currygood/MusicPlaySyncSpeakers/完整项目文档.md

说明：音频主节点具备完整功能；出于成本考虑，从节点使用现有的 ESP32-S3 开发板（如 ESP32-S3-N16R8），放弃“无主节点时切换为蓝牙模式、让手机连接播放音频”的功能，仅工作于同步模式：主节点启动并发送音频后，从节点接收并同步播放。语音唤醒与麦克风链路（esp-sr 唤醒词 + INMP441 采集 + HFP 上行）已整链路下线，主节点不再具备语音唤醒功能。

手机热点大概率不能当“路由器”做测试：音频虽是单播，但控制（5679）与灯控（8889）走组播，热点常把组播掐掉。

# ESP32 双设备无线音频同步系统 项目文档

> **项目定位**：基于 ESP32 的双设备无线音频同步系统，支持蓝牙音乐接收、本地 SD 卡解码播放，以及 **WiFi 单播音频同步分发**，实现两台音箱无感知同步播放，为低成本全屋智能音频系统提供可扩展的解决方案。

------

## 📖 项目概述

1. 本项目设计并实现了一套集**双设备无线音频同步**与**全屋智能家居联动**于一体的综合系统。系统包含三个核心节点：

   - **音频主节点（Master）**：ESP32-WROVER-E-N16R8，负责蓝牙 A2DP 音频接收、SD 卡本地解码、UDP 逐台单播分发，以及通过 UI 界面发起灯控指令。
   - **音频从节点（Slave）**：ESP32-WROVER-E-N16R8（与主节点同款，靠 NVS 角色配置区分；开发阶段先用现成的 ESP32-S3 开发板替代验证），接收主节点**单播**的 PCM 音频数据，按帧内基准播放时刻对齐出声，实现无感知同步播放。
   - **灯控节点（Light Controller）**：**ESP8266**，同时支持**局域网 UDP 组播接收**（来自音频主节点 UI 屏幕控制）和**巴法云 MQTT 接入**（来自米家 App / 小爱同学语音控制），通过**继电器**控制灯具开关（只有开 / 关，不调亮度）。

   ### 核心创新

   1. **高精度音频同步**：主节点给每一帧 PCM 打上统一的基准播放时刻 `t_play_us`，逐台单播到各从节点；从节点用「最小单程延迟」把主节点时间换算成本地时间，按同一时刻出声，全程不需要回包对时。主从残差只剩两端最小单程延迟之差（局域网 1~3ms），长期漂移用丢/插单个样点补偿。
   2. 双通道灯控闭环：
      - **本地 UI 控制链路**：ESP32 主节点 UI 界面 → UDP 组播（`239.0.0.2:8889`）→ ESP8266 灯控节点（局域网低延迟，不依赖公网）
      - **云端控制链路**：米家 App / 小爱同学 → 米家云 → 巴法云 MQTT → ESP8266 灯控节点（不经过 ESP32 主节点，接入米家生态）
   3. **WiFi 多路复用**：ESP32-WROVER-E-N16R8 的 WiFi 协议栈（lwIP）同时承载高实时性的 UDP 音频单播（逐台发往从节点 `:5680`）、UDP 控制组播（`239.0.0.1:5679`）与 UDP 灯控组播（`239.0.0.2:8889`）。

### 核心功能一览

| 功能模块 | 说明 |
| --- | --- |
| 蓝牙音频接收（A2DP Sink） | 主节点接收手机/平板蓝牙音频流 |
| 双设备音频同步（WiFi 单播） | 主节点把 PCM 逐台单播给各从节点，帧内带基准播放时刻，主从按同一时刻出声，回包为零 |
| **UI 屏幕灯控（UDP 组播）** | **主节点 UI 界面通过 UDP 组播控制 ESP8266 灯光，局域网低延迟** |
| **米家智能家居接入** | **ESP8266 通过巴法云 MQTT 接入米家生态，支持小爱同学语音控制** |
| 本地音乐播放（SD 卡） | 主节点播放 SD 卡 `/music` 下的 MP3（minimp3 解码，当前不支持 WAV），从节点无卡 |
| 播放控制（AVRCP） | 全局控制（播放/暂停/切歌/音量），同步至从节点 |
| LVGL 触摸屏界面 | 只有主音频节点配备 2.8 寸触摸屏，显示播放状态及**灯控入口**  |
| 双备份 OTA 升级 | 支持 WiFi 远程升级，具备失败自动回滚能力 |
| 节点角色配置 | 通过 NVS 存储角色标识，同一固件可配置为主节点或从节点 |

### 系统架构图

```reStructuredText
 ┌─────────────────────────────────────────────────────────────────┐
 │                         手机（音频源）                          │
 │                       (蓝牙 A2DP / AVRCP)                       │
 └──────────────────────────────┬──────────────────────────────────┘
                                │ 蓝牙音频流（SBC → PCM）
                                ▼
 ┌─────────────────────────────────────────────────────────────────┐
 │              主节点 (Master) - 房间 A                           │
 │  ┌───────────────────────────────────────────────────────────┐ │
 │  │           ESP32-WROVER-E-N16R8                             │ │
 │  │  • 蓝牙 A2DP 接收 / SD 卡解码 / I2S 功放本地播放          │ │
 │  │  • UDP 单播发送 (PCM + t_play_us) → 各从节点              │ │
 │  │  • 触摸屏 UI (LVGL)                                       │ │
 │  │  • 灯控入口（屏幕点一下开关灯）                           │ │
 │  └───────────────────────────────────────────────────────────┘ │
 └───────┬──────────────────────┬──────────────────────┬──────────┘
         │                      │                      │
         │ 链路①：音频同步     │ 链路②：UI 灯控      │ 链路③：云端灯控
         │ UDP 单播             │ UDP 组播             │ 米家 App / 小爱同学
         │ 各从机 :5680         │ 239.0.0.2:8889       │ → 米家云 → 巴法云 MQTT
         │ (PCM 音频数据)       │ (JSON 灯控指令)      │
         ▼                      ▼                      ▼
┌──────────────────┐   ┌──────────────────┐   ┌─────────────────┐
│  从节点 (Slave)  │   │                  │   │   米家云        │
│  - 房间 B        │   │                  │   │                 │
│                  │   │                  │   └────────┬────────┘
│ • UDP 单播接收   │   │                  │            │
│ • Jitter Buffer  │   │                  │            ▼
│ • 时间戳同步     │   │                  │   ┌─────────────────┐
│ • I2S 功放播放   │   │                  │   │  巴法云 MQTT    │
└──────────────────┘   │                  │   │  (bemfa.com)    │
                       │                  │   └────────┬────────┘
                       │                  │            │
                       │  链路② 直达      │  链路③ 直达│
                       │  (本地低延迟)    │  (云端控制)│
                       └────────┬─────────┴──────┬─────┘
                                │                │
                                ▼                ▼
                   ┌─────────────────────────────────────────────┐
                   │         ESP8266 智能灯控节点                │
                   │                                             │
                   │  ┌─────────────────────────────────────┐   │
                   │  │ 接收通道 1：UDP 组播 (239.0.0.2)    │   │
                   │  │ 来源：ESP32 主节点 UI 屏幕点击      │   │
                   │  │ 延迟：毫秒级（局域网直连）          │   │
                   │  └──────────────────┬──────────────────┘   │
                   │                     │                       │
                   │                     ▼                       │
                   │           ┌──────────────────┐              │
                   │           │ 指令融合处理     │              │
                   │           │ LED_Control_     │              │
                   │           │ Set_Light()      │              │
                   │           └────────┬─────────┘              │
                   │                     ▲                       │
                   │                     │                       │
                   │  ┌──────────────────┴──────────────────┐   │
                   │  │ 接收通道 2：巴法云 MQTT 订阅        │   │
                   │  │ 来源：米家 App / 小爱同学           │   │
                   │  │ 延迟：200~500ms（受公网影响）       │   │
                   │  └─────────────────────────────────────┘   │
                   │                                             │
                   │  输出：单路继电器（开 / 关）                │
                   └──────────────┬──────────────────────────────┘
                                 │
                                 ▼
                      ┌────────────────────┐
                      │  卧室灯（继电器）  │
                      │  开 / 关，不调光   │
                      └────────────────────┘
```

------

## 🧩 硬件要求

### 核心组件

| 组件 | 型号 | 说明 |
| :--- | :--- | :--- |
| **主控** | ESP32-WROVER-E-N16R8 | ESP32-D0WD 芯片，双核 240MHz，16MB Flash + 8MB PSRAM，支持蓝牙 v4.2 双模（BR/EDR + BLE），集成 802.11 b/g/n Wi-Fi |
| **显示屏** | 2.8 寸 IPS SPI 模块（ILI9341） | 320×240 分辨率，4 线 SPI，自带 Micro SD 卡槽 。只有音频主节点有 |
| **触摸屏** | 电容触摸（FT6336G） | I²C 接口 |
| **音频功放** | NS4168 | I2S 数字输入，单声道 D 类，2.5W 输出，内置 DAC |
| **存储卡** | Micro SD 卡（SPI 模式） | FAT32 格式，存放音频文件（/music）；UI 图片放 Flash storage 分区 |
| **扬声器** | 4Ω 3W 喇叭 | 单声道输出 |
| **电源** | 设计的板子有电源，用电池供电，可充电 | 为整板供电 |

> **⚠️ 重要提示**：
>
> - 通过 **NVS 配置区分角色**（主/从）。
> - 主从节点都不需要麦克风：语音唤醒链路已整链路下线。
> - UI 图片资源（3 张 PNG）随固件烧录进 Flash storage 分区，字体编译进固件；音乐文件从 SD 卡加载，Flash 双备份 OTA 不变。
> - 两个节点需连接**同一 WiFi 路由器**（同一局域网）：音频走单播，控制（5679）与灯控（8889）走组播。

### 显示屏模块详解（LCDWiki 2.8 寸 IPS SPI 模块）

该模块基于 **ILI9341V** 驱动芯片，采用 4 线制 SPI 串行总线，板载电平转换电路，兼容 5V 和 3.3V MCU。

**关键参数：**

| 参数 | 规格 |
| :--- | :--- |
| 屏幕尺寸 | 2.8 inch |
| 屏幕类型 | IPS（全视角） |
| 分辨率 | 240 × RGB × 320 (pixels) |
| 驱动 IC | ILI9341V |
| 显示接口 | 4-Line SPI |
| 最大颜色数  | 262K |
| 背光亮度 | 280 cd/m² |
| 触摸屏类型  | 电容触摸 |
| 触摸驱动 IC | FT6336G |
| 触摸接口 | I²C |
| **SD 卡槽** | 自带 Micro SD 卡槽，支持 SPI 模式 |

### 显示屏模块引脚定义

| 序号 | 引脚 | 功能说明 |
| :--- | :--- | :--- |
| 1 | VCC | 屏电源正（3.3V 或 5V） |
| 2 | GND | 屏电源地 |
| 3 | LCD_CS | 液晶屏片选控制信号，低电平有效 |
| 4 | LCD_RST | 液晶屏复位控制信号，低电平复位 |
| 5 | LCD_RS | 液晶屏命令/数据选择控制信号（DC） |
| 6 | SDI (MOSI) | SPI 数据输入 |
| 7 | SCK | SPI 时钟信号 |
| 8 | LED | 背光控制信号 |
| 9 | SDO (MISO) | SPI 数据输出 |
| 10 | T_IRQ | 触摸屏中断信号 |
| 11 | T_DO | 触摸屏 I²C 数据（或 SPI MISO） |
| 12 | T_DIN | 触摸屏 I²C 数据（或 SPI MOSI） |
| 13 | T_CS | 触摸屏片选（I²C 模式可不接） |
| 14 | T_SCK | 触摸屏时钟（I²C 模式为 SCL） |

### NS4168 音频功放详解

NS4168 是一款支持 I2S 数字音频信号输入、输出具有防失真功能的单声道 D 类音频功率放大器。

**关键特性：**

- **内置 DAC**：可直接接收 ESP32 的 I2S 数字音频信号并进行放大，无需外接其他解码芯片
- **工作电压**：3.0V ~ 5.5V
- **输出功率**：最高 2.5W（VDD=5V, RL=4Ω）
- **信噪比**：85dB
- **总谐波失真+噪声**：0.2%
- **采样率支持**：8kHz ~ 96kHz
- **功放类型**：D 类，无滤波器架构

**引脚定义：**

| 引脚  | 名称  | 功能 |
| :---- | :---- | :--- |
| Pin 1 | CTRL  | 控制/静音引脚（高电平使能，拉低静音） |
| Pin 2 | LRCLK | I2S 帧时钟（左右声道时钟） |
| Pin 3 | BCLK  | I2S 位时钟 |
| Pin 4 | SDATA | I2S 串行音频数据输入 |
| Pin 5 | VON | BTL 输出负端 |
| Pin 6 | VDD | 主供电引脚 |
| Pin 7 | GND | 信号地 |
| Pin 8 | VOP | BTL 输出正端 |
| Pin 9 | EP | 底部散热焊盘，连接大面积地平面 |

## 🔌 完整引脚接线表(完全针对项目，不需要使用完全上面提到的引脚)

> **⚠️ 重要说明**：ESP32-WROVER-IB 内部 SPI Flash 占用 **GPIO6~11**，这些引脚**不可用于外部电路**。以下分配已避开所有受限引脚。

### 推荐引脚分配（主节点 & 从节点通用，从节点省略触摸屏、SD卡）

| 模块 | 信号 | GPIO | 备注 |
| :--- | :--- | :--- | :--- |
| **LCD (SPI)** | LCD_CS | 4 | 片选 |
| | LCD_RST | 25 | 复位，不能少 |
| | LCD_RS (DC) | 22 | 命令/数据选择 |
| | MOSI | 18 | SPI 数据输入（与 SD 卡共用总线） |
| | SCK | 19 | SPI 时钟（与 SD 卡共用总线） |
| | MISO | 21 | SPI 数据输出（与 SD 卡共用总线） |
| | LED | 23 | 背光开关（只做开/关，不做 PWM 调光；Strapping 脚需谨慎） |
| **SD 卡 (SPI)** | SD_CS | 15 | 片选（与 LCD 分时复用 SPI 总线） |
| **触摸屏 (I²C)** | CTP_SDA | 32 | I²C 数据 |
| | CTP_SCL | 33 | I²C 时钟 |
| | CTP_INT | 轮询 | 触摸中断（可选）  用轮询 |
| | CTP_RST | 25 | 电容触摸屏复位控制信号，低电平复位 。不能少！！！，必须要软件复位，它不会自动复位 |
| **功放 (I2S)** | BCLK | 26 | I2S 位时钟 |
| | LRCLK | 27 | I2S 左右声道时钟 |
| | SDIN | 13 | I2S 数据输入 |
| | MCLK | 悬空 | 主时钟（NS4168 内部可倍频，无需外接） |
| 按键1 | 一端 | 36 | 另一端是GND，低电平有效，pcb设计要有上拉电阻，因为这个gpio口只有输入功能，里面没有内部上拉/下拉 |
| **电源** | VCC | - | 3.3V / 5V（按模块要求） |
| | GND | - | 公共地 |

1. **共用复位（GPIO 25）的时序兼容**： LCD 和触摸屏共用 GPIO 25 复位时，需确保两者的复位逻辑一致（均为低电平复位）。软件拉低 GPIO 25 后，**必须保持足够的低电平时间（建议 >20ms）**，以同时满足 LCD 和触摸屏的复位脉冲宽度要求，然后再拉高。   **直接一起在LCD屏复位的时候复位即可，后面初始化触摸屏就不需要复位了。**

2. Strapping 引脚的外部电路禁忌

   ： 对于使用的 Strapping 引脚（GPIO 15, 2, 5），外部电路绝对不能添加与之冲突的上下拉电阻。

   - **GPIO 15 (SD_CS)**：外部**严禁**接地或接下拉电阻，必须依靠内部上拉或外部上拉保持高电平。
   - **GPIO 2 (MIC_CLK)**：外部**严禁**接上拉电阻，必须依靠内部下拉或外部下拉保持低电平。
   - **GPIO 5 (MIC_WS)**：外部**严禁**接地或接下拉电阻。

3. **再次警告 GPIO 12**： 无论引脚多么紧张，**绝对不要**将任何外设分配到 GPIO 12。上电时若被拉高，会将模组内部 Flash/PSRAM 的供电电压强制切换为 1.8V，导致模组直接“变砖”且无法恢复。

### 灯控节点（ESP8266）

| 组件 | 型号 | 说明 |
| --- | --- | --- |
| 主控 | ESP8266 (NodeMCU / Wemos D1 Mini) | 单核 Tensilica L106 80/160MHz，4MB Flash，内置 WiFi 802.11 b/g/n |
| 继电器（卧室灯） | **单路 5V 继电器模块** | 干接点通断控制，**只有开 / 关，不调光**；`livingroom` 为预留，未接灯 |

###  ESP8266 灯控节点引脚接线表

⚠️ **重要说明**：灯控节点当前只驱动**一路继电器**（卧室灯），GPIO 输出高低电平控制通断；GPIO6~11 被内部 Flash 占用，不要使用。

| 模块 | 信号 | GPIO  | 备注 |
| --- | ---- | ----- | --- |
| 卧室灯 | IN | GPIO5 | 继电器控制脚（高电平吸合） |
| 电源 | VCC  | 3.3V  | |
| | GND  | GND | 公共地 |

## 🏗️ 软件架构

### 音频节点（从节点没有触摸屏、sd卡）

```reStructuredText
project/
├── main/                          # 主程序入口
│   ├── app_main.c
│   ├── idf_component.yml          # 外部组件依赖
│   └── CMakeLists.txt
├── components/
│   ├── bsp/                       # 板级支持包
│   │   ├── i2c_driver/            # I²C 驱动（触摸屏）
│   │   ├── i2s_driver/            # I²S 驱动（功放）
│   │   └── spi_driver/            # SPI 驱动（LCD + SD 卡）
│   ├── middlewares/               # 中间件
│   │   ├── LCD_Touch/             # ILI9341 + FT6336G 驱动
│   │   ├── amplifier/             # NS4168 驱动
│   │   ├── sd_card/               # SD 卡 SPI 驱动 + FATFS 挂载
│   │   ├── audio_decoder/         # MP3 解码（minimp3，只认 .mp3）
│   │   └── sync_protocol/         # 同步协议（逐台单播 + t_play_us）
│   ├── App/                       # 应用层
│   │   ├── MusicPlay/             # 音频播放引擎 + 播放源选择（蓝牙/本地）
│   │   ├── UI/                    # LVGL 界面（图片在 Flash storage 分区，字体编译进固件）
│   │   └── LightControl/          # 联动灯控节点模块
│   └── system/                    # 系统服务
│       ├── ota_manager/           # OTA 升级核心逻辑
│       ├── wifi_manager/          # WiFi 配网与连接管理
│       └── node_role/             # 节点角色管理（Master/Slave NVS 配置）
└── datasheet/                     # 参考资料
```

### 音频节点-外部组件依赖（idf_component.yml）

```yaml
dependencies:
  lvgl/lvgl: "^9"
  espressif/esp_lvgl_port: "^2"
  espressif/esp_bt_audio: "^1"
  espressif/esp-fatfs: "^1"
  # MP3 解码走 minimp3（工程内源码，不引外部解码器）；当前只支持 .mp3
```

### 灯控节点（ESP8266）

```reStructuredText
esp8266_light_controller/
 ├── main/
 │   ├── app_main.c                 # 主程序入口
 │   └── CMakeLists.txt
 ├── components/
 │   ├── bsp/
 │   │   ├── pwm_driver/            # 软件 PWM 封装
 │   │   └── wifi_manager/          # WiFi 连接/重连管理
 │   ├── middlewares/
 │   │   ├── LED_Control/           # 继电器输出（1 路，开/关）
 │   │   └── mqtt_client/           # 巴法云 MQTT 客户端
 │   └── App/
 │       ├── UDP_Multicast_Receiver/ # 【新增】UDP 组播接收（来自 ESP32 UI）
 │       └── BemFa_MQTT/            # 巴法云 MQTT（米家 App / 小爱接入）
```

### 

------

## 💾 音频主节点-分区表（双备份 OTA，16MB Flash）

> **注**：分区表按主节点实际 `partitions.csv` 列出（ESP32-WROVER-E-N16R8，16MB Flash）。从节点开发阶段为 ESP32-S3-N16R8（同为 16MB Flash），分区表也有 ota_0/ota_1 槽位，但 `ota_manager` 目前是空壳，OTA 尚未接线。

UI 图片资源（3 张 PNG）存放在 SPIFFS `storage` 分区（随固件烧录，见 `storage/ui_img/`）；`model` 为后续模型资源预留。

```csv
# Name,      Type, SubType,   Offset,    Size,      Flags
nvs,         data, nvs,       0x9000,    24K,
phy_init,    data, phy,       0xf000,    4K,
otadata,     data, ota,       0x10000,   8K,
ota_0,       app,  ota_0,     0x20000,   0x400000,  # 4MB
ota_1,       app,  ota_1,     0x420000,  0x400000,  # 4MB
model,       data, spiffs,    0x820000,  0x80000,   # 512KB
storage,     data, spiffs,    0x8A0000,  0x740000,  # 7.25MB（UI 图片，随固件烧录）
coredump,    data, coredump,  0xFE0000,  0x20000,   # 128KB
```

### 空间占用分析

| 分区 | 起始地址 | 结束地址 | 大小 | 说明 |
| :--- | :--- | :--- | :--- | :--- |
| Bootloader + 表头 | 0x0000 | 0x9000 | 36KB | 系统保留 |
| NVS | 0x9000 | 0xF000 | 24KB | 存储蓝牙配对信息、WiFi 凭据、节点角色等 |
| PHY Init | 0xF000 | 0x10000 | 4KB | 射频校准数据 |
| **otadata** | **0x10000**  | **0x12000**  | **8KB** | **OTA 启动选择标志** |
| *(空余)* | 0x12000 | 0x20000 | 56KB | 未分配 |
| **ota_0（固件区 A）** | **0x20000**  | **0x420000** | **4MB** | 当前运行固件 / 升级目标区 1 |
| **ota_1（固件区 B）** | **0x420000** | **0x820000** | **4MB** | 当前运行固件 / 升级目标区 2 |
| **model** | **0x820000** | **0x8A0000** | **512KB**  | SPIFFS；模型资源预留 |
| **storage（UI 图片）** | **0x8A0000** | **0xFE0000** | **7.25MB** | SPIFFS；存放 UI 图片（ui_img/ 3 张 PNG），随固件烧录 |
| **coredump** | **0xFE0000** | **0x1000000** | **128KB** | 崩溃现场转储 |

### 📊 空间使用总览

```reStructuredText
16MB Flash 布局 (0x000000 - 0x1000000)
├── 0x000000 - 0x009000  : Bootloader + 分区表 (36KB)
├── 0x009000 - 0x00F000  : NVS (24KB)
├── 0x00F000 - 0x010000  : PHY Init (4KB)
├── 0x010000 - 0x012000  : otadata (8KB)
├── 0x020000 - 0x420000  : ota_0 (4MB) ← 当前运行/升级目标
├── 0x420000 - 0x820000  : ota_1 (4MB) ← 当前运行/升级目标
├── 0x820000 - 0x8A0000  : model (512KB) ← 模型资源预留
├── 0x8A0000 - 0xFE0000  : storage (7.25MB) ← UI 图片（SPIFFS，随固件烧录）
└── 0xFE0000 - 0x1000000 : coredump (128KB)
```

------

## 🔁 FreeRTOS 任务设计-开发过程可能会更改（栈大小最可能更改）

### 音频-主节点任务

| 任务名 | 优先级 | 栈大小  | 核 | 功能 |
| :--- | :----- | :--- | :----- | :--- |
| **SyncLocalPlay_Task** | 12 | 4096 | Core 1 | 本地延迟队列取 PCM，按 `t_play_us + 60ms` 写 I2S |
| **SyncTx_Task** | 11 | 4096 | Core 0 | 打时间戳、UDP 逐台单播发送 |
| **bt_audio_task** | 11 | 4096 | Core 1 | 蓝牙事件 FIFO 出队，触发 `on_event`/`on_pcm` |
| **UI_Task** | 10 | 32768 | Core 0 | LVGL 界面交互与显示；图片从 Flash `/storage` 按需加载 |
| **audio_decoder 解码任务** | 10 | 4096 | Core 1 | SD 卡 MP3 流式解码 → `on_pcm` → `push_pcm` |
| **MusicPlay_Task** | 9 | 4096 | Core 1 | SD 选曲/播放控制/状态机 + 自动源选择（原 PlayMode，轮询 A2DP） |
| **wifi_mcast_rx** | 6 | 6144 | Core 0 | 组播收包 → FIFO（rx 启用的通道，如灯控通道 ack/status） |
| **SmartHome_Task** | 5 | 4096 | Core 0 | 处理 UI 灯控指令 UDP 组播发送；解析 ack / 30s status 上报并触发事件回调 |
| **ota_update / ota_sync**  | 5 | 12288 | Core 0 | 动态创建，执行固件下载与升级（完成后自销毁） |
| **Touch_Task** | 3 | 2048 | Core 0 | 触摸 IC（FT6336G）扫描，由模块内部创建 |
| **app_hb** | 2 | 3072 | Core 0 | 卡死定位心跳，不参与启动时序 |

### 音频-从节点任务

| 任务名 | 优先级 | 栈大小 | 功能 |
| :--- | :----- | :----- | :--- |
| **udp_audio_rx** | 11 | 4096 | UDP 单播收包 → 解析 20 字节包头 → 按 seq 写入 Jitter Buffer |
| **udp_audio_play** | 10 | 5120 | 从 Jitter Buffer 取 PCM，按 `t_play_us + offset + 60ms` 出声，丢/插单样点补偿漂移 |
| **ctl_rx** | 5 | 3072 | 控制通道收包（当前只处理 VOLUME），并每 3s 组播 ANNOUNCE |
| **wifi_mcast_rx** | 6 | 4096 | 组播收包写入通道 FIFO（`rx_enable` 的通道各创建） |

> **说明**：从节点跑「单播接收 → 抖动缓冲 → 按 `t_play_us + offset` 出声」一条链路，外加控制通道；WiFi 连接由 `wifi_manager` 走 esp_event 默认事件循环，不单独建任务。从节点 OTA 尚未接线（`ota_manager` 为空壳）。

> **任务间通信**：事件组（Event Group）用于状态切换通知，消息队列（Queue）传输 PCM 数据块。

### 灯控节点任务（ESP8266）

| 任务名 | 优先级 | 栈大小 | 功能 |
| --- | --- | --- | --- |
| **UDP_Multicast_Rx_Task** | **10** | **4096** | UDP 组播接收，监听 239.0.0.2:8889，处理来自 ESP32 UI 的灯控指令 |
| BemFa_MQTT_Task | 8 | 8192 | 连接巴法云 MQTT，订阅灯控主题，定时上报状态 |
| LED_Control_Task | 6 | 4096 | 解析指令，驱动继电器通断（开 / 关） |
| WiFi_Manager_Task | 4 | 4096 | WiFi 连接与断线重连 |

------

## 🌐 双设备同步协议设计

### 音频数据包格式（自定义轻量级 RTP）

主节点把同一份 PCM **逐台单播**到各从节点的 UDP `5680`（音频不走组播：Wi-Fi 组播无 ACK、无重传、被强制在基本速率，还会被 AP 按 DTIM 缓存，主从出声时刻会被拖出随机差），每个音频包携带约 **15ms** 的 PCM 数据，包头固定 **20 字节**：

```reStructuredText
┌───────┬─────────┬───────┬───────────┬─────┬───────────┬─────────────┬─────────┐
│ magic │ version │ flags │ stream_id │ seq │ t_play_us │ payload_len │ lead_ms │
│  2B   │   1B    │  1B   │    2B     │ 2B  │    8B     │     2B      │   2B    │
├───────┴─────────┴───────┴───────────┴─────┴───────────┴─────────────┴─────────┤
│      PCM payload（16bit / 44.1kHz / 单声道，默认 661 样点 = 1322 字节）       │
└───────────────────────────────────────────────────────────────────────────────┘
```

| 字段 | 大小 | 说明 |
| :--- | :----- | :--- |
| Magic | 2 字节 | 包起始标志 `0xAA55`，用于同步和过滤干扰 |
| Version | 1 字节 | 协议版本，当前 `2`；版本不符的包直接丢弃 |
| Flags | 1 字节 | `bit0 = 1` 表示本次流的首帧 |
| Stream ID | 2 字节 | 一次音频流的唯一标识（开始播放 / 切歌 / 重连时变化） |
| Seq | 2 字节 | 序列号，递增（0~65535 循环），从节点据此排序和检测丢包 |
| t_play_us | 8 字节 | 该帧的基准播放时刻（`esp_timer` 微秒），**不是发送时刻** |
| Payload Len | 2 字节 | 实际 PCM 数据长度（字节），不含包头 |
| Lead ms | 2 字节 | 提前量 D（毫秒），默认 200，从节点换算时刻偏移要用 |
| Audio Data  | 变长 | PCM 数据（16bit / 44.1kHz / 单声道），约 15ms 时长 |

> **包大小**：15ms × 44.1kHz × 2 字节 ≈ 1323 字节（661/662 样点交替取整），加 20 字节包头约 1343 字节，远小于 MTU 1500，不会 IP 分片。
>
> **时刻定义**：`t_play_us = 发送时刻 + D`，D 默认 200ms，存在 NVS 里可调。

### 控制命令包（端口 5679）

控制帧走组播 `239.0.0.1:5679`——一帧就能通知全部从节点，主节点不用维护 N 条连接。基础帧固定 4 字节：

```reStructuredText
+----------------+----------------+----------------+
|  Magic (0xAA55) |  Cmd (8bit)    |  Param (8bit) |
+----------------+----------------+----------------+
```

| 命令码 | 含义 | Param |
| :----- | :--- | :--- |
| 0x01 | PLAY | 0 |
| 0x02 | PAUSE | 0 |
| 0x03 | NEXT | 0 |
| 0x04 | PREV | 0 |
| 0x05 | VOLUME | 0~100 |
| 0x06 | RESET | 0（复位） |

扩展帧走同一通道，格式 `magic + type + len + data`，靠 type 区分：

| type | 含义 | 方向 |
| :--- | :--- | :--- |
| 0x12 | SYNC_START | 主节点 → 从节点（携带 stream_id / t0 / D） |
| 0x13 | SYNC_HEARTBEAT | 主节点 → 从节点（每秒一次） |
| 0x20 | PING | 帧格式保留，已不参与音频同步 |
| 0x21 | PONG | 帧格式保留，已不参与音频同步 |
| 0x30 | ANNOUNCE | 从节点 → 主节点（每 3s，用于发现和在线检测） |

> 音频同步靠音频包里的 `t_play_us` 完成，控制帧不参与对时。
> 从节点当前只处理 VOLUME（音量跟随主节点），其余命令与扩展帧忽略。

### 从节点公告帧（ANNOUNCE，0x30）

从节点每 3 秒在控制通道组播一帧公告，主节点据此维护「已连接从机」表：

| 字段 | 大小 | 说明 |
| :--- | :----- | :--- |
| ver | 1 字节 | 公告版本，当前 `1` |
| mac | 6 字节 | STA MAC，设备唯一身份 |
| ip | 4 字节 | 当前 IPv4 地址（网络字节序） |
| audio_port | 2 字节 | 音频接收端口（当前 5680） |
| volume | 1 字节 | 当前音量 0~100 |
| rssi | 1 字节 | 从节点侧 WiFi 信号强度（主节点无法单边测量） |
| flags | 1 字节 | 保留，当前 0 |
| token | 4 字节 | 固定 `0x53594E43`（"SYNC"），用于识别本协议 |
| name | 16 字节| UTF-8 设备名，默认「从机-XXXX」（MAC 末两字节）  |

- 主节点按 **MAC** 做 upsert（IP 由 DHCP 分配，可能变）；**10 秒**收不到公告判离线；上限 **8 台**；
- 收到第一份合法公告后，运行时从机表成为唯一权威；此前用编译期静态 IP 表兜底（兼容旧固件或从机没上电）。

------

## 🕒 同步机制详解（核心算法）

> 一句话：**发送端只负责把「这一帧该在什么时候响」写进包里，接收端只负责按这个时刻出声。** 两端不问对方时间，也不互相测延迟。

### 主节点：给每帧打上播放时刻

1. 音源 PCM（蓝牙 A2DP 或 SD 解码）统一进 `sync_protocol` 的入口环形缓冲（64KB，约 741ms）；
2. `SyncTx_Task` 按 **15ms** 切帧，帧内样点数在 661/662 之间交替，保证平均 44.1kHz；
3. 每帧盖一个 `t_play_us = 发送时刻 + D`（D 默认 200ms，NVS 可调）；
4. 同一帧做两件事：逐台**单播**给在线从节点；放进**本地延迟队列**（24 包）；
5. `SyncLocalPlay_Task` 在 `t_play_us + 60ms`（`SYNC_RX_MARGIN_US`）出队，单声道补成左右声道相同，经 `Amplifier_Play_Buffer()` 写 I2S。

主节点自己也等这 60ms，和从节点用的是同一个公式，所以主从同拍。

### 从节点：用最小单程延迟换算本地时刻

从节点不测 RTT、不发探测包，只按下面这套换算走：

```reStructuredText
d(i)   = 本地收到第 i 帧的时刻 − 该帧的 t_play_us
d_min  = 最近 64 帧里最小的 d(i)
offset = d_min + lead_ms × 1000 + 60ms
出声时刻 = t_play_us + offset
```

理由：`d(i)` 里的固定部分就是 `(从机时钟 − 主机时钟) − D`。取窗口最小值，等于取「主机时钟 + 最小单程延迟 L_min」——网络抖动和排队只会让 `d(i)` 变大，不会变小。把 D 和 60ms 余量加回去，两端就落在同一时间轴。

```c
/* 偏移冻结在开播那一刻，之后不再重算（重算会让时间轴跳一下） */
offset_us = s_d_min + (int64_t)s_lead_ms * 1000 + UDIO_MARGIN_US;  /* 60ms */
start_at  = (int64_t)t_play_us + offset_us;
```

**开播条件（preroll）**：至少 8 帧有效、偏移窗口满 10 个样本、缓冲深度达到提前量的 3/4（200ms × 3/4 = 150ms）。发送端短暂停手但缓冲里有货时（100ms 没有新包）也允许起播。

收包侧还有一层保护：64 个环形槽位（约 132KB PSRAM）按 `seq % 64` 定位，乱序先落槽，播放任务按 seq 顺序取。

### 为什么不需要 PING/PONG

- 音频同步靠包内 `t_play_us` + 「最小单程延迟」吸收抖动，**从节点一个回包都不用发**，主节点也不必有对时逻辑；
- `PING(0x20)` / `PONG(0x21)` 的帧格式还留在协议里（主节点收到 PING 仍回 PONG），但当前链路不依赖它；
- 残差就是两端最小单程延迟的差（局域网通常 1~3ms），远小于 200ms 提前量，听不出来。

> 早期方案（v1）是「PING/PONG 测 RTT 估 `clock_offset`」，需要往返、受排队延迟影响、还得靠心跳纠偏。v2 改成「发送端直接给播放时刻」，整条回包链路省掉了。

### 长期漂移：丢 / 插单个样点，不改采样率

两块板子的晶振差几十 ppm，放久了必然错开。

- **观测量**：抖动缓冲的「跑道」= 最近收到的 `t_play` − 正在播放帧的 `t_play`。只有它同时跨越主从两个晶振，能看见漂移；跑道变长说明从机慢，变短说明从机快。
- 开播 200 帧后（DMA 瞬态过去）把当前跑道均值定为基准；之后用 1/32 的滑动平均跟着走。
- 偏差超过 **4ms** 死区、且距上次调整 ≥ **20ms** 才动手：**丢一个样点**（时间轴加快一个样本）或**插一个样点**（放慢），拼接处用前一个输出样本做 8 点线性过渡，把台阶摊成约 0.2ms 的缓变，避免「咔哒」声。
- **不调 `i2s_set_clk()`** —— 那要 disable → reconfig → enable，会把 DMA 里还没播的音频整块丢掉。

### 异常处理

| 场景 | 处理 |
| :--- | :--- |
| 丢包（seq 不连续） | 用上一帧做 PLC 补一帧，不让 I2S 欠载出爆音 |
| 迟到帧（时刻已过） | 直接丢弃并计数，绝不让播放时间轴倒退 |
| 重复帧 | 丢弃 |
| 断流 > 500ms | 清空缓冲区重新 preroll，等下一段数据 |
| 缓冲过深 > 450ms | 跳到较新的位置、保留约 150ms，防止延迟越积越多 |
| 主节点重启 / 切歌 | `stream_id` 变化 → 重新收包、重算 `offset` |
| 开播瞬间 | 首帧 128 点淡入（≈2.9ms），避免 DMA 从静音切到音频时的「啪」 |

### 同步精度

主从残差 = 两端最小单程延迟之差（局域网 1~3ms）。短时抖动由 200ms 提前量 + 60ms 接收余量 + 64 槽抖动缓冲吸收；长期漂移由 sample slip 拉回，稳态偏差控制在 4ms 死区以内。

------

## 📡 WiFi 网络与跨设备联动配置

| 项目 | 配置 |
| --- | --- |
| WiFi 模式 | 所有节点（音频主/从、ESP8266）均连接 **同一路由器**（Station 模式） |
| **音频单播** | **UDP 各从机 :5680**，20 字节头 + PCM，逐台发送，不走组播 |
| **控制组播** | **UDP 239.0.0.1:5679**，命令 / 音量 / 从节点公告（ANNOUNCE） |
| **灯控组播（UI 控制）** | **UDP 239.0.0.2:8889**，JSON 格式灯控指令，来自 ESP32 UI 屏幕 |
| **MQTT 通信（米家 / 小爱）** | **巴法云 MQTT (bemfa.com:9501)**，ESP8266 订阅灯控主题 |
| **路由器要求** | 建议开启 IGMP Snooping（组播侦听）：音频走单播不受影响，控制组播与灯控组播不开泛洪更干净。 |

> **备选方案（无路由器）**：可使用 **ESP-NOW** 或 **WiFi P2P（SoftAP + Station）** 直连，但推荐路由器方案，调试最简单，且可扩展至更多设备。

### ESP32 与 ESP8266 通信协议（UDP 组播）

**下发指令（JSON，主节点 → `239.0.0.2:8889`）**：

```json
{
  "cmd": "on",
  "light": "bedroom",
  "version": 1
}
```

| 字段 | 说明 |
| --- | --- |
| cmd | 指令：`on` / `off`（继电器只有开 / 关，没有亮度） |
| light | 目标灯：`bedroom`（当前唯一一盏继电器灯；`livingroom` 为预留） |
| version | 协议版本，当前 `1`；版本高于本端支持时灯控节点回 `verr` |

**上行回执与状态（灯控节点 → 主节点）**：

```json
{"cmd": "ack", "light": "bedroom", "ok": true, "version": 1}
```

- 每执行一条指令回一次 `ack`，主节点据此确认指令落地；
- 之后每 **30 秒**主动上报一次状态，格式相同、`cmd` 为 `status`，主节点据此刷新开关状态；
- 断网期间灯控节点仍靠本地状态工作，恢复后自动重连 MQTT 并继续上报。

**ESP32 端代码示意（UI 点击灯控按钮）**：

```c
// ESP32 主节点：UI 上点一下灯泡卡片，经灯控通道组播下发（cJSON 组包）
void ui_bedroom_light_on_click(void) {
    cJSON *root = cJSON_CreateObject();
    cJSON_AddStringToObject(root, "cmd", "on");
    cJSON_AddStringToObject(root, "light", "bedroom");
    cJSON_AddNumberToObject(root, "version", 1);

    char *payload = cJSON_PrintUnformatted(root);
    /* 通道由 app_main 经 wifi_manager_mcast_open() 创建：239.0.0.2:8889，rx 开启 */
    wifi_manager_mcast_send(s_light_chan, payload, strlen(payload), 0);

    free(payload);
    cJSON_Delete(root);
}
```

**ESP8266 端代码示意（UDP 组播接收）**：

```c
// ESP8266 灯控节点：加入灯控组播组并接收指令
void udp_multicast_receiver_task(void *pvParameters) {
    int sock = socket(AF_INET, SOCK_DGRAM, 0);
    struct sockaddr_in server_addr = {
        .sin_family = AF_INET,
        .sin_port = htons(8889),
        .sin_addr.s_addr = INADDR_ANY
    };
    bind(sock, (struct sockaddr*)&server_addr, sizeof(server_addr));
    
    // 加入灯控组播组（触发 IGMP Join）
    struct ip_mreq imreq;
    imreq.imr_multiaddr.s_addr = inet_addr("239.0.0.2");
    imreq.imr_interface.s_addr = IPADDR_ANY;
    setsockopt(sock, IPPROTO_IP, IP_ADD_MEMBERSHIP, &imreq, sizeof(struct ip_mreq));
    
    char buf[256];
    while(1) {
        int len = recv(sock, buf, sizeof(buf), 0);
        if (len > 0) {
            buf[len] = '\0';
            // 解析 JSON 并控制 LED
            parse_and_control_led(buf);
        }
    }
}
```

## 🔄 OTA 升级流程

### 音频节点（ESP32）

采用双备份 OTA 分区（ota_0 / ota_1），支持远程升级与异常回滚。

### 灯控节点（ESP8266）

ESP8266 采用单分区 OTA（4MB Flash），通过 HTTP 下载新固件并写入备用区域，重启后自动切换。

## 🧪 验证测试方案

| 测试场景 | 预期结果 |
| --- | --- |
| 启动同步测试 | 主节点开始播放后，从节点约 200ms 后同步出声，无明显时间差 |
| **从机发现测试** | **从节点上电后 3s 内出现在主节点设置页「已连接 N/M」列表，名称/IP/RSSI 正确；断电 10s 后判定离线，列表变灰。** |
| **UI 灯控联动测试**  | **ESP32 UI 界面点一下开关后，ESP8266 继电器动作、灯卡片状态同步刷新（局域网直连的毫秒级），同期音频单播不卡顿、不失步。** |
| **云端灯控测试** | **米家 App 点开关（或小爱同学说"打开卧室灯"），ESP8266 响应延迟 < 500ms（受公网影响），灯光状态同步正常。** |
| **双通道并发测试** | **同时通过 UI 屏幕和米家 App 控制灯光，ESP8266 能正确处理两种指令，无冲突、无死锁。** |
| 网络干扰测试 | 手机下载大文件占用 WiFi 带宽，从节点偶有丢包但不崩溃，声音短暂静音后恢复 |
| 长时间播放测试 | 两设备声音不出现"重影"或"回声"（时钟漂移校正有效） |

------

## ✨ 功能详细说明

### 1. 蓝牙音频接收

- 主节点作为 A2DP Sink 连接手机，接收 SBC 音频流。
- 解码出的 PCM 同时进本地延迟队列（本机出声）和发送队列（逐台单播给从节点）。

### 2. 双设备同步播放（核心创新）

- **单播分发**：主节点把同一份 PCM 逐台单播到从节点 `:5680`，帧内 20 字节头带 `t_play_us`（= 发送时刻 + 200ms 提前量）。
- **从节点接收**：按 `seq` 落进 64 槽抖动缓冲，用「最小单程延迟」换算出本地出声时刻，到点才写 I2S。
- **同步残差**：两端最小单程延迟之差（局域网 1~3ms），听不出先后。
- **容错处理**：断流超过 500ms 清空缓冲重新等数据；迟到帧直接丢，不让时间轴倒退；漂移用丢/插单个样点拉回。

### 3. 本地音乐播放（SD 卡）

- 只有主节点有 SD 卡，播放 `/music` 下的 MP3（minimp3 流式解码，当前不支持 WAV）。
- 从节点没有卡、也不解码，只负责接收 PCM 并按时刻出声。

### 4. LVGL 图形界面（图片在 Flash storage 分区，字体编译进固件）

- 显示当前播放源（蓝牙/本地）、歌曲信息、进度条、控制按钮。
- 从节点没有屏，它的在线状态由主节点设置页的「已连接 N/M」列表反映（绿点在线 / 灰点失联）。
- 支持切换主/从模式（需重启生效）。

### 5. AVRCP 控制（双向同步）

- 手机端控制（播放/暂停/切歌）通过 AVRCP 同步至主节点，主节点再通过控制组播下发；从节点当前只响应 VOLUME 帧（音量跟随），播控命令暂未响应。

### 6. UI 屏幕灯控（UDP 组播，本地低延迟）

音频主节点通过 LVGL UI 界面提供灯光控制入口，与 ESP8266 智能灯控节点深度联动：

- **通信机制**：`SmartHome_Task` 在局域网内通过 **UDP 组播（239.0.0.2:8889）** 向 ESP8266 发送 JSON 格式的控制指令。
- **执行端**：ESP8266 的 `UDP_Multicast_Rx_Task` 加入灯控组播组，收到指令后驱动继电器通断，并回 `ack`；此后每 30s 主动上报一次 `status`。只有一盏继电器灯（`bedroom`），没有调光能力。
- 优势：
  - **局域网低延迟**：UI 点击直接发局域网组播，不经过云端
  - **不依赖公网**：即使家里断网，UI 仍可控制灯光
  - **多节点扩展**：未来增加 ESP8266 灯控节点，只需加入同一组播组即可
- **并发保障**：灯控组播（`239.0.0.2:8889`）、控制组播（`239.0.0.1:5679`）与音频单播（各从机 `:5680`）各自独立 socket，lwIP 里互不阻塞。

### 7. 云端灯控（米家 App / 小爱同学，走巴法云 MQTT）

这条链路不经过 ESP32 主节点，是灯控节点自己的第二条入口：

- 控制链路：
  1. 在米家 App 里点开关，或对小爱同学说"打开卧室灯"
  2. 指令经米家云 → 巴法云 MQTT → ESP8266 灯控节点
  3. ESP8266 执行后回 `ack`，并每 30s 上报一次状态
- **执行端**：ESP8266 的 `BemFa_MQTT_Task` 订阅巴法云主题（`bedroom002` / `livingroom002`），接收米家下发的灯控指令并执行。
- 优势：
  - **接入米家生态**：支持米家 App 和小爱同学语音控制
  - **云端远程控制**：即使不在家，也可通过手机 App 控制灯光
  - **状态同步**：ESP8266 每 30 秒向巴法云上报当前灯光状态，米家 App 显示与实际一致

### 8. 双通道灯控的统一执行

ESP8266 灯控节点同时处理来自两个通道的指令：

| 控制来源 | 通信方式 | 延迟 | 适用场景 |
| --- | --- | --- | --- |
| **ESP32 UI 屏幕** | UDP 组播（`239.0.0.2:8889`） | 毫秒级 | 本地快速控制，不依赖公网 |
| **米家 App / 小爱** | 巴法云 MQTT | 200~500ms | 语音控制、远程控制、米家联动 |

**指令融合**：两个通道的指令最终都调用同一个 `LED_Control_Set_Light()` 函数，状态天然一致，互不冲突。无论通过哪种方式控制，灯光状态都会同步更新，并通过巴法云上报至米家 App。

------

## 🛠️ ESP-IDF 关键配置（menuconfig）

```bash
# WiFi 与组播
CONFIG_LWIP_IPV4=y
CONFIG_LWIP_MULTICAST=y
CONFIG_LWIP_IGMP=y

# OTA
CONFIG_ESP_OTA=y
CONFIG_BOOTLOADER_APP_ROLLBACK_ENABLE=y

# FATFS 长文件名
CONFIG_FATFS_LONG_FILENAMES=y

# 蓝牙
CONFIG_BT_ENABLED=y
CONFIG_BT_BLUEDROID_ENABLED=y
CONFIG_BT_CLASSIC_ENABLED=y
```

------

## 📊 性能指标

| 指标 | 数值 |
| :--- | :--- |
| 音频同步残差 | 两端最小单程延迟之差（局域网 1~3ms）  |
| 音频单播带宽 | ~0.7 Mbps / 台（PCM 44.1kHz/16bit 单声道） |
| 启动同步时间 | < 2s |
| WiFi 覆盖范围  | 标准家庭环境（2.4GHz） |
| 最大支持节点数 | 理论可达 8~16 个（受限于 WiFi 带宽）  |

------

## 🧪 验证测试方案

| 测试场景 | 预期结果 |
| :--- | :--- |
| **启动同步测试** | 主节点开始播放后，从节点约 200ms 后同步出声，无明显时间差 |
| **长时间播放测试（30 分钟）** | 两设备声音不出现“重影”或“回声” |
| **网络干扰测试** | 手机下载大文件占用 WiFi 带宽，从节点偶有丢包但不崩溃，声音短暂静音后恢复 |
| **音量跟随测试** | 主节点调音量后，从节点在下一个 VOLUME 帧到达时同步调整（从节点当前只处理 VOLUME） |
| **主节点切歌** | 切歌后 stream_id 变化，从节点清盘重新 preroll，不残留上一首的音频 |
| **角色切换测试** | 通过 NVS 修改角色配置，重启后主/从角色正确切换 |

------

## 📖 参考资料

- [ESP-IDF 编程指南](https://docs.espressif.com/projects/esp-idf/zh_CN/latest/)
- [ESP32-WROVER-B & WROVER-IB 技术规格书](https://www.espressif.com/sites/default/files/documentation/esp32-wrover-b_esp32-wrover-ib_datasheet_cn.pdf)
- [LVGL 官方文档](https://docs.lvgl.io/)
- [ESP-ADF 音频应用开发框架](https://docs.espressif.com/projects/esp-adf/zh_CN/latest/)
- [RFC 3550 RTP 协议（用于时间戳参考）](https://tools.ietf.org/html/rfc3550)
- [LCDWiki 2.8 寸 IPS SPI 模块](http://www.lcdwiki.com/zh/2.8inch_IPS_SPI_Module_ILI9341)
- [NS4168 数据手册](https://./datasheet/NS4168.pdf)

------

## ✍️ 项目经历（简历描述）

**项目名称**：基于 ESP32 的双设备无线音频同步与智能家居联动系统

**项目描述**：设计并实现了一套集双音箱音频同步与全屋灯光联动于一体的智能系统。通过蓝牙 A2DP 接收音频，给每帧 PCM 打上统一播放时刻后逐台单播到各从音箱；**同时复用 ESP32 自身 WiFi，通过 UDP 组播与 ESP8266 灯控节点通信，实现 UI 屏幕低延迟本地控制。** 从音箱按帧内 `t_play_us` 对齐出声，残差只剩两端最小单程延迟之差。ESP8266 灯控节点同时接入巴法云 MQTT，**支持米家 App 与小爱同学直接控制灯光**，实现本地 UI 与云端语音的双重控制闭环。

**核心贡献**：

1. 设计轻量级同步协议与 Jitter Buffer，结合动态采样率微调算法，有效补偿晶振漂移与网络抖动。
2. **音频数据面用 UDP 单播逐台推送（带逐客户端 ACK 与自适应速率），控制与灯控用组播一跳通知全部节点，避开组播在 Wi-Fi 上无 ACK、被强制基本速率、按 DTIM 缓存的问题。**
3. **设计并实现与局域网内 ESP8266 智能家居节点的 UDP 组播联动机制，实现 UI 屏幕本地灯控（局域网直连，不依赖公网）。**
4. **ESP8266 灯控节点通过巴法云 MQTT 接入米家生态，支持米家 App 与小爱同学直接控制灯光，实现本地 UI 与云端语音的双重控制闭环。**
5. 基于 LVGL 开发双设备状态监控与灯控交互界面，采用 16MB Flash 双备份 OTA 分区支持远程升级与异常回滚。

**涉及技术**：ESP-IDF、ESP8266 RTOS SDK、FreeRTOS、UDP 单播 / 组播、TCP/MQTT 并发通信、巴法云 MQTT、I2S 音频驱动、LVGL、OTA、蓝牙 A2DP/AVRCP。
