currygood/MusicPlaySyncSpeakers/note/I2S问题排查和I2S使用教程.md

## 一、I2S 协议基础与 ESP32 资源

I2S 是数字音频接口，主要信号线包括：

- **BCLK**：位时钟，决定每一位数据的传输节奏。
- **WS / LRCLK**：声道选择时钟，区分左右声道。
- **SD**：串行数据线，音频数据从这里进出。
- **MCLK**：主时钟，很多 codec、功放需要，ESP32 可以输出。

主从模式上，ESP32 通常作为 **主机 Master**，产生 BCLK、WS、MCLK；外设作为从机，按 ESP32 的时钟收发数据。

常见数据格式有标准 I2S、左对齐、右对齐、TDM、PDM。格式不匹配，是后面很多“没声音、噪声、左右反”的根源。

关键公式：

**BCLK = 采样率 × 声道数 × 位深**

例如 44.1kHz、立体声、16bit：BCLK ≈ 44100 × 2 × 16 = 1.4112MHz。MCLK 常见为 256×fs 或 384×fs。

ESP32 一般有 **I2S0、I2S1** 两个控制器，支持主机/从机、发送 TX / 接收 RX、全双工 / 半双工、DMA 搬运、APLL 时钟、标准 I2S 和 PDM 等格式。

------

## 二、I2S 配置与读写流程

ESP-IDF 下使用 I2S，核心流程是：**选择模式 → 填写配置 → 安装驱动 → 设置引脚 → 设置时钟 → 读写数据**。

### 1. 选择模式

- 播放：`I2S_MODE_MASTER | I2S_MODE_TX`
- 录音：`I2S_MODE_MASTER | I2S_MODE_RX`
- PDM 麦克风：再加 `I2S_MODE_PDM`

### 2. 填写 `i2s_config_t`

关键字段包括：

- `sample_rate`：采样率，如 44100、16000。
- `bits_per_sample`：位深，如 16bit、24bit、32bit。
- `channel_format`：左右声道格式。
- `communication_format`：标准 I2S / 左对齐 / 右对齐 / PDM。
- `dma_buf_count`、`dma_buf_len`：DMA 缓冲区数量和长度。
- `use_apll`：是否使用 APLL 提高时钟精度。
- `tx_desc_auto_clear`：发送描述符自动清零，减少爆音。
- `intr_alloc_flags`：中断分配标志。

### 3. 安装驱动与设置引脚

- `i2s_driver_install(port, &config, 0, NULL)`
- `i2s_set_pin(port, &pin_config)` 或使用默认引脚 `i2s_set_pin(port, NULL)`
- 需要核对 BCK、WS、SD、MCLK 是否接对。

### 4. 设置时钟

- `i2s_set_clk`
- `i2s_set_sample_rates`

### 5. 播放与录音

- 播放：循环调用 `i2s_write` 写 PCM 数据。
- 录音：循环调用 `i2s_read` 读 PCM/PDM 数据。
- 注意返回值、实际写入/读取长度、超时处理。

------

## 三、实战与工程优化

实战部分主要有两个方向：

- **主机模式音频播放**：生成正弦波 PCM 数据，配置 I2S 为 TX 主机，通过 DMA 循环写入，用示波器或喇叭验证波形和声音。这是排查“没声音”的基础手段：先播放已知信号，再查外设。
- **PDM 数字麦克风采集**：配置 `I2S_MODE_PDM`，设置 PDM 过采样率和时钟，用 `i2s_read` 读取数据，注意 PDM 数据可能落在左/右声道，需要转换或滤波。

工程优化方面，文章强调：

- **APLL**：提高采样率精度，减少音调偏差。
- **DMA 双缓冲/多缓冲**：防止断音、卡顿。
- **DMA 专用内存**：用 `heap_caps_malloc(..., MALLOC_CAP_DMA)` 分配。
- **任务优先级**：音频任务不能太低，否则被 WiFi、蓝牙、日志抢占。
- **缓冲区大小**：太小会断流，太大会延迟。
- **抗干扰**：电源、地线、时钟线、屏蔽、功放使能脚都要注意。
- **最佳实践**：先通时钟，再通数据；先正弦波，再真实音频；先小缓冲，再逐步调大。

------

## 四、高频踩坑排查（重点）

排查部分按现象分类，基本逻辑是：**先看时钟，再看格式，再看 DMA/任务，最后查硬件和电源。**

### 1. 完全没声音、输出异常

**现象**：程序能跑，`i2s_write` 也返回了，但喇叭没声，或者只有噪声。

**常见原因**：

- I2S 格式不匹配：标准 I2S、左对齐、右对齐搞混。
- 位深、声道格式配置错误。
- 引脚接错：BCK、WS、SD、MCLK 接错，或者输入输出接反。
- 主从模式搞反：ESP32 设成从机，外设也设成从机。
- 未开 APLL，采样率偏差太大。
- 功放/codec 的使能脚、静音脚没拉对。
- MCLK 没接，但外设又必须依赖 MCLK。

**排查思路**：

- 先播放已知正弦波，不要一上来就播复杂音频。
- 用示波器/逻辑分析仪测 BCLK、WS、SD 有没有波形。
- 核对引脚定义和外设手册。
- 降低采样率、位深、声道数做最小系统测试。
- 检查功放是否使能、是否静音。

### 2. 声音卡顿、断音、爆音

**现象**：声音一顿一顿，或者有噼啪声、爆音。

**常见原因**：

- DMA 缓冲区数量太少，或单缓冲区太小。
- 音频任务优先级太低，被其他任务抢占。
- 缓冲区没分配在 DMA 可访问内存。
- `i2s_write` 写入不完整或超时。
- 音频源读取太慢，供不上数据。
- WiFi/蓝牙中断、日志输出影响实时性。
- 电源跌落，功放瞬时电流不够。

**解决方向**：

- 增加 `dma_buf_count` 和 `dma_buf_len`。
- 提高音频任务优先级。
- 用 `heap_caps_malloc` + `MALLOC_CAP_DMA` 分配 DMA 内存。
- 使用双缓冲/环形缓冲。
- 检查 `i2s_write` 返回值，处理超时和短写。
- 必要时关日志、提高 CPU 频率、优化电源。

### 3. 音调不对、快放或慢放

**现象**：声音变尖、变沉，或者播放速度明显不对。

**常见原因**：

- 采样率配置与实际音频源不一致。
- 未使用 APLL，APB 时钟精度不够。
- 位深配置错误，如 16bit 当成 8bit。
- BCLK 分频计算错误。
- 音频数据本身采样率与配置不符。

**解决方向**：

- 开启 `use_apll`。
- 核对 `sample_rate`、`bits_per_sample`、`channel_format`。
- 用示波器测 BCLK 实际频率，反推采样率。
- 对音频源做重采样，保证数据与配置一致。

### 4. 声道错位、左右反了

**现象**：左右声道颠倒，或者人声跑到一边。

**常见原因**：

- `channel_format` 配错，如 `RIGHT_LEFT` / `LEFT_RIGHT` 搞反。
- 标准 I2S 与左对齐/右对齐格式差异。
- PDM 麦克风数据实际落在另一个声道。
- 硬件左右声道接反。

**解决方向**：

- 切换声道格式测试。
- 软件交换左右声道数据。
- 检查 codec 寄存器配置。
- PDM 模式下确认声道映射。

### 5. PDM 麦克风没声音

**现象**：普通 I2S 播放正常，但 PDM 麦克风读不到数据。

**常见原因**：

- 没开 `I2S_MODE_PDM`，还按普通 I2S 配。
- PDM 过采样率、时钟频率不匹配。
- 麦克风时钟/数据脚接错。
- 声道映射错误，数据在右声道却只读左声道。
- 麦克风供电、使能脚没处理好。

**解决方向**：

- 确认 `mode` 包含 `I2S_MODE_PDM`。
- 核对 PDM 时钟频率，如 1.024MHz、2.048MHz 等。
- 读原始数据，看是否有变化。
- 切换左右声道测试。
- 参考官方 PDM 示例，先跑通再改。

### 6. 录音噪声大、数据错乱

**现象**：能录到声音，但底噪大、数据错位、破音。

**常见原因**：

- 电源噪声、地线处理不好。
- 时钟线太长、没有屏蔽。
- DMA 内存冲突或读取不及时溢出。
- 格式转换错误。
- `i2s_read` 返回长度没处理。

**解决方向**：

- 加滤波、缩短走线、屏蔽时钟线。
- 独立电源、加去耦电容。
- 提高音频任务优先级，及时读取。
- 检查 `i2s_read` 返回长度和格式转换。
- 用逻辑分析仪看 WS、BCLK、SD 时序。

------

## 五、总结

I2S 使用核心是：**时钟 + 格式 + DMA + 任务**。

配置时，先确认主从、采样率、位深、声道格式，再安装驱动、设置引脚、开启 APLL、配置 DMA 缓冲，最后通过 `i2s_write` / `i2s_read` 读写数据。

排查时，也按这个顺序反查：

- 没声音：先查时钟和格式，再查引脚、使能、主从。
- 卡顿爆音：查 DMA 缓冲、任务优先级、内存类型、电源。
- 音调不对：查采样率、位深、APLL、BCLK 实际频率。
- 左右反：查声道格式、codec 配置、PDM 声道映射。
- PDM 没声：查 PDM 模式、时钟频率、声道映射、供电。
- 噪声大：查电源、地线、屏蔽、读取时序和格式转换。

一句话：**I2S 用不好，先看时钟，再看格式，再看 DMA 和任务，最后查硬件和电源。**
