currygood/MusicPlaySyncSpeakers/docs/02-设计/MQTT接入规范.md

# MQTT 接入规范

> 整理《项目文档.md》中巴法云 MQTT 相关分散说明，形成接入规范草稿；未定义项标注待补充。

| 项目 | 内容 |
| :--- | :--- |
| 文档名称 | MQTT 接入规范 |
| 文档版本 | v0.1（草稿） |
| 编制日期 | 2026-09-15 |

------

## 1 接入链路

> 这条链路**不经过 ESP32 主节点**：
>
> 1. 在米家 App 里点开关，或对小爱同学说"打开卧室灯"
> 2. 米家云 → 巴法云 MQTT → ESP8266 灯控节点
> 3. ESP8266 执行后回 `ack`，并每 30 秒上报一次状态
>
> 主节点侧的 HFP 语音唤醒（长按按键 + INMP441 采集）已整链路下线，不再参与灯控。

## 2 连接参数

> | **MQTT 通信（米家 / 小爱）** | **巴法云 MQTT (bemfa.com:9501)**，ESP8266 订阅灯控主题     |

## 3 主题与状态上报

- 订阅主题：`bedroom002`（卧室灯，当前唯一一盏继电器灯）；`livingroom002` 为预留，未接实际灯。
- 上报周期：每 30 秒上报一次当前灯光状态。

> 摘录：  - **状态同步**：ESP8266 每 30 秒向巴法云上报当前灯光状态，米家 App 显示与实际一致

## 4 接收端实现（ESP8266）

> 任务：| BemFa_MQTT_Task           | 8      | 8192     | 连接巴法云 MQTT，订阅灯控主题，定时上报状态                  |

> 软件结构：

```reStructuredText
esp8266_light_controller/
 ├── main/
 │   ├── app_main.c                 # 主程序入口
 │   └── CMakeLists.txt
 ├── components/
 │   ├── bsp/
 │   │   ├── gpio_driver/           # esp-idf的gpio封装
 │   │   └── wifi_manager/          # WiFi 连接/重连管理
 │   ├── middlewares/
 │   │   ├── LED_Control/           # 灯的控制
 │   │   └── mqtt_client/           # 巴法云 MQTT 客户端
 │   └── App/
 │       ├── UDP_Multicast_Receiver/ # UDP 组播接收（来自 ESP32 UI）
 │       └── BemFa_MQTT/            # 巴法云 MQTT（米家 App / 小爱接入）
```

## 5 双通道灯控；统一执行

| 控制来源 | 通信方式 | 延迟 | 适用场景 |
| --- | --- | --- | --- |
| **ESP32 UI 屏幕** | UDP 组播（`239.0.0.2:8889`） | < 50ms | 本地快速控制，不依赖公网 |
| **米家 App / 小爱** | 巴法云 MQTT | 200~500ms | 语音控制、远程控制、米家联动 |

**指令融合**：两个通道的指令最终都调用同一个 `LED_Control_Set_Light()` 函数，状态天然一致，互不冲突。无论通过哪种方式控制，灯光状态都会同步更新，并通过巴法云上报至米家 App。

## 6 待补充项

- 报文 payload 格式、鉴权（token/密钥）、QoS、遗嘱/保留策略：开发期补充（参考巴法云平台文档）。
