currygood/MusicPlaySyncSpeakers/docs/02-设计/系统设计说明书.md

> 说明：音频主节点具备完整功能；从节点目标硬件与主节点同为 ESP32-WROVER-E-N16R8，开发阶段暂用现有的 ESP32-S3 开发板（如 ESP32-S3-N16R8）替代验证（Play_Slave 工程 sdkconfig 当前为 esp32s3），放弃“无主节点时切换为蓝牙模式、让手机连接播放音频”的功能。从节点不需要 ASR 语音唤醒与 5 分钟超时切换逻辑，仅工作于同步模式：主节点启动并单播音频后，从节点直接接收并同步播放。
>
> 手机热点大概率不能作为“路由器”来进行测试UDP组播
>

# ESP32 双设备无线音频同步与智能家居联动系统 系统设计说明书

> 本文档整理自《项目文档.md》，仅保留与**系统设计**直接相关的内容（系统概述与架构、硬件平台、软件架构、分区与OTA、任务设计、同步协议、同步算法、网络联动、功能设计、关键配置、性能指标）。测试方案、硬件模块详解与引脚接线表、简历描述等不属于系统设计范畴的内容已移除，相关专题由对应文档（测试计划、硬件设计说明、引脚分配表等）承接。

> **项目定位**：基于 ESP32 的双设备无线音频同步系统，支持蓝牙音乐接收、本地 SD 卡解码播放，以及 **WiFi 单播音频同步分发**，实现两台音箱无感知同步播放，为低成本全屋智能音频系统提供可扩展的解决方案。

------

## 📖 项目概述

1. 本项目设计并实现了一套集**双设备无线音频同步**与**全屋智能家居联动**于一体的综合系统。系统包含三个核心节点：

   - **音频主节点（Master）**：ESP32-WROVER-E-N16R8，负责蓝牙 A2DP 音频接收、SD 卡本地解码、UDP 单播分发，以及通过 UI 界面发起灯控指令。
   - **音频从节点（Slave）**：目标硬件同为 ESP32-WROVER-E-N16R8（开发阶段用 ESP32-S3 开发板，如 ESP32-S3-N16R8），接收 UDP 单播音频数据，按包头 `t_play_us` 对齐出声时刻、用丢/插单个样点补偿长期漂移，实现无感知同步播放（纯同步收听，不参与蓝牙播放）。
   - **灯控节点（Light Controller）**：**ESP8266**，同时支持**局域网 UDP 组播接收**（来自音频主节点 UI 屏幕控制）和**巴法云 MQTT 接入**（来自米家 App / 小爱同学语音控制），驱动**单路继电器灯**（只有开/关，不支持调光），并**每 30s 向主节点组播回传一次开关状态**。

   ### 核心创新

   1. **高精度音频同步**：主节点把同一份 PCM 数据通过 UDP **逐台单播**发到从节点（每帧带 `t_play_us` 基准播放时刻），从节点按该时刻对齐出声，长期漂移用丢/插单个样点补偿；主从残差只剩两端最小单程延迟之差（局域网 1~3ms）。
   2. 双通道灯控闭环：
      - **本地 UI 控制链路**：ESP32 主节点 UI 界面 → UDP 组播（`239.0.0.2:8889`）→ ESP8266 灯控节点（局域网低延迟，不依赖公网）；ESP8266 每 30s 经该组播通道回传一次开关状态，主节点侧解析后刷新灯控图标
      - **云端语音控制链路（已下线）**：原设计为 ESP32 主节点通过 HFP 唤醒手机语音助手 → 米家云 → 巴法云 MQTT → ESP8266 灯控节点；HFP 语音链路已整链路移除（`CallPhone` 与 `microphone` 在 `Play_Master/legacy_disabled`），主节点不再建立通话连接，现仅剩 ESP8266 侧的巴法云 MQTT 接入
   3. **WiFi 多路复用**：ESP32-WROVER-E-N16R8 的 WiFi 协议栈（lwIP）同时承载高实时性的 UDP 音频单播（发往各从节点 `:5680`）、UDP 控制组播（`239.0.0.1:5679`）、UDP 灯控组播（`239.0.0.2:8889`），与 ESP8266 灯控节点深度联动。

### 核心功能一览

| 功能模块 | 说明 |
| --- | --- |
| 蓝牙音频接收（A2DP Sink） | 主节点接收手机/平板蓝牙音频流 |
| 双设备音频同步（WiFi 单播） | 主节点通过 UDP 逐台单播分发 PCM 数据（每包带 `t_play_us`），主从残差 1~3ms |
| **UI 屏幕灯控（UDP 组播）** | **主节点 UI 界面通过 UDP 组播控制 ESP8266 灯光，局域网低延迟；ESP8266 每 30s 回传一次开关状态** |
| **米家智能家居接入** | **ESP8266 通过巴法云 MQTT 接入米家生态，支持小爱同学语音控制** |
| 本地音乐播放（SD 卡） | 仅主节点可独立播放 SD 卡 `/sdcard/music` 下的 MP3 文件（不支持 WAV；从节点无 SD 卡）|
| 播放控制（AVRCP） | 全局控制（播放/暂停/切歌/音量），同步至从节点 |
| LVGL 触摸屏界面 | 只有主音频节点配备 2.8 寸触摸屏，显示播放状态及**灯控入口**  |
| 双备份 OTA 升级 | 主节点支持 WiFi 远程升级，具备失败自动回滚能力（从节点 OTA 未接线）|
| 节点角色配置 | 主/从节点目标硬件同为 ESP32-WROVER-E-N16R8（开发阶段从节点用 ESP32-S3），固件分开编译，NVS 存储各自参数|

### 系统架构图

```reStructuredText
┌───────────────────────────────────────────────────────────────┐
│                        手机（音频源）                         │
│                   (蓝牙 A2DP Sink / AVRCP)                    │
└───────────────────────────────┬───────────────────────────────┘
                                │
                                │ 蓝牙音频流
                                ▼
┌───────────────────────────────┬───────────────────────────────┐
│                   主节点 (Master) - 房间 A                    │
│ ┌───────────────────────────────────────────────────────────┐ │
│ │                    ESP32-WROVER-E-N16R8                    │ │
│ │ • 蓝牙 A2DP 接收 / SD 卡 MP3 解码 / I2S 功放本地播放      │ │
│ │ • UDP 逐台单播 (PCM + t_play_us)                          │ │
│ │ • 控制组播 239.0.0.1:5679（控制命令 / 从机发现）          │ │
│ │ • 本机出声 = t_play_us + 60ms（与从节点同一公式）         │ │
│ │ • 触摸屏 UI (LVGL)：播放 / 灯控 / 设置                    │ │
│ │                                                           │ │
│ └───────────────────────────────────────────────────────────┘ │
└─────────────┬──────────────────────────────────┬──────────────┘
       链路①：音频同步                    链路②：UI 灯控
          UDP 单播                           UDP 组播
       从节点 IP:5680                     239.0.0.2:8889
              ▼                                  ▼
┌────────────────────────────┐     ┌────────────────────────────┐
│  从节点 1~N（上限 8 台）   │     │      ESP8266 灯控节点      │
│ • 单播接收 :5680           │     │ • 组播 239.0.0.2:8889      │
│ • Jitter Buffer 抗乱序     │     │ • on / off → 单路继电器    │
│ • 按 t_play_us 对齐出声    │     │ • 回 ack，每 30s status    │
│ • 丢/插单样点补偿漂移      │     │                            │
│ • I2S 功放播放             │     │                            │
└────────────────────────────┘     └─────────────┬──────────────┘
                                                 │
                                                 ▼
                                     ┌───────────────────────┐
                                     │  卧室灯（只开 / 关）  │
                                     └───────────────────────┘
```

------

## 🧩 硬件要求

### 核心组件

| 组件 | 型号 | 说明 |
| :--- | :--- | :--- |
| **主控（主节点）** | ESP32-WROVER-E-N16R8 | ESP32-D0WD 芯片，双核 240MHz，16MB Flash + 8MB PSRAM，支持蓝牙 v4.2 双模（BR/EDR + BLE），集成 802.11 b/g/n Wi-Fi |
| **主控（从节点）** | ESP32-WROVER-E-N16R8（开发阶段暂用 ESP32-S3 开发板，如 ESP32-S3-N16R8） | 目标方案与主节点同款；开发验证用的 ESP32-S3 为双核 240MHz、16MB Flash + 8MB PSRAM，支持 BLE 与 Wi-Fi，**无经典蓝牙（BR/EDR），不支持 A2DP 蓝牙音乐接收** |
| **显示屏** | 2.8 寸 IPS SPI 模块（ILI9341） | 320×240 分辨率，4 线 SPI，自带 Micro SD 卡槽 。只有音频主节点有 |
| **触摸屏** | 电容触摸（FT6336G） | I²C 接口 |
| **音频功放** | NS4168 | I2S 数字输入，单声道 D 类，2.5W 输出，内置 DAC |
| **麦克风** | INMP441（已下线） | 语音唤醒整链路（esp-sr / CallPhone / microphone）已移入 `Play_Master/legacy_disabled`，不再参与构建 |
| **存储卡** | Micro SD 卡（SPI 模式） | FAT32 格式，存放音频文件（/music）；UI 图片放 Flash storage 分区随固件烧录 |
| **扬声器** | 4Ω 3W 喇叭 | 单声道输出 |
| **电源** | 设计的板子有电源，用电池供电，可充电 | 为整板供电 |

> **⚠️ 重要提示**：
>
> - 目标硬件主/从同为 ESP32-WROVER-E-N16R8（开发阶段从节点用 ESP32-S3 开发板验证），固件分开编译，通过 NVS 保存各节点运行参数。
> - 从节点**无需焊接麦克风**，仅使用 ESP32-S3 开发板 + I2S 功放（无触摸屏 / SD 卡 / 经典蓝牙），进一步降低 BOM 成本。
> - 从节点**不实现“无主节点时切换蓝牙模式”**：ESP32-S3 仅支持 BLE（无经典蓝牙 A2DP），无法作为蓝牙音源接收端。
> - UI 图片资源（3 张 PNG）随固件烧录进 Flash `storage` 分区，字体/图标编译进固件；音乐文件从 SD 卡加载，Flash 双备份 OTA 布局不变。
> - 两个节点需连接**同一 WiFi 路由器**（同一局域网），以支持 UDP 单播 / 组播通信。

## 🏗️ 软件架构

### 音频节点（从节点目标同为 ESP32-WROVER-E-N16R8，开发阶段用 ESP32-S3 开发板 + I2S 功放，无触摸屏 / SD 卡 / 麦克风 / 经典蓝牙）

```reStructuredText
project/
├── main/                          # 主程序入口
│   ├── app_main.c
│   ├── idf_component.yml          # 外部组件依赖
│   └── CMakeLists.txt
├── components/
│   ├── bsp/                       # 板级支持包
│   │   ├── i2c_driver/            # I²C 驱动（触摸屏）
│   │   ├── i2s_driver/            # I²S 物理总线（句柄化 TX/RX，参数化引脚）
│   │   └── spi_driver/            # SPI 驱动（LCD + SD 卡）
│   ├── middlewares/               # 中间件
│   │   ├── LCD_Touch/             # ILI9341 + FT6336G 驱动
│   │   ├── microphone/            # INMP441 驱动（已移入 legacy_disabled）
│   │   ├── amplifier/             # NS4168 驱动（I2S TX 直驱 + 内部写锁）
│   │   ├── sd_card/               # SD 卡 SPI + FATFS 挂载（句柄式文件 API）
│   │   ├── audio_decoder/         # MP3 解码（minimp3，不支持 WAV）
│   │   └── sync_protocol/         # 同步协议（单播发送 t_play + 控制组播）
│   ├── App/                       # 应用层
│   │   ├── MusicPlay/             # 音频播放引擎 + 播放源选择（主节点：蓝牙/本地；从节点：仅单播）
│   │   ├── CallPhone/             # HFP 通话（已移入 legacy_disabled，无调用者）
│   │   ├── UI/                    # LVGL 界面（图片在 Flash storage 分区，字体编译进固件）
│   │   └── LightControl/          # 联动灯控节点模块
│   └── mysystem/                    # 系统服务
│       ├── ota_manager/           # OTA 升级核心逻辑
│       ├── wifi_manager/          # WiFi 配网与连接管理
│       └── node_role/             # 节点角色管理（Master/Slave NVS 配置）
└── datasheet/                     # 参考资料
```

### 音频输出/输入职责说明

系统物理上只有一个功放（麦克风与语音唤醒已下线），多路音源（蓝牙 A2DP、
本地 SD 播放、单播同步播放等）共用它。串行化与缓冲直接
落在外设模块内部，不再有独立的 `audio_bus` 仲裁层：

| 方向 | 模块 | 行为 | 说明 |
| --- | --- | --- | --- |
| TX（功放） | `amplifier` | 内部写锁 + 按块原子写 | 同一时刻只允许一路音源写入 I2S，多任务串行化 |
| RX（麦克风） | `microphone`  | 已下线  | 模块已移入 `legacy_disabled`，不参与构建 |

- `amplifier` 直接持有 `i2s_driver` TX 句柄，`Amplifier_Play_Buffer()` 为原子写；
- 主节点同时启用 TX + 从节点仅有 TX（功放）。

### 音频节点-外部组件依赖（idf_component.yml）

```yaml
dependencies:
  lvgl/lvgl: "^9"                   # LVGL 9 图形库
  espressif/cjson: "^1.7.19"        # 灯控 JSON 解析
  espressif/freetype: "^2.14.3"     # FreeType：LVGL 运行时 TTF 渲染后端（需同时开 CONFIG_LV_USE_FREETYPE）
  # espressif/esp-sr: "^2.0.0"      # 已移除（2026-10-25）：语音唤醒链路下线
  # 蓝牙 A2DP、SD/FATFS、MP3 解码均走 ESP-IDF 内置组件，不在本文件声明
```

### 灯控节点（ESP8266）

```reStructuredText
esp8266_light_controller/
 ├── main/
 │   ├── app_main.c                 # 主程序入口
 │   └── CMakeLists.txt
 ├── components/
 │   ├── bsp/
 │   │   ├── gpio_driver/           # esp-idf的gpio封装
 │   │   └── wifi_manager/          # WiFi 连接/重连管理
 │   ├── middlewares/
 │   │   ├── LED_Control/           # 灯的控制
 │   │   └── mqtt_client/           # 巴法云 MQTT 客户端
 │   └── App/
 │       ├── UDP_Multicast_Receiver/ # UDP 组播接收（来自 ESP32 UI）
 │       └── BemFa_MQTT/            # 巴法云 MQTT（米家 App / 小爱接入）
```

------

## 💾 音频主节点-分区表（双备份 OTA，16MB Flash）

> **注**：分区表按主节点实际 `partitions.csv` 列出；从节点目标同为 ESP32-WROVER-E-N16R8（开发阶段为 ESP32-S3-N16R8，16MB Flash），其分区表也有 ota_0/ota_1 槽位，但 `ota_manager` 目前是空壳，OTA 尚未接线。

UI 图片资源（3 张 PNG）存放在 SPIFFS `storage` 分区（随固件烧录，见 `storage/ui_img/`），字体编译进固件；Flash 其余空间用于双备份 OTA。

```csv
# Name,      Type, SubType,   Offset,    Size,      Flags
nvs,         data, nvs,       0x9000,    24K,
phy_init,    data, phy,       0xf000,    4K,
otadata,     data, ota,       0x10000,   8K,
ota_0,       app,  ota_0,     0x20000,   0x400000,  # 4MB
ota_1,       app,  ota_1,     0x420000,  0x400000,  # 4MB
model,       data, spiffs,    0x820000,  0x80000,   # 512KB
storage,     data, spiffs,    0x8A0000,  0x740000,  # 7.25MB（UI 图片，随固件烧录）
coredump,    data, coredump,  0xFE0000,  0x20000,   # 128KB
```

### 空间占用分析

| 分区 | 起始地址 | 结束地址 | 大小 | 说明 |
| :--- | :--- | :--- | :--- | :--- |
| Bootloader + 表头 | 0x0000 | 0x9000 | 36KB | 系统保留 |
| NVS | 0x9000 | 0xF000 | 24KB | 存储蓝牙配对信息、WiFi 凭据、节点角色等 |
| PHY Init | 0xF000 | 0x10000 | 4KB | 射频校准数据 |
| **otadata** | **0x10000**  | **0x12000**  | **8KB** | **OTA 启动选择标志** |
| **ota_0（固件区 A）** | **0x20000**  | **0x420000** | **4MB** | 当前运行固件 / 升级目标区 1 |
| **ota_1（固件区 B）** | **0x420000** | **0x820000** | **4MB** | 当前运行固件 / 升级目标区 2 |
| **model** | **0x820000** | **0x8A0000** | **512KB**  | SPIFFS；模型资源预留 |
| **storage（UI 图片）** | **0x8A0000** | **0xFE0000** | **7.25MB** | SPIFFS；存放 UI 图片（ui_img/ 3 张 PNG），随固件烧录 |
| **coredump** | **0xFE0000** | **0x1000000** | **128KB** | 崩溃现场转储 |

### 📊 空间使用总览

```reStructuredText
Flash 分区布局 (0x000000 - 0x1000000)
├── 0x000000 - 0x009000  : Bootloader + 分区表 (36KB)
├── 0x009000 - 0x00F000  : NVS (24KB)
├── 0x00F000 - 0x010000  : PHY Init (4KB)
├── 0x010000 - 0x012000  : otadata (8KB)
├── 0x020000 - 0x420000  : ota_0 (4MB) ← 当前运行/升级目标
├── 0x420000 - 0x820000  : ota_1 (4MB) ← 当前运行/升级目标
├── 0x820000 - 0x8A0000  : model (512KB) ← 模型资源预留
├── 0x8A0000 - 0xFE0000  : storage (7.25MB) ← UI 图片（SPIFFS，随固件烧录）
└── 0xFE0000 - 0x1000000 : coredump (128KB)
```

------

## 🔁 FreeRTOS 任务设计-开发过程可能会更改（栈大小最可能更改）

### 音频-主节点任务

| 任务名 | 优先级 | 栈大小  | 核 | 功能 |
| :--- | :----- | :--- | :----- | :--- |
| **UI_Task** | 10 | 32768 | Core 0 | LVGL 渲染与触摸/页面交互；图片从 Flash `/storage` 按需加载 |
| **SyncLocalPlay_Task** | 12 | 4096 | Core 1 | 本地延迟队列取 PCM，按 `t_play_us + 60ms` 写 I2S（喂 I2S 的消费端，优先级最高） |
| **SyncTx_Task** | 11 | 4096 | Core 0 | 打 `t_play_us`、逐台单播发送 |
| **bt_audio_task** | 11 | 4096 | Core 1 | 蓝牙事件 FIFO 出队，触发 `on_event`/`on_pcm` |
| **audio_decoder 解码任务** | 10 | 4096 | Core 1 | SD 卡 MP3 流式解码（minimp3）→ `on_pcm` → `push_pcm` |
| **MusicPlay_Task** | 9 | 4096 | Core 1 | SD 选曲/播放控制/状态机 + 自动源选择（原 PlayMode，轮询 A2DP） |
| **wifi_mcast_rx** | 6 | 6144 | Core 0 | 组播收包 → 通道 FIFO（rx 启用的通道，如灯控通道 ack/status） |
| **SmartHome_Task** | 5 | 4096 | Core 0 | 处理 UI 灯控指令 UDP 组播发送；解析 ack / 30s status 上报并触发事件  |
| **ota_update / ota_sync**  | 5 | 12288 | Core 0 | 动态创建，执行固件下载与升级，完成后自销毁 |
| **Touch_Task** | 3 | 2048 | Core 0 | 触摸 IC（FT6336G）扫描，由模块内部创建 |
| **app_hb** | 2 | 3072 | Core 0 | 卡死定位心跳，不参与启动时序 |

### 音频-从节点任务

| 任务名 | 优先级 | 栈大小 | 功能 |
| :--- | :----- | :----- | :--- |
| **udp_audio_rx** | 11 | 4096 | UDP 单播收包 → 解析 20 字节包头 → 按 seq 写入 Jitter Buffer |
| **udp_audio_play** | 10 | 5120 | 从 Jitter Buffer 取 PCM，按 `t_play_us + offset + 60ms` 出声，丢/插单样点补偿漂移 |
| **ctl_rx** | 5 | 3072 | 控制通道收包（当前只处理 VOLUME），并每 3s 组播 ANNOUNCE |
| **wifi_mcast_rx** | 6 | 4096 | 组播收包写入通道 FIFO（`rx_enable` 的通道各创建） |

> **说明**：从节点已移除 `AudioSource_Task`、`SyncSender_Task`、`CallUp_Task` 等主节点专属任务，当前只跑「单播接收 → 抖动缓冲 → 按 `t_play_us` 出声」这一条链路，外加控制通道与 WiFi 管理；从节点 OTA 尚未接线（`ota_manager` 为空壳）。
> **任务间通信**：事件组（Event Group）用于状态切换通知，消息队列（Queue）传输 PCM 数据块。

### 灯控节点任务（ESP8266）

| 任务名 | 优先级 | 栈大小 | 功能 |
| --- | --- | --- | --- |
| **UDP_Multicast_Rx_Task** | **10** | **4096** | UDP 组播接收，监听 239.0.0.2:8889，处理来自 ESP32 UI 的灯控指令，并每 30s 组播回传开关状态 |
| BemFa_MQTT_Task | 8 | 8192 | 连接巴法云 MQTT，订阅灯控主题，定时上报状态 |
| LED_Control_Task | 6 | 4096 | 解析指令，驱动**单路继电器**（只有开 / 关，无调光） |
| WiFi_Manager_Task | 4 | 4096 | WiFi 连接与断线重连 |

------

## 🌐 双设备同步协议设计

### 音频数据包格式（自定义轻量级 RTP）

主节点把同一份 PCM **逐台单播**到各从节点的 UDP `5680`（不组播），每个音频包携带约 **15ms** 的 PCM 数据（661 个样点），包头 20 字节：

```reStructuredText
┌───────┬─────────┬───────┬───────────┬─────┬───────────┬─────────────┬─────────┐
│ magic │ version │ flags │ stream_id │ seq │ t_play_us │ payload_len │ lead_ms │
│  2B   │   1B    │  1B   │    2B     │ 2B  │    8B     │     2B      │   2B    │
├───────┼─────────┼───────┼───────────┼─────┼───────────┼─────────────┼─────────┤
│      PCM payload（16bit / 44.1kHz / 单声道，默认 661 样点 = 1322 字节）       │
└───────────────────────────────────────────────────────────────────────────────┘
```

| 字段 | 大小 | 说明 |
| :--- | :----- | :--- |
| Magic | 2 字节 | 包起始标志 `0xAA55`，用于同步和过滤干扰 |
| Version | 1 字节 | 协议版本，当前 `2`；接收端丢弃版本不符的包 |
| Flags | 1 字节 | `bit0 = 1` 表示本次流的首帧 |
| Stream ID  | 2 字节 | 一次音频流的唯一标识（主节点重启 / 切歌时变化） |
| Seq | 2 字节 | 序列号，递增（0~65535 循环），从节点用于检测丢包 |
| t_play_us  | 8 字节 | 该帧的基准播放时刻（主节点 `esp_timer` 微秒），不是发送时刻 |
| Payload Len| 2 字节 | 实际 PCM 数据长度（字节） |
| Lead ms | 2 字节 | 提前量 D（ms），默认 200，从节点换算时钟偏移要用 |
| Audio Data | 变长 | PCM 数据（16bit, 44.1kHz, 单声道），约 15ms 时长 |

> **包大小计算**：15ms × 44.1kHz × 2 字节 ≈ 1323 字节（默认 661 样点取整），加上 20 字节头部，共约 1343 字节，UDP 包远小于 MTU 1500 字节，避免 IP 分片。
>
> **时刻定义**：`t_play_us = 发送时刻 + D`；主节点本地出声时刻 = `t_play_us + 60ms`（`SYNC_RX_MARGIN_US`），与从节点用同一公式，故主从同拍。

### 控制命令包（端口 5679）

控制命令使用独立端口（5679），同样通过组播发送，格式如下：

```reStructuredText
+----------------+----------------+----------------+
|  Magic (0xAA55) |  Cmd (8bit)    |  Param (8bit)  |
+----------------+----------------+----------------+
```

| 命令码 | 含义 | Param |
| :----- | :--- | :--- |
| 0x01 | PLAY | 0 |
| 0x02 | PAUSE | 0 |
| 0x03 | NEXT | 0 |
| 0x04 | PREV | 0 |
| 0x05 | VOLUME | 0~100 |
| 0x06 | RESET | 0（复位） |

> **扩展帧**（同一控制通道 `239.0.0.1:5679`，靠 type 与 cmd 区分）：`magic + type + len + data`，type 取值 `0x12` SYNC_START、`0x13` SYNC_HEARTBEAT、`0x20` PING、`0x21` PONG、`0x30` ANNOUNCE。PING/PONG 帧格式仍保留，但已不参与音频同步。
>
> **从节点当前只处理 VOLUME 帧**（音量跟随主节点），其余命令与扩展帧一律忽略。从节点每 3s 组播一帧 ANNOUNCE（ver、mac、ip、audio_port、volume、rssi、flags、token、name），主节点按 MAC upsert 维护从机表，10s 收不到判离线，上限 8 台（`SYNC_MAX_SLAVES`）；收到第一份合法公告后，发现表成为单播目标的唯一权威，此前沿用静态 IP 表。

------

## 🕒 同步机制详解（核心算法）

### 第一阶段：启动同步（初始对齐）

从节点**不立即出声**，而是先收一段数据单向估计时钟偏移（全程不需要回包）：

1. 从节点在 `5680` 上接收单播音频，按 `seq` 存入抖动缓冲区（Jitter Buffer）。
2. 每收到一帧记 `d(i) = 本地收到该帧的时刻 − 该帧的 t_play_us`。
3. 取统计窗口内 `d(i)` 的最小值 `d_min`（最小单程延迟最有代表性）。
4. 换算时钟偏移：`offset = d_min + lead_ms × 1000 + 60ms`。
5. 之后**出声时刻 = t_play_us + offset**；主节点本地按 `t_play_us + 60ms` 出声，与从节点同一常数，因此主从同拍。

**关键代码示意**：

```c
// 从节点：最小单程延迟 → 时钟偏移 → 本地出声时刻
int64_t d = (int64_t)t_recv_us - (int64_t)pkt->t_play_us;
if (d < s_d_min) {
    s_d_min = d;                                  // 统计窗口内取最小
}

int64_t offset        = s_d_min + (int64_t)pkt->lead_ms * 1000 + UDIO_MARGIN_US;
int64_t t_play_local  = (int64_t)pkt->t_play_us + offset;
```

### 第二阶段：持续同步校正（防时钟漂移）

两个设备使用不同晶振，长期播放会产生时钟漂移（如 50ppm 误差，1 分钟漂移 3ms，10 分钟漂移 30ms）。

偏移量在开播时冻结，让误差自然累积，再用 **sample slip** 拉回：落后就丢一个样点、领先就插一个样点，**不改 I2S 采样率**。

**校正策略**：

1. 播放任务按 `t_play_us + offset` 对齐每一帧的出声时刻。
2. 实际出声时刻与目标偏差超出死区时，丢/插**单个样点**（拼接处做几个样点的平滑），把时间轴拉回一格。
3. 单次只补一个样点（≈22.7µs），避免产生可听噪声。

```c
// 从节点：丢/插一个样点，I2S 采样率保持不变
size_t n_out = ua_write_frame(pcm, n, slip, dst);   // slip > 0 丢一个、< 0 插一个、0 原样
Amplifier_Play_Buffer((const uint8_t *)dst, n_out * sizeof(int16_t), NULL, amp_timeout);
```

### 第三阶段：异常处理

| 异常场景 | 处理策略 |
| :--- | :--- |
| **丢包**（Seq 不连续） | 静音填充（写入 0 值），避免 I2S 欠载产生爆音 |
| **网络中断 > 500ms** | 自动进入静音模式，UI 显示“同步断开”，随 WiFi 重连重建单播接收 |
| **主节点重启/切换** | 检测到 `stream_id` 变化，重新估计 `d_min` 与 offset |

## 📡 WiFi 网络与跨设备联动配置

| 项目 | 配置 |
| --- | --- |
| WiFi 模式 | 所有节点（音频主/从、ESP8266）均连接 **同一路由器**（Station 模式） |
| **音频单播** | **UDP 从节点 :5680**，PCM 数据 + `t_play_us`，主节点逐台单播（不走组播） |
| **控制组播** | **UDP 239.0.0.1:5679**，控制命令 / SYNC_START / HEARTBEAT / ANNOUNCE，依赖 `CONFIG_LWIP_IGMP` |
| **灯控组播（UI 控制）** | **UDP 239.0.0.2:8889**，JSON 格式灯控指令，来自 ESP32 UI 屏幕 |
| **MQTT 通信（语音控制）** | **巴法云 MQTT (bemfa.com:9501)**，ESP8266 订阅灯控主题 |
| **路由器要求** | **建议开启 IGMP Snooping（组播侦听）**，保证控制组播与灯控组播的精准投递，防止泛洪干扰手机/电脑等其他设备；音频走单播，不依赖该功能。 |

> **备选方案（无路由器）**：可使用 **ESP-NOW** 或 **WiFi P2P（SoftAP + Station）** 直连，但推荐路由器方案，调试最简单，且可扩展至更多设备。

### ESP32 与 ESP8266 通信协议（UDP 组播）

**数据格式（JSON）**：

```json
{
  "cmd": "on",
  "light": "bedroom",
  "version": 1
}
```

| 字段  | 说明 |
| ----- | --- |
| cmd | 指令：`on` / `off` |
| light | 目标灯：当前只有 `bedroom`（一盏灯） |
| version | 协议版本，当前 `1`；对端高于本端版本时回 `verr` |

**ESP32 端代码示意（UI 点击灯控按钮）**：

```c
// ESP32 主节点：UI 界面点击开灯按钮后，通过 UDP 组播发送指令
void ui_bedroom_light_on_click(void) {
    const char* cmd_json = "{\"cmd\":\"on\",\"light\":\"bedroom\",\"version\":1}";
    
    int sock = socket(AF_INET, SOCK_DGRAM, 0);
    struct sockaddr_in multicast_addr = {
        .sin_family = AF_INET,
        .sin_port = htons(8889),
        .sin_addr.s_addr = inet_addr("239.0.0.2")  // 灯控组播地址
    };
    
    sendto(sock, cmd_json, strlen(cmd_json), 0, 
           (struct sockaddr*)&multicast_addr, sizeof(multicast_addr));
    close(sock);
}
```

**ESP8266 端代码示意（UDP 组播接收）**：

```c
// ESP8266 灯控节点：加入灯控组播组并接收指令
void udp_multicast_receiver_task(void *pvParameters) {
    int sock = socket(AF_INET, SOCK_DGRAM, 0);
    struct sockaddr_in server_addr = {
        .sin_family = AF_INET,
        .sin_port = htons(8889),
        .sin_addr.s_addr = INADDR_ANY
    };
    bind(sock, (struct sockaddr*)&server_addr, sizeof(server_addr));
    
    // 加入灯控组播组（触发 IGMP Join）
    struct ip_mreq imreq;
    imreq.imr_multiaddr.s_addr = inet_addr("239.0.0.2");
    imreq.imr_interface.s_addr = IPADDR_ANY;
    setsockopt(sock, IPPROTO_IP, IP_ADD_MEMBERSHIP, &imreq, sizeof(struct ip_mreq));
    
    char buf[256];
    while(1) {
        int len = recv(sock, buf, sizeof(buf), 0);
        if (len > 0) {
            buf[len] = '\0';
            // 解析 JSON 并控制 LED
            parse_and_control_led(buf);
        }
    }
}
```

## 🔄 OTA 升级流程

### 音频节点（ESP32）

主节点采用双备份 OTA 分区（ota_0 / ota_1 各 4MB），支持远程升级、UI 触发与失败自动回滚。从节点分区表虽有 ota 槽位，但 `ota_manager` 目前是空壳，OTA 尚未接线。

### 灯控节点（ESP8266）

ESP8266 采用单分区 OTA（4MB Flash），通过 HTTP 下载新固件并写入备用区域，重启后自动切换。

## ✨ 功能详细说明

### 1. 蓝牙音频接收（仅主节点）

- 主节点作为 A2DP Sink 连接手机，接收 SBC 音频流。
- 将 PCM 数据同时送入本机播放队列和单播发送队列。

### 2. 双设备同步播放（核心创新）

- **单播分发**：主节点把同一份 PCM 逐台单播到从节点（UDP `:5680`），每帧带 `t_play_us`。
- **从节点接收**：从节点按 `t_play_us + offset` 对齐出声，offset 由最小单程延迟单向估计。
- **同步残差**：两端最小单程延迟之差（局域网 1~3ms），人耳听不出先后。
- **容错处理**：从节点若超过 500ms 未收到音频包，自动静音并随 WiFi 重连恢复接收。

### 3. 本地音乐播放（SD 卡）

- 仅主节点可播放 SD 卡 `/sdcard/music` 目录下的 MP3 文件（minimp3 解码，不支持 WAV；从节点无 SD 卡）。
- 从节点仅作为同步播放终端，不提供独立的本地 / 蓝牙播放源。

### 4. LVGL 图形界面（图片在 Flash storage 分区，字体编译进固件）

- 主节点 UI 显示当前播放源（蓝牙/本地）、歌曲信息、进度条、控制按钮。
- 从节点无触摸屏 / UI；主节点的设置页第 2 页显示「已连接 N/M」从机列表（绿/灰状态点、IP、RSSI、失联秒数）。
- 目标硬件主/从同款，开发阶段从节点用 ESP32-S3，固件分开编译，角色由刷写固件决定。

### 5. AVRCP 控制（双向同步）

- 手机端控制（播放/暂停/切歌）通过 AVRCP 同步至主节点，主节点通过组播控制命令同步至从节点。

### 6. UI 屏幕灯控（UDP 组播，本地低延迟）

音频主节点通过 LVGL UI 界面提供灯光控制入口，与 ESP8266 智能灯控节点深度联动：

- **通信机制**：`SmartHome_Task` 在局域网内通过 **UDP 组播（239.0.0.2:8889）** 向 ESP8266 发送 JSON 格式的控制指令（`cmd` 只有 `on` / `off`，`light` 当前只有 `bedroom`，另带 `version`）。
- **执行端**：ESP8266 的 `UDP_Multicast_Rx_Task` 加入灯控组播组，接收指令后调用 `LED_Control_Set_Light()` 驱动**单路继电器**——只有开 / 关，不能调亮度；收到后回 ack，并每 30s 主动上报一次 status。
- 优势：
  - **局域网低延迟**：UI 点击到灯光响应 < 50ms
  - **不依赖公网**：即使家里断网，UI 仍可控制灯光
  - **多节点扩展**：未来增加 ESP8266 灯控节点，只需加入同一组播组即可
- **并发保障**：灯控组播（`239.0.0.2:8889`）与音频单播（从节点 `:5680`）、控制组播（`239.0.0.1:5679`）分别使用不同的地址 / 端口，在 lwIP 协议栈中通过不同的 Socket 独立运行，互不阻塞。

### 7. 云端灯控（巴法云 MQTT，当前不经主节点触发）

原设计由音频主节点通过 HFP 协议唤醒手机语音助手来触发云端灯控；HFP 语音链路（esp-sr 唤醒词、INMP441 麦克风、CallPhone）已整链路下线，主节点不再建立通话连接。现在这条链路只剩 ESP8266 侧的巴法云 MQTT 接入：

- 控制链路：米家 App / 小爱同学 → 米家云 → 巴法云 MQTT → ESP8266 控制灯光
- **执行端**：ESP8266 的 `BemFa_MQTT_Task` 订阅巴法云主题，接收米家下发的灯控指令并执行。
- 优势：
  - **接入米家生态**：支持米家 App 和小爱同学语音控制
  - **云端远程控制**：即使不在家，也可通过手机 App 控制灯光
  - **状态同步**：ESP8266 每 30 秒向巴法云上报当前灯光状态，米家 App 显示与实际一致

### 8. 双通道灯控的统一执行

ESP8266 灯控节点同时处理来自两个通道的指令：

| 控制来源 | 通信方式 | 延迟 | 适用场景 |
| --- | --- | --- | --- |
| **ESP32 UI 屏幕** | UDP 组播（`239.0.0.2:8889`） | < 50ms | 本地快速控制，不依赖公网 |
| **手机语音助手**  | 巴法云 MQTT | 200~500ms | 语音控制、远程控制、米家联动 |

**指令融合**：两个通道的指令最终都调用同一个 `LED_Control_Set_Light()` 函数，状态天然一致，互不冲突。无论通过哪种方式控制，灯光状态都会同步更新，并通过巴法云上报至米家 App。

------

## 🛠️ ESP-IDF 关键配置（menuconfig）

```bash
# WiFi 与组播
CONFIG_LWIP_IPV4=y
CONFIG_LWIP_MULTICAST=y
CONFIG_LWIP_IGMP=y

# OTA
CONFIG_ESP_OTA=y
CONFIG_BOOTLOADER_APP_ROLLBACK_ENABLE=y

# FATFS 长文件名（仅主节点，从节点无 SD 卡）
CONFIG_FATFS_LONG_FILENAMES=y

# 蓝牙（仅主节点固件需要；从节点 ESP32-S3 无经典蓝牙，不启用以下配置）
CONFIG_BT_ENABLED=y
CONFIG_BT_BLUEDROID_ENABLED=y
CONFIG_BT_CLASSIC_ENABLED=y
```

------

## 📊 性能指标

| 指标 | 数值 |
| :--- | :--- |
| 音频同步残差 | 两端最小单程延迟之差（局域网 1~3ms）  |
| 单播网络带宽 | ~0.7 Mbps / 台（PCM 44.1kHz/16bit 单声道），8 台约 5.6 Mbps |
| 启动同步时间 | < 2s |
| WiFi 覆盖范围  | 标准家庭环境（2.4GHz） |
| 最大支持节点数 | 8 台（`SYNC_MAX_SLAVES`） |

------

## 📖 参考资料

- [ESP-IDF 编程指南](https://docs.espressif.com/projects/esp-idf/zh_CN/latest/)
- [ESP32-WROVER-B & WROVER-IB 技术规格书](https://www.espressif.com/sites/default/files/documentation/esp32-wrover-b_esp32-wrover-ib_datasheet_cn.pdf)
- [ESP32-S3 技术规格书](https://www.espressif.com/sites/default/files/documentation/esp32-s3_datasheet_cn.pdf)
- [LVGL 官方文档](https://docs.lvgl.io/)
- [ESP-ADF 音频应用开发框架](https://docs.espressif.com/projects/esp-adf/zh_CN/latest/)
- [RFC 3550 RTP 协议（用于时间戳参考）](https://tools.ietf.org/html/rfc3550)
- [LCDWiki 2.8 寸 IPS SPI 模块](http://www.lcdwiki.com/zh/2.8inch_IPS_SPI_Module_ILI9341)
- [NS4168 数据手册](https://./datasheet/NS4168.pdf)

------
