currygood/MusicPlaySyncSpeakers/.workbuddy/memory/2026-10-29.md

# 2026-10-29

## 崩溃：Core0 Interrupt WDT timeout，PC 在 i2c_master_isr_handler_default

运行 8453s（≈2.35h）后崩，coredump 已写入 0xFE0000。
- `CONFIG_ESP_INT_WDT_TIMEOUT_MS=3000`（已比默认 300ms 放宽 10 倍）仍触发。
- PC = `i2c_master.c:805`，那行是 `portBASE_TYPE HPTaskAwoken = pdFALSE;`（函数序言），
  说明是**反复重入**（中断风暴），不是卡在循环里。`_xt_lowint1 → shared_intr_isr
  → i2c_master_isr_handler_default`。Core0 同时在 ISR 里打过 UART 日志。
- 两个核都停在 IDLE；崩溃前 15 分钟没有 `[REFR]`，`blk/s 0` / `a2dp_cb=0`
  → **与 UI/字体、音频都无关**，是触摸 I2C 的独立故障。

为什么软件救不回来：level-1 ISR 占用 CPU 时任何任务都跑不了；
`LCD_Touch.c` 的退避策略、以及 IDF 里的 `LOCAL PATCH 2026-10-27`
（`esp_intr_disable/enable` 只护住 `s_i2c_hw_fsm_reset` 那个窗口）都碰不到这条路径。
只剩 INT_WDT abort → 重启。

最可能根因：I2C 电气质量。证据：
- `i2c f=3128 ok=33402` → 累计 **8.5% 读失败**，`last=ESP_ERR_INVALID_RESPONSE`
- `bsp/i2c_driver.c` 只开了 `enable_internal_pullup = true`，**没有外部上拉**；
  ESP32 内部上拉约 45kΩ，100kHz 下上升沿远超 1µs 规范 → NACK/总线拉死
- `I2C_FREQ 100000`、`I2C_TRANS_TIMEOUT_MS 150`、`I2C_DRIVER_SILENCE_BUS_ERRORS=1`
  （后者把 `i2c.master` 日志全关了，所以串口上看不到驱动层细节）

候选处置（未实施，待用户决定，属字体任务范围外）：
A 硬件：SDA/SCL 各加 4.7kΩ 上拉（首选，8.5% 失败率对板级 I2C 不正常）
B 软件：`I2C_FREQ` 100k → 50k，一行回退，用来验证"是否电气问题"最便宜
C 软件：触摸改寄存器级单次传输或 bit-bang，绕开 IDF i2c_master 的 ISR 路径（最彻底）

顺带确认：本次 `up=8453s` 期间无栈溢出、无 `spi_master` 报错 → 前两轮修复站住了。

## 选定方案 C：触摸 I2C 改 GPIO 模拟（bit-bang），彻底删掉 i2c_master（2026-10-29 10:30）

改动文件：
- `components/middlewares/LCD_Touch/LCD_Touch.c`
  - 新增「软件 I2C」一节：`ft_i2c_bus_init / ft_i2c_bus_recover / ft_i2c_start /
    ft_i2c_stop / ft_i2c_write_byte / ft_i2c_read_byte / ft_i2c_read_reg / ft_i2c_write_reg`
  - 引脚沿用 `I2C_SDA_GPIO=32 / I2C_SCL_GPIO=33`（宏在 bsp/i2c_driver.h，避免两处漂移）
  - `GPIO_MODE_INPUT_OUTPUT_OD` + `GPIO_PULLUP_ENABLE`，半周期 10µs ≈ **50kHz**
    （原来 100kHz + 仅内部 45k 上拉，上升沿不合规，这是 8.5% NACK 的根源）
  - 总线恢复（9 个 SCL + STOP）现在安全了，**连续失败每 20 次**执行一次
  - 删除 `Ft6336I2cHandle`，改用 `s_ftI2cReady`
  - `LCD_TOUCH_FT6336G_Init(void)` / `LCD_TOUCH_Init(void)`（签名去掉了总线句柄）
- `components/middlewares/LCD_Touch/LCD_Touch.h`：`LCD_TOUCH_Init(void)`
- `components/App/UI/ui_disp.c`：删掉 `I2c_Init_Bus(...)` 与 `s_i2cBus`，
  `LCD_TOUCH_Init()` 直接调用；文件头注释同步更新

结果：全工程**没有任何 `I2c_Init_Bus` / `I2c_Add_Device` 调用**，
i2c_master 的中断永远不会被注册 → 那条会自锁的中断路径彻底不存在。
`bsp/i2c_driver` 保留（以后别的 I2C 设备还能用），IDF 里那个
`[LOCAL PATCH 2026-10-27]`（给 s_i2c_hw_fsm_reset 套 esp_intr_disable）也随之失效，
但可以留着不碍事。

代价（已核算）：一次 6 字节读 ≈ 9 字节 × 9 bit × 20µs ≈ **1.6ms 忙等**；
`Touch_Task` prio=3 / core0 / 栈 2048，随时可被抢占；40ms 轮询下约 3% CPU。

文档：新增 `docs/03-开发/触摸I2C改为GPIO模拟.md`（崩溃解读、为什么软件救不回、
方案对比、时序实现、代价表、验证判据、回退方法）。

验证判据：心跳里 `i2c f=` 的增速应显著低于改造前（2.35h 累计 3128 次失败）；
连续跑 >3 小时不再出现 `Interrupt wdt timeout on CPU0`。

## 方案 C 上板验证通过；开机 task_wdt 判定为噪声（2026-10-29 11:00）

实测：
```
UIFONT: preload 2122276 B in 3674 ms (578 KB/s)      ← 之前 5625ms/377KB/s
UIFONT: 12px line_height=14  16px=19  20px=24        ← 与 hhea 推导逐像素一致
UIFONT: init ok in 6636 ms | internal free=43511 largest=23552 | psram free=1602908
[heap] after ui_init: int free=26111 largest=23552   ← 32KB 栈的代价（原 54607）
E task_wdt: IDLE0 ... CPU 0: wifi  (ppTask, ieee80211_output_process)
```
用户反馈：**触摸正常、比之前更流畅** → 软件 I2C（50kHz，半周期 10µs）时序可用。

task_wdt 定性（重要，别再当故障查）：
- `CONFIG_ESP_TASK_WDT_PANIC` **未开** → 只打印回溯，**不重启、不丢功能**。
- 触发瞬间 CPU0 跑的是 `wifi/ppTask`（prio 23），回溯全是 `ieee80211_output_process`
  → 不是 UI_Task 在跑，是**关联期 WiFi TX burst 把 IDLE0 排到队尾**，
  叠加本任务开机 9s 的工作量（字体 6.6s + 建页 2.5s）。
- `CONFIG_FREERTOS_HZ=1000` → vTaskDelay(1) 只有 1ms，WiFi burst 常未结束，
  IDLE0 仍轮不到，所以旧的 1ms 让出等于没让。

本轮微调（只为压这条告警，不改任何逻辑）：
- `ui_font.c`：FONT_PRELOAD_YIELD_MS=2（原 1），预载 +65ms；
  `ui_font_init` 在 validate 之后（meta 读实测 ~1.1s）插一次 2ms 让出。
- `ui.c ui_pages_create`：四页之间各 vTaskDelay(2)，共 +8ms。
代价合计约 +75ms 开机；若告警仍在，属 WiFi 侧，处理选项只有
①接受（本来就不 panic）②`CONFIG_ESP_TASK_WDT_TIMEOUT_S` 5→15。

SPIFFS 提速已到顶：`SPIFFS_PAGE_SIZE` Kconfig range 是 **256..1024**，当前已是 1024，
没有 4096 这一档，578KB/s 就是这个设计的上限（瓶颈是每 1KB 一次
`esp_partition_read` 的 cache 关/开）。

## Phase 6 收尾 + 任务完成（2026-10-29 11:10）

最终实测（2.12MB Noto、16 行窗口、-Os）：
```
[REFR] page 0 total 363672 us | flush 101009 us / 15 win | draw 252307 us / 14 win (avg 18021, max 41965)
```
对比 8 行 + -Og 的 599710 us（flush 135071/30, draw 464639）→ **599→364ms，降 39%**。
线性模型（两组数据解出）：`draw ≈ 14.7ms × 窗口数 + 0.41µs × 像素数`，
即 252ms 里约 220ms 是**每窗口固定开销**，纯像素只占 31ms。
再降到 10 段（24 行）预计 ~280ms，但要 15KB 内部 RAM（现余 26KB，临界）→ 暂不做。

音频隔离测试：不碰屏播放 3 分钟 **无滋滋/啵啵** → 之前的杂音确认由切页 500ms 阻塞引起。
`i2c f=0 ok=0`：i2c_driver 计数器不再被触碰（触摸已完全脱离 i2c_master）。

确认 -Os 真生效：lvgl `lv_obj_style.c` 编译命令 `-Og ... -Os`（后者覆盖），
freetype 50 个文件同样 `-Os`。app bin **2,588,192 B = 61.7% of 4MB 槽**。

收尾改动：
1. 根 `CMakeLists.txt`：诊断开关 `UI_STACK_USAGE`(默认 ON) → **`UI_DIAG_STACK_USAGE`(默认 OFF)**。
   换名是因为旧键已被 CMakeCache 缓存成 ON，改默认值不生效（这个坑已经踩过两次）。
   代价：下次构建因编译命令变化会**全量重编**一次。
2. `main/app_main.c` 心跳加 `int=空闲/最大连续块`（内部 DRAM）。用户看到
   `heap=1529708` 以为内存很宽裕，其实那是 `esp_get_free_heap_size()`，
   在 `SPIRAM_USE_MALLOC + ALWAYSINTERNAL=0` 下把 PSRAM 算进去了；内部其实只有 26~43KB。
3. 新增 `docs/03-开发/FreeType字体接入-行高适配与内存实测报告.md`（8 节：结论表、
   加载链路、行高口径纠正、实测数据、10 条坑、遗留项、验收清单、相关文档）。

字体任务到此完成。开机那条 `task_wdt: IDLE0` 仍可能出现（不 panic、不影响功能），
原因是 WiFi 关联期 ppTask(prio23) 的 TX burst 把 IDLE0 排在队尾，叠加开机 9s 负载。

## 文档整理：改写 I2C 崩溃笔记 + 新增 FreeType 实现笔记（2026-10-29 11:15）

用户要求把"CPU halt"那条笔记改写、并把 FreeType 整条实现链路（含 Python 处理）记成 note。

1. **改写** `note/触摸I2C间歇NACK-InterruptWDT自锁-软件侧降暴露.md`（原文 7 节、两处结论已被
   后续崩溃推翻）。新结构：状态置顶（已解决）→ 7 次崩溃时间线表（含第 7 次 8453s、
   PC 停在 ISR 函数序言=反复重入）→ 为什么 i2c_master 走不通（两条自锁路径 + 五条补救的边界）
   → 电气侧判断 → 最终 GPIO 模拟 I2C 设计 → 实测对比 → 注意事项/回退 → 排查备忘。
   文件名保持不变（`docs/04-测试/主节点bug解决.md:772`、`note/ESP-IDF6.0.1本地补丁...` 都引用它）。
2. **新增** `note/FreeType运行时矢量字体-从TTF子集到UI渲染.md`（约 470 行）：
   九节 —— 为什么换烘焙字体 / 整体链路图 / **Python 端全流程**（选字体两轮试错、
   字符集按 GB2312 编码区间遍历、**可变字体默认轴 100 的坑**、subset 六个参数逐个解释、
   两份 cmap 对照区分"源字体缺失 vs 子集丢字"、meta 内容、一行命令复现）/
   固件端（依赖与 5 个关键 Kconfig、**为什么不能直读 SPIFFS**、PSRAM 预载 + 内存 VFS、
   创建时机、轻量校验、行高口径、运行期字体不能当 LV_FONT_DEFAULT）/
   三个血泪数字（栈 hwm 说谎、渲染窗口放大器、SPI_MAX_TRANSFER_SZ 不同步、-O2 ICE）/
   降级 / 11 条坑清单 / 实测汇总 / 操作手册。
3. `docs/03-开发/FreeType字体接入-行高适配与内存实测报告.md` §8 加上新笔记的指针。
4. `docs/04-测试/主节点bug解决.md` 末尾补"最终定案"一节：明确否定旧判据
   （"跑 1~2 天不崩即断根"），记录第 7 次崩溃证据与 GPIO 模拟的改动/结果/遗留。

## SD 卡音乐中文显示乱码：定位为 FATFS API 编码 + 修 UTF-8 截断（2026-10-29 11:40）

蓝牙正常、SD 卡全乱，根因不在字体库（字体只负责"码点→字形"），而在数据源编码：
- `Play_Master/sdkconfig` 原为 `CONFIG_FATFS_API_ENCODING_ANSI_OEM=y` + `CODEPAGE_936`
  → FF_LFN_UNICODE=0，`readdir()` 的 `d_name` 是 **GBK 字节**；
- `Music_Scan_Local_Msg` 把 `d_name` 原样 memcpy 进 `display_name`（无任何转换）；
- LVGL 侧 `CONFIG_LV_TXT_ENC_UTF8=y` + `lv_freetype_font_create`（纯动态字形），
  按 UTF-8 解析 GBK 字节 → 码点算错 → 乱码，字形再全也没用；
- 蓝牙源 `BT_AUDIO_EVT_TRACK_INFO` 的 title/artist 来自手机 AVRCP，本身就是 UTF-8，
  所以正常。两条路径唯一差别是源字符串编码，与字体无关。

采用方案 A + E：
1. **A**：sdkconfig 切 `CONFIG_FATFS_API_ENCODING_UTF_8=y`（CODEPAGE 保持 936，仍用于 8.3 SFN）。
   全仓路径常量都是 ASCII，切换无副作用；FAT 目录项本身是 UTF-16，**卡里的歌不用重拷**。
2. **E**：
   - `music_play.h`：`path[128]→[192]`、`display_name[64]→[96]`（UTF-8 3 字节/汉字，
     96≈31 汉字；512 首时 tracks 从 ~100KB 增到 ~148KB，走 PSRAM 无压力）；
   - `music_play.c` 新增 `Music_Utf8_Clip()`：从 max_bytes 回退跳过 10xxxxxx 续字节，
     不切断多字节字符；用于 scan 的 display_name、蓝牙 title/artist 拼接、artist-only 分支；
   - scan 拼 path 时**超长直接跳过 + LOGW**（原按字节截断会得到"看着正常却 f_open 失败"的路径）；
   - 顺手修两处越界：path 的 room 少扣 1 字节（会写到 display_name[0]）；
     蓝牙 `used < room` 时拼 " - " 三字节会越界 2 字节（改 `used + 3 <= room`）。

遗留/后续：ID3v2 标签解析（方案 C）未做；字体子集只覆盖 GB2312，
文件名含 emoji/假名仍会显示 □（不是乱码）。未编译、未烧录，由用户自行验证。

## 回退 IDF 本地补丁：恢复官方 v6.0.1（2026-10-29 11:30）

决定：**方案 A —— 回退**。理由（结论已写进文档，避免以后重复讨论）：
- 补丁是死代码：触摸改 GPIO 模拟后，全工程 `I2c_Init_Bus/I2c_Add_Device/I2c_Read_Bytes`
  零调用，`s_i2c_hw_fsm_reset()` 走不到；
- 它没兑现承诺：只把崩溃从 103min 推迟到 2.35h，第 7 次换了入口（PC 在 ISR 函数序言）；
- 隐性副作用：`esp_intr_disable(intr_handle)` 关的是**整条总线**中断，
  将来同总线挂第二个设备时会挡别人的 ISR；
- 工具链与官方不一致且无任何构建期提示 = 最难查的一类债。
- 知识不依赖改动存在：patch 文件（标准 git diff）+ 两份 note 已完整记录。

执行：
```
git -C F:/esp_idf_6.0.1/esp_tool/v6.0.1/esp-idf checkout -- components/esp_driver_i2c/i2c_master.c
```
校验：`git status --porcelain` 输出为空，`git diff --quiet` 通过，补丁标记 0 处。
IDF 目录是 git 仓库，HEAD = `8c19b1560 change(version): Update version to 6.0.1`。
**这是 IDF 唯一的本地改动**（`git status` 只有那一个 M），回退后整个工具链干净。

文档同步（4 处，避免以后去 IDF 里找不存在的补丁）：
1. `note/ESP-IDF6.0.1本地补丁-i2c_fsm_reset关中断.md` 顶部加 ⛔ 横幅：已回退、当前状态、
   什么时候需要重打、重打前先读 2.3 节；
2. `note/触摸I2C间歇NACK-InterruptWDT自锁-软件侧降暴露.md` 2.3 表格那行 + 一段说明；
3. `docs/03-开发/触摸I2C改为GPIO模拟.md` 第 35 行（补一句已回退）；
4. `docs/04-测试/主节点bug解决.md`：第 6 次崩溃那节加 ⛔ 一行、遗留条目改为删除线 + 说明、
   "必须重打"改为"当时的要求"。

另确认：`Play_Master/.../minimp3/minimp3.h` 也有"本地补丁"字样，但它是**仓库内的 vendored
文件**（git 已跟踪），随工程走、可复现，不属于工具链魔改，不用处理。

待办：用户重建一次（IDF 源码变了，`esp_driver_i2c` 需重编，避免板上固件与源码不一致）。
