currygood/MusicPlaySyncSpeakers/note/开关机问题.md

在用LCD之后无法关机！！！

/* SD 卡测试与 LCD 测试各自为任务：同一条 SPI2 总线，SD 测完再通知 LCD */

    // xTaskCreatePinnedToCore(Sd_Card_Test_Task, "sd_test", 8192, NULL, 5, NULL, 0);

    // xTaskCreatePinnedToCore(Lcd_Touch_Test_Task, "lcd_test", 8192, NULL, 4, &s_lcdTestTask, 0);

具体就是用这两段任务就无法开关机

进一步确认，LCD的问题，只是用sd卡没问题的
