currygood/MusicPlaySyncSpeakers/note/板子自动断电问题.md

单独测试sd卡没问题，单独LCD屏幕没问题，LCD屏幕和sd卡测试一起也没问题。就是这个Audio_Decoder_Test测试就会自动断电
