currygood/MusicPlaySyncSpeakers/note/原理图AndPCB.md

串口的TX和RX要注意，每次都要检查，TX对RX，RX对TX，不要TX对TX了，这个很容易犯错，所以每次打板前要检查
