currygood/MusicPlaySyncSpeakers/note/焊接.md

SMD封装的esp32，焊接的时候给的锡膏太多了导致用焊台焊的时候，下面引脚通过焊桥连起来了，肉眼看外面看不出来是连起来了。所以板子焊接好一定要全部都测一遍！！！
