currygood/MusicPlaySyncSpeakers/Play_Master/项目后续修改.md

1. i2s_driver模块，在自己的板子测试没问题之后就修改成统一的TX和RX的，而不是专门针对这个INMP441和NS4168（注意先初始化麦克风，再初始化功放，也就是先初始化I2S的RX再初始化TX）--**已做**
