currygood/MusicPlaySyncSpeakers/Play_Slave/音频同步协议.md

# 音频同步协议

> 整理自《项目文档.md》双设备同步协议设计章节。

| 项目 | 内容 |
| :--- | :--- |
| 文档名称 | 音频同步协议 |
| 文档版本 | v0.1（草稿） |
| 编制日期 | 2026-09-15 |

------

## 🌐 双设备同步协议设计

### 音频数据包格式（自定义轻量级 RTP）

采用 UDP 组播（IP 组播地址 `239.0.0.1`，端口 `5678`），每个音频包携带约 **15ms** 的 PCM 数据：

```reStructuredText
+----------------+----------------+----------------+----------------+
|  Magic (0xAA55) |  Seq (16bit)   |  Timestamp (32bit) |  Data Len (16) |
+----------------+----------------+----------------+----------------+
|  Audio Data (PCM, 16bit, 44.1kHz, 单声道)  最大 1323 字节   |
+-----------------------------------------------------------------+
```

| 字段 | 大小 | 说明 |
| :--- | :----- | :--- |
| Magic | 2 字节 | 包起始标志 `0xAA55`，用于同步和过滤干扰 |
| Seq | 2 字节 | 序列号，递增（0~65535 循环），从节点用于检测丢包 |
| Timestamp  | 4 字节 | 主节点发送时的微秒级时间戳（`esp_timer_get_time()`） |
| Data Len | 2 字节 | 实际 PCM 数据长度（字节），最大 1323 字节 |
| Audio Data | 变长 | PCM 数据（16bit, 44.1kHz, 单声道），约 15ms 时长 |

> **包大小计算**：15ms × 44.1kHz × 2 字节 = 1323 字节，加上 10 字节头部，共约 1333 字节，UDP 包远小于 MTU 1500 字节，避免 IP 分片。

### 控制命令包（端口 5679）

控制命令使用独立端口（5679），同样通过组播发送，格式如下：

```reStructuredText
+----------------+----------------+----------------+
|  Magic (0xAA55) |  Cmd (8bit)    |  Param (8bit) |
+----------------+----------------+----------------+
```

| 命令码 | 含义 | Param |
| :----- | :--- | :--- |
| 0x01 | PLAY | 0 |
| 0x02 | PAUSE | 0 |
| 0x03 | NEXT | 0 |
| 0x04 | PREV | 0 |
| 0x05 | VOLUME | 0~100 |
| 0x06 | SYNC_RESET | 0（强制从节点重新同步） |

------

## 参考资料

- [RFC 3550 RTP 协议](https://tools.ietf.org/html/rfc3550)
