currygood/MusicPlaySyncSpeakers/docs/02-设计/主音频节点软件构架分层设计.md

# 主音频节点软件架构分层设计

> **节点型号**：ESP32-WROVER-E-N16R8
> **文档范围**：仅描述**音频主节点**的软件架构；从节点固件另行设计。
> **核心原则**：App 层不直接调用 ESP-IDF 蓝牙 API；所有音频源 PCM 统一进入 `sync_protocol` 调度；`audio_decoder` 仅用于 SD 卡 MP3 解码；主节点本地播放也延迟 `D`，与从节点同步。

------

## 1. 设计原则

**分层解耦**：BSP → 中间件 → 应用层，单向依赖。

------

## 2. 分层架构总览

```reStructuredText
┌─────────────────────────────────────────────────────────────┐
│                        应用层 (App)                         │
│     MusicPlay(含源选择)     │    UI    │    LightControl    │
└──────────────┬──────────────────────────────────────────────┘
               │ 调用中间件 API / 接收事件
┌──────────────▼──────────────────────────────────────────────┐
│                      中间件层 (middlewares)                  │
│  LCD_Touch  │  sd_card  │  audio_decoder  │  bt_audio       │
│             │ amplifier │                 │  sync_protocol  │
└──────────────┬──────────────────────────────────────────────┘
               │ 调用 BSP 驱动
┌──────────────▼──────────────────────────────────────────────┐
│                         BSP 层 (bsp)                        │
│   gpio_driver  │  i2c_driver  │  i2s_driver  │  spi_driver  │
└──────────────┬──────────────────────────────────────────────┘
               │
┌──────────────▼──────────────────────────────────────────────┐
│                     硬件 (ESP32-WROVER-E)                   │
│  GPIO / I2C / I2S / SPI / 蓝牙 / WiFi / SD / LCD / 触摸     │
└─────────────────────────────────────────────────────────────┘

横切服务：msystem（ota_manager / wifi_manager / node_role / StartAndStop）
```

------

## 3. 各层详细设计

> **接口依据**：本章接口取自 `Play_Master/components` 当前的公开头文件。已实现模块列出真实函数签名；未实现模块只保留架构位置，不虚构接口。

### 3.1 BSP 层（board support package）

#### 3.1.1 `gpio_driver`

- **实现状态**：已实现（`gpio_driver.h` / `gpio_driver.c`）。
- **职责**：封装 GPIO 模式配置、电平读写、翻转和中断处理。
- **对外接口**：

```c
esp_err_t Gpio_Init(gpio_num_t gpioNum, Gpio_Mode_t mode);
void Gpio_Set_Level(gpio_num_t gpioNum, uint8_t level);
uint8_t Gpio_Get_Level(gpio_num_t gpioNum);
void Gpio_Toggle(gpio_num_t gpioNum);
esp_err_t Gpio_Install_Isr_Service(int flags);
esp_err_t Gpio_Set_Intr_Type(gpio_num_t gpioNum, gpio_int_type_t intrType);
esp_err_t Gpio_Isr_Handler_Add(gpio_num_t gpioNum, gpio_isr_t isrHandler, void *args);
esp_err_t Gpio_Intr_Enable(gpio_num_t gpioNum);
```

#### 3.1.2 `i2c_driver`

- **实现状态**：已实现（`i2c_driver.h` / `i2c_driver.c`）。
- **职责**：初始化 I²C 主机总线、挂载设备、执行寄存器与多字节读写。
- **对外接口**：

```c
esp_err_t I2c_Init_Bus(i2c_port_t port, gpio_num_t sda_pin, gpio_num_t scl_pin,
                       uint32_t freq_hz, i2c_master_bus_handle_t *bus_handle);
esp_err_t I2c_Add_Device(i2c_master_bus_handle_t bus_handle, uint16_t dev_addr,
                         uint32_t freq_hz, i2c_master_dev_handle_t *dev_handle);
esp_err_t I2c_Write_Reg(i2c_master_dev_handle_t dev_handle, uint8_t reg, uint8_t data);
esp_err_t I2c_Read_Reg(i2c_master_dev_handle_t dev_handle, uint8_t reg, uint8_t *data);
esp_err_t I2c_Read_Bytes(i2c_master_dev_handle_t dev_handle, uint8_t reg,
                         uint8_t *buffer, size_t count);
esp_err_t I2c_Remove_Device(i2c_master_dev_handle_t dev_handle);
esp_err_t I2c_Delete_Bus(i2c_master_bus_handle_t bus_handle);
i2c_master_bus_handle_t I2c_Get_Global_Bus_Handle(void);
esp_err_t I2c_Write_Bytes(i2c_master_dev_handle_t dev_handle, uint8_t reg,
                          uint8_t *buffer, size_t count);
```

#### 3.1.3 `i2s_driver`

- **实现状态**：已实现（`i2s_driver.h` / `i2s_driver.c`）。
- **职责**：创建单向 I2S TX/RX 物理总线，参数化引脚、采样格式、DMA 深度和采样率。
- **对外接口**：

```c
esp_err_t i2s_bus_phy_create(i2s_port_t port, bool is_tx,
                             const i2s_pin_cfg_t *pin_cfg,
                             const i2s_bus_cfg_t *bus_cfg,
                             i2s_bus_handle_t *out_handle);
esp_err_t i2s_bus_phy_write(i2s_bus_handle_t bus, const uint8_t *buffer,
                            size_t size, size_t *bytes_written, uint32_t timeout);
esp_err_t i2s_bus_phy_read(i2s_bus_handle_t bus, uint8_t *buffer,
                           size_t size, size_t *bytes_read, uint32_t timeout);
esp_err_t i2s_bus_phy_flush(i2s_bus_handle_t bus);
esp_err_t i2s_bus_phy_set_sample_rate(i2s_bus_handle_t bus, uint32_t sample_rate);
void i2s_bus_phy_debug_dma(i2s_bus_handle_t bus);
esp_err_t i2s_bus_phy_destroy(i2s_bus_handle_t bus);
```

#### 3.1.4 `spi_driver`

- **实现状态**：已实现（`spi_driver.h` / `spi_driver.c`）。
- **职责**：管理 SPI2 主机总线和多 CS 从设备，支持时钟切换、手动 CS 会话和全双工收发。
- **对外接口**：

```c
esp_err_t Spi_Init(Spi_Config_t *config);
bool Spi_Is_Bus_Created(void);
esp_err_t Spi_Deinit(void);
Spi_Handle_t Spi_Register_Device(const Spi_DeviceConfig_t *config);
esp_err_t Spi_Device_Set_Clock(Spi_Handle_t handle, int clock_speed_hz);
esp_err_t Spi_Transmit(Spi_Handle_t handle, const uint8_t *data, size_t length);
esp_err_t Spi_Transmit_16Bit(Spi_Handle_t handle, uint16_t data);
esp_err_t Spi_Receive(Spi_Handle_t handle, uint8_t *buffer, size_t length);
esp_err_t Spi_Transmit_Receive(Spi_Handle_t handle,
                               const uint8_t *tx_buffer, uint8_t *rx_buffer,
                               size_t length);
esp_err_t Spi_Transmit_CS(int csPin, const uint8_t *data, size_t length);
esp_err_t Spi_Receive_CS(int csPin, uint8_t *buffer, size_t length);
esp_err_t Spi_Transmit_Receive_CS(int csPin,
                                  const uint8_t *tx_buffer, uint8_t *rx_buffer,
                                  size_t length);
esp_err_t Spi_Device_Acquire(Spi_Handle_t handle);
esp_err_t Spi_Device_Release(Spi_Handle_t handle);
esp_err_t Spi_Device_SetCS(Spi_Handle_t handle, bool level);
int  Spi_Get_Priority(Spi_Handle_t handle);

/* 会话仲裁（优先级准入 + 会话预算 + 防饿死） */
void *Spi_Device_Session_Start(Spi_Handle_t handle, const spi_session_cfg_t *cfg);
void  Spi_Device_Session_End(void *session);
bool  Spi_Device_Session_Yield_If_Needed(void *session);
esp_err_t Spi_Device_Session_Yield(void *session);

/* 仲裁观测 */
esp_err_t Spi_Get_Stats(Spi_Handle_t handle, spi_stats_t *out);
void      Spi_Dump_Stats(void);
```

> BSP 层只关心“如何操作硬件”，不包含音频业务、文件系统或应用策略。

**总线仲裁（优先级准入 + 会话预算）**：

- 设备在 `Spi_DeviceConfig_t` 声明优先级（`SPI_PRIO_LOW/NORMAL/HIGH`）：
  LCD 刷屏 = HIGH，SD 卡数据流 = NORMAL（格式化等后台操作可用 LOW）；
- 会话式设备（SD 卡）在长等待循环与多扇区读写边界调用
  `Spi_Device_Session_Yield_If_Needed()`：有更高优先级设备在等、或本段连续
  占用超过会话预算（默认 10ms）时主动让出，让 LCD 插入一笔事务后立即续回；
  让出期间 CS 保持低电平，SD 命令序列不中断；
- `Spi_Get_Stats()` / `Spi_Dump_Stats()` 输出每设备的持有/等待/让出统计，
  用于验证“UI 最长事务等待”与 SD 吞吐的平衡（板级调参依据）。

------

### 3.2 中间件层（middlewares）

#### 3.2.1 `LCD_Touch`

- **实现状态**：已实现（`LCD_Touch.h` / `LCD_Touch.c`）。
- **职责**：驱动 ILI9341 LCD 与 FT6336G 触摸控制器；LCD 走 SPI，触摸走 I²C。
- **依赖**：`spi_driver`、`i2c_driver`、GPIO。
- **对外接口**：

```c
void LCD_TOUCH_Init(i2c_master_bus_handle_t i2cBusHandle);
void LCD_Write_Cmd(uint8_t cmd);
void LCD_Write_Data(uint8_t data);
void LCD_Write_Data_16Bit(uint16_t data);
void LCD_Set_Window(uint16_t xStart, uint16_t yStart, uint16_t xEnd, uint16_t yEnd);
void LCD_Fill_Color(uint16_t color);
void LCD_Write_PixelData(const uint16_t *data, uint32_t pixelCount);
void LCD_Set_Backlight(bool state);
bool LCD_TOUCH_FT6336G_Get_Touch_Points(Touch_Point_t *touchPoint);
TaskHandle_t LCD_TOUCH_FT6336G_Get_Task_Handle(void);
```

- **备注**：LCD 复位与触摸复位共用 GPIO 25；触摸任务由模块内部创建。

#### 3.2.2 `sd_card`

- **实现状态**：已实现（`sd_card.h` / `sd_card.c`）。
- **职责**：自实现 SD SPI 协议，挂载 FATFS 到 `/sdcard`，提供句柄式文件读写。
- **依赖**：`spi_driver`、FATFS/VFS。
- **对外接口**：

```c
esp_err_t SD_Card_Init(void);
esp_err_t SD_Card_Deinit(void);
esp_err_t SD_Card_Diag(void);
void SD_Card_Diag_File(void);
esp_err_t SD_Card_Format(void);
void SD_Card_Set_Format_Once(bool enable);
bool SD_Card_Is_Mounted(void);
const char *SD_Card_Get_Mount_Point(void);
sd_card_file_handle_t SD_Card_Open(const char *path, const char *mode);
esp_err_t SD_Card_Read(sd_card_file_handle_t file, void *buffer, size_t size, size_t *bytes_read);
esp_err_t SD_Card_Write(sd_card_file_handle_t file, const void *buffer, size_t size, size_t *bytes_written);
esp_err_t SD_Card_Seek(sd_card_file_handle_t file, long offset, int whence);
esp_err_t SD_Card_Tell(sd_card_file_handle_t file, size_t *position);
esp_err_t SD_Card_Close(sd_card_file_handle_t file);
```

- **备注**：SD 卡与 LCD 共用 SPI2 总线；SD 模块使用独立 CS 和手动 CS 会话。SD 卡**仅存放音乐文件**（`/sdcard/music/`）；**UI 图片（3 张 PNG）存放在 Flash `storage` 分区**（`spiffs_create_partition_image` 随固件烧录，UI 挂载 `/storage` 后经 LVGL 盘符 `'F'` 读取），**中文字体/图标由 `lv_font_conv` 生成 C 数组编译进固件**，UI 不再依赖 SD 卡读取任何资源。

#### 3.2.3 `audio_decoder`

- **实现状态**：已实现（`components/middlewares/audio_decoder/audio_decoder.h` / `audio_decoder.c`）。
- **架构位置**：只负责解码 SD 卡 `/sdcard/music` 下 MP3 文件为 16-bit PCM，解码任务在模块内部创建，通过 `on_pcm` 回调把 PCM 交给 `MusicPlay`（仅注册回调）统一喂给 `sync_protocol`。
- **解码库方案**：MP3 使用离线单头文件库 `minimp3`（CC0-1.0），随模块一起维护在 `third_party/minimp3/`；当前仅支持 MP3，WAV 等其他格式暂不支持。
- **设计约束**：
  - 播放/暂停/上下曲归 `MusicPlay`，模块内部只提供解码与输出回调。
  - 当前不做 `seek()` 回拉；但保留 `get_position_ms()` 给 UI 显示进度。
  - 音量不做在本模块，由 `amplifier`/上层控制。
- **对外接口**：

```c
/* 句柄 */
typedef struct audio_decoder_s *audio_decoder_handle_t;

/* 音频格式 */
typedef enum {
    AUDIO_DECODER_FMT_MP3 = 0,
} audio_decoder_format_t;

/* 文件参数 */
typedef struct {
    audio_decoder_format_t format;
    uint32_t               sample_rate;
    uint8_t                channels;
    uint32_t               duration_ms;
    uint32_t               bitrate_bps;
} audio_decoder_info_t;

/* PCM 输出回调：解码任务上下文调用，直接进 sync_protocol */
typedef void (*audio_decoder_pcm_cb_t)(const int16_t *pcm,
                                       size_t samples,
                                       uint32_t sample_rate,
                                       uint8_t channels,
                                       void *user_ctx);

/* 播放/编解码事件回调 */
typedef enum {
    AUDIO_DECODER_EVT_READY,   /* 文件头解析完成，可读取参数 */
    AUDIO_DECODER_EVT_EOF,     /* 解码到文件尾，MusicPlay 切下一首 */
    AUDIO_DECODER_EVT_ERROR,   /* 文件损坏/解码失败 */
} audio_decoder_event_id_t;

typedef void (*audio_decoder_event_cb_t)(audio_decoder_event_id_t event,
                                         const audio_decoder_info_t *info,
                                         void *user_ctx);

/* 打开文件时的配置 */
typedef struct {
    audio_decoder_pcm_cb_t   on_pcm;
    void                   *pcm_ctx;
    audio_decoder_event_cb_t on_event;
    void                   *event_ctx;
} audio_decoder_cfg_t;

/* 生命周期 */
esp_err_t audio_decoder_init(void);
esp_err_t audio_decoder_deinit(void);

/* 打开并解码 SD 卡文件（如 "/sdcard/music/a.mp3"） */
audio_decoder_handle_t audio_decoder_open(const char *path,
                                          const audio_decoder_cfg_t *cfg);

esp_err_t audio_decoder_close(audio_decoder_handle_t dec);

/* 播放/暂停/停止（内部解码任务驱动 on_pcm 回调） */
esp_err_t audio_decoder_play(audio_decoder_handle_t dec);
esp_err_t audio_decoder_pause(audio_decoder_handle_t dec);
esp_err_t audio_decoder_stop(audio_decoder_handle_t dec);

/* 查询文件参数 / 当前进度（UI） */
esp_err_t audio_decoder_get_info(audio_decoder_handle_t dec,
                                 audio_decoder_info_t *info);
esp_err_t audio_decoder_get_position_ms(audio_decoder_handle_t dec,
                                        uint32_t *position_ms);
```

- **对外接口补充**：`audio_decoder_pcm_cb_t` 为对外同步回调的唯一出口，由 `MusicPlay` 注册并将回调指向 `sync_protocol_master_push_pcm()`；不提供 `seek()`。

#### 3.2.4 `bt_audio`

- **实现状态**：已实现（`components/middlewares/bt_audio/bt_audio.h` / `bt_audio.c`）。
- **架构位置**：封装经典蓝牙协议栈，提供 A2DP Sink 与 AVRCP 控制；HFP(HF) 代码保留但当前无调用者，不会建立连接。
- **设计约定**：
  - PCM 下行（A2DP 音乐；HFP 语音应答通道保留但无调用者）统一通过 `on_pcm` 回调交给 `sync_protocol`，不经过 App 层。
  - UI 控制统一走 `bt_audio_send_ctrl_cmd()`；手机 AVRCP 状态统一通过 `on_event` 回调交给 UI。
  - 蓝牙协议栈回调内不直接调用外部回调；`bt_audio` 内部先入 FIFO，再在自身任务上下文触发 `on_event` / `on_pcm`。
- **对外接口**：

```c
/* 句柄 */
typedef struct bt_audio_s *bt_audio_handle_t;

/* PCM 方向 */
typedef enum {
    BT_AUDIO_PCM_SOURCE_A2DP,         /* 手机音乐，16bit 双声道 */
    BT_AUDIO_PCM_SOURCE_HFP_DOWNLINK, /* 手机语音助手应答，16bit SCO PCM */
} bt_audio_pcm_source_t;

/* 控制命令（UI → 手机） */
typedef enum {
    BT_AUDIO_CMD_PLAY,
    BT_AUDIO_CMD_PAUSE,
    BT_AUDIO_CMD_TOGGLE_PLAY,
    BT_AUDIO_CMD_PREV,
    BT_AUDIO_CMD_NEXT,
    BT_AUDIO_CMD_VOLUME_UP,
    BT_AUDIO_CMD_VOLUME_DOWN,
} bt_audio_cmd_t;

/* 播放状态 / 歌曲信息 */
typedef enum {
    BT_AUDIO_PLAY_STATE_UNKNOWN = 0,
    BT_AUDIO_PLAY_STATE_PLAYING,
    BT_AUDIO_PLAY_STATE_PAUSED,
    BT_AUDIO_PLAY_STATE_STOPPED,
} bt_audio_play_state_t;

typedef struct {
    char     title[256];
    char     artist[128];
    char     album[128];
    uint32_t track_num;
    uint32_t total_tracks;
    uint32_t duration_ms;
} bt_audio_track_info_t;

/* A2DP 参数 */
typedef struct {
    bool     connected;
    uint32_t sample_rate;
    uint8_t  channels;
    uint8_t  bits_per_sample;
} bt_audio_a2dp_info_t;

/* 事件 */
typedef enum {
    BT_AUDIO_EVT_A2DP_CONNECTED,
    BT_AUDIO_EVT_A2DP_DISCONNECTED,
    BT_AUDIO_EVT_A2DP_STREAM_STARTED,
    BT_AUDIO_EVT_A2DP_STREAM_STOPPED,
    BT_AUDIO_EVT_A2DP_SAMPLE_RATE_CHANGED,
    BT_AUDIO_EVT_HFP_CONNECTED,
    BT_AUDIO_EVT_HFP_DISCONNECTED,
    BT_AUDIO_EVT_HFP_AUDIO_OPEN,
    BT_AUDIO_EVT_HFP_AUDIO_CLOSE,
    BT_AUDIO_EVT_PLAY_STATE_CHANGED,
    BT_AUDIO_EVT_TRACK_CHANGED,
    BT_AUDIO_EVT_TRACK_INFO,
    BT_AUDIO_EVT_VOLUME_CHANGED,
} bt_audio_event_id_t;

typedef struct {
    bt_audio_event_id_t id;
    uint8_t remote_addr[6];
    union {
        bt_audio_play_state_t play_state;
        bt_audio_track_info_t track_info;
        uint8_t               volume;
        uint32_t              sample_rate;
    } data;
} bt_audio_event_t;

/* 对外回调 */
typedef void (*bt_audio_pcm_cb_t)(bt_audio_pcm_source_t source,
                                  const int16_t *pcm, size_t samples,
                                  uint32_t sample_rate, void *user_ctx);
typedef void (*bt_audio_event_cb_t)(const bt_audio_event_t *evt, void *user_ctx);

/* 配置 */
typedef struct {
    const char *device_name;
    uint32_t    a2dp_fifo_bytes;
    uint32_t    hfp_fifo_bytes;
    bt_audio_pcm_cb_t on_pcm;
    void *pcm_ctx;
    bt_audio_event_cb_t on_event;
    void *event_ctx;
} bt_audio_cfg_t;

/* 生命周期与发现 */
bt_audio_handle_t bt_audio_create(const bt_audio_cfg_t *cfg);
esp_err_t         bt_audio_destroy(bt_audio_handle_t audio);
esp_err_t bt_audio_start(bt_audio_handle_t audio);
esp_err_t bt_audio_stop(bt_audio_handle_t audio);
esp_err_t bt_audio_set_device_name(bt_audio_handle_t audio, const char *name);
esp_err_t bt_audio_set_discoverable(bt_audio_handle_t audio, bool enable);

/* A2DP */
esp_err_t bt_audio_get_a2dp_info(bt_audio_handle_t audio, bt_audio_a2dp_info_t *info);

/* HFP 语音助手（麦克风上行） */
esp_err_t bt_audio_hfp_start_voice(bt_audio_handle_t audio);
esp_err_t bt_audio_hfp_stop_voice(bt_audio_handle_t audio);
esp_err_t bt_audio_hfp_send_pcm(bt_audio_handle_t audio,
                                const int16_t *pcm, size_t samples,
                                uint32_t timeout_ms);
esp_err_t bt_audio_hfp_wait_audio_open(bt_audio_handle_t audio,
                                       uint32_t timeout_ms); /* 阻塞等待 SCO 打开 */
bool      bt_audio_hfp_is_audio_open(bt_audio_handle_t audio); /* 查询 SCO 是否已打开 */

/* AVRCP：UI 控制 */
esp_err_t bt_audio_send_ctrl_cmd(bt_audio_handle_t audio, bt_audio_cmd_t cmd);
esp_err_t bt_audio_get_play_state(bt_audio_handle_t audio, bt_audio_play_state_t *state);
esp_err_t bt_audio_get_track_info(bt_audio_handle_t audio,
                                  const bt_audio_track_info_t **info);

/* 音量 */
esp_err_t bt_audio_set_volume(bt_audio_handle_t audio, uint8_t volume);
uint8_t   bt_audio_get_volume(bt_audio_handle_t audio);

/* 调试 */
uint32_t bt_audio_get_pcm_dropped(bt_audio_handle_t audio, bt_audio_pcm_source_t source);
```

- **边界**：App 层不得直接调用 ESP-IDF 蓝牙 API。
- **备注**：esp-idf内部解码器自动把手机通过蓝牙传的SBC解码成PCM

#### 3.2.5 `microphone`（已移出构建）

- **状态**：麦克风与语音唤醒整条链路已下线，模块（INMP441）已移入 `Play_Master/legacy_disabled/microphone`，不在构建内，当前无调用者。

#### 3.2.6 `amplifier`

- **实现状态**：已实现（`amplifier.h` / `amplifier.c`）。
- **职责**：- **职责**：封装 NS4168 功放输出链路，持有 I2S TX 与内部写锁，将 PCM 直接写入 I2S，并维护软件音量值。。
- **依赖**：`i2s_driver`、FreeRTOS。
- **对外接口**：

```c
esp_err_t Amplifier_Init(void);
esp_err_t Amplifier_Deinit(void);
esp_err_t Amplifier_Play_Buffer(const uint8_t *buffer, size_t size,
                                size_t *bytes_written, uint32_t timeout);
void Amplifier_Debug_DMA(void);
esp_err_t Amplifier_Set_Volume(uint8_t volume);
uint8_t Amplifier_Get_Volume(void);
```

- **备注**：当前音量只在软件层保存；NS4168 无软件音量控制接口。

#### 3.2.7 `audio_bus`（已删除）

- **状态**：已从代码中删除。多写者/多读者仲裁不再需要独立中间件：
  - TX 互斥收进 `amplifier`：模块内部写锁，`Amplifier_Play_Buffer()` 按块原子写 I2S；
  - RX 采集收进 `microphone`：内部读取任务 + 单一 FIFO，满时丢最旧；
- `microphone` 已随语音唤醒链路移出构建（`legacy_disabled/`），当前没有麦克风消费者。

#### 3.2.8 `sync_protocol`

- **实现状态**：已实现（`components/middlewares/sync_protocol/sync_protocol.h` / `sync_protocol.c`）。
- **架构位置**：汇聚 `bt_audio`（A2DP）与 `audio_decoder`（SD 卡）的 PCM，打时间戳后经 `wifi_manager` 音频通道逐台单播到从节点（UDP 5680）、并按 `t_play_us + 60ms` 经 `Amplifier_Play_Buffer()` 本地播放；本模块不持有 UDP socket，通道由 `wifi_manager` 统管。
- **源无关设计**：`sync_protocol` 不感知蓝牙/SD 等业务概念，只认 `stream_id + sample_rate + channels`。当前播放源由 App 层 `MusicPlay` 维护，换源时由 `MusicPlay` 重新调 `sync_protocol_master_start()` 并传入新 `stream_id`。
- **关键公式**：包头 `t_play_us = t_tx + D`（D 默认 200ms，NVS 可调）；主节点出声 `t_play_us + 60ms`（`SYNC_RX_MARGIN_US`）；从节点 `offset = d_min + lead_ms×1000 + 60ms`、出声 `t_play_us + offset`。
- **对外接口**：

```c
/* 状态枚举 */
typedef enum {
    SYNC_STATE_IDLE = 0,
    SYNC_STATE_PREPARING,   /* 已 start，等待灌入 D 缓冲 */
    SYNC_STATE_PLAYING,
    SYNC_STATE_PAUSED,
    SYNC_STATE_STOPPED,
    SYNC_STATE_ERROR,
} sync_protocol_state_t;

/* 控制命令（同步广播给从节点） */
typedef enum {
    SYNC_CMD_PLAY     = 0x01,
    SYNC_CMD_PAUSE    = 0x02,
    SYNC_CMD_NEXT     = 0x03,
    SYNC_CMD_PREV     = 0x04,
    SYNC_CMD_VOLUME   = 0x05,
    SYNC_CMD_RESET    = 0x06,
} sync_protocol_cmd_t;

/* 配置 */
typedef struct {
        /* sync_protocol 不注册 TX：经 Amplifier_Play_Buffer() 直接播放 */
    const char        *writer_name; /* 默认 "sync_protocol" */
    uint32_t  sync_delay_ms;        /* D，默认 200ms */
    uint32_t  frame_duration_ms;    /* 每包 PCM 时长，默认 15ms */
    uint32_t  delay_queue_pkts;     /* 本地延迟队列容量，不小于 D/帧时长 */
    uint32_t  ingress_bytes;        /* PCM 入环形缓冲，16~32KB 起步 */
    wifi_mcast_handle_t  audio_chan;    /* 音频通道（用于单播：绑定本机 5680、rx_enable=false；App 经 wifi_manager_mcast_open 创建，类型见 3.4.2） */
    wifi_mcast_handle_t  control_chan;  /* 控制命令组播通道 239.0.0.1:5679（rx_enable=true） */
} sync_protocol_master_cfg_t;

/* 状态快照 */
typedef struct {
    sync_protocol_state_t state;
    uint16_t         stream_id;
    uint32_t         sample_rate;
    uint8_t          channels;
    uint32_t         frame_seq;
    uint32_t         tx_pkts;
    uint32_t         dropped_pkts;
    uint32_t         ingress_used;
    uint32_t         delay_queue_used;
    int64_t          play_delta_us;
    bool             slave_online;
    int32_t          last_slave_offset_us;
} sync_protocol_master_status_t;

/* 事件回调 */
typedef enum {
    SYNC_EVT_STATE_CHANGED,
    SYNC_EVT_STREAM_CHANGED,   /* stream_id 变化/换源 */
    SYNC_EVT_SLAVE_SYNCED,
    SYNC_EVT_SLAVE_LOST,
    SYNC_EVT_ERROR,
} sync_protocol_event_id_t;

typedef struct {
    sync_protocol_event_id_t      id;
    sync_protocol_master_status_t status;   /* 事件附带当前状态快照 */
} sync_protocol_event_t;

typedef void (*sync_protocol_event_cb_t)(const sync_protocol_event_t *evt,
                                         void *user_ctx);

/* ===== 主节点 API ===== */
esp_err_t sync_protocol_master_init(const sync_protocol_master_cfg_t *cfg);
esp_err_t sync_protocol_master_deinit(void);

esp_err_t sync_protocol_master_register_event_cb(
        sync_protocol_event_cb_t cb, void *user_ctx);

/* 启动一路流；换源时传新 stream_id（0 则自动生成） */
esp_err_t sync_protocol_master_start(uint16_t stream_id,
                                     uint32_t sample_rate,
                                     uint8_t  channels);
esp_err_t sync_protocol_master_stop(void);

/* 所有音源 PCM 统一入口（线程安全、非阻塞） */
esp_err_t sync_protocol_master_push_pcm(const int16_t *pcm, size_t samples);

esp_err_t sync_protocol_master_pause(void);
esp_err_t sync_protocol_master_resume(void);

esp_err_t sync_protocol_master_set_delay_ms(uint32_t delay_ms);
esp_err_t sync_protocol_master_set_sample_rate(uint32_t sample_rate);
esp_err_t sync_protocol_master_set_channels(uint8_t channels);

esp_err_t sync_protocol_master_broadcast_cmd(sync_protocol_cmd_t cmd,
                                             uint8_t param);
esp_err_t sync_protocol_master_get_status(sync_protocol_master_status_t *status);
uint32_t sync_protocol_master_get_tx_pkts(void);
uint32_t sync_protocol_master_get_dropped_pkts(void);
```

- **PCM 汇聚方式**：蓝牙 A2DP 经 `bt_audio.on_pcm` 回调调用 `push_pcm()`；SD 卡由 `audio_decoder` 解码任务直接调用 `push_pcm()`；麦克风上行链路已下线（`microphone` / `CallPhone` 移入 `legacy_disabled`），不进 `sync_protocol`。

------

### 3.3 应用层（App）

| 模块 | 架构职责 | 当前实现状态 |
| :--- | :--- | :--- |
| `MusicPlay` | 播放状态唯一主人；源选择（自动/手动，原 PlayMode 已并入）+ 播放/暂停、上下曲、音量，接口见 3.3.1 | 已实现（`components/App/MusicPlay/`） |
| `UI` | LVGL 界面、播放状态、同步状态、灯控入口、UI 图片资源（Flash `storage` 分区）、编译进固件的字体/图标 | 已实现（`components/App/UI/`）；不再依赖 `sd_card` 提供 UI 资源 |
| `LightControl` | 灯开关（on/off + ack 回执 + 30s 周期状态上报），接口见 3.3.3 | 已实现（`components/App/LightControl/`） |

#### 3.3.1 `MusicPlay`

- **实现状态**：已实现（`components/App/MusicPlay/`）；原 `PlayMode`（3.3.4）已并入本模块。
- **职责**：
  - 播放源、播放状态、音量、播放模式的唯一状态主人；
  - 蓝牙源驱动 `bt_audio`，本地源驱动 `audio_decoder`，同步控制走 `sync_protocol_master_broadcast_cmd()`；
  - 自动源选择：蓝牙优先级最高——内部按 `source_poll_ms` 轮询 `bt_audio_get_a2dp_info()`，连接→`MUSIC_SOURCE_BT`，断开→`MUSIC_SOURCE_LOCAL`（SD 继续播放）；
  - UI 触摸、自动/手动源选择、手机 AVRCP、本地解码事件都进入同一个事件队列，由内部状态机串行处理；
  - 手机与 UI 同时按键时，UI 指令作为“期望”，蓝牙源的最终状态以 `bt_audio` 事件为准；本地源由自身状态机为准。
  - **开机自动起播受「UI 就绪」闸门约束**（`music_play_set_autoplay()`，默认关闭）：自动源选择切到本地源时**只切源、不起播**，App 在 UI 首帧刷完（`ui_set_ready_cb` 回调）后放行，保证「先出界面，再出声」，不再出现开机黑屏先响。UI 不可用时 App 直接放行兜底；手动 PLAY / 选曲 / 切源与蓝牙源推流不受闸门影响。
- **播放模式**（按音源分别保存：本地源用 `local_mode`、蓝牙源用 `bt_mode`，互不覆盖）：
  - `MUSIC_PLAY_MODE_SINGLE_LOOP`：单曲循环，当前曲播完自动重播；
  - `MUSIC_PLAY_MODE_SEQUENTIAL`：顺序播放，当前曲播完自动播放下一首；<u>列表末首播完后回到第一首重新开始</u>。
- **对外接口**：

```c
/* 源 / 状态 */
typedef enum {
    MUSIC_SOURCE_NONE = 0,
    MUSIC_SOURCE_BT,
    MUSIC_SOURCE_LOCAL,
} music_source_t;

typedef enum {
    MUSIC_STATE_IDLE = 0,
    MUSIC_STATE_PLAYING,
    MUSIC_STATE_PAUSED,
    MUSIC_STATE_STOPPED,
    MUSIC_STATE_ERROR,
} music_state_t;

/* 播放模式（只支持两种） */
typedef enum {
    MUSIC_PLAY_MODE_SEQUENTIAL = 0,  /* 顺序播放，播完列表末尾回第一首 */
    MUSIC_PLAY_MODE_SINGLE_LOOP,     /* 单曲循环 */
} music_play_mode_t;

/* 命令 */
typedef enum {
    MUSIC_CMD_PLAY,
    MUSIC_CMD_PAUSE,
    MUSIC_CMD_RESUME,
    MUSIC_CMD_TOGGLE,
    MUSIC_CMD_NEXT,
    MUSIC_CMD_PREV,
    MUSIC_CMD_VOLUME_UP,
    MUSIC_CMD_VOLUME_DOWN,
} music_cmd_t;

/* 曲目 */
typedef enum {
    MUSIC_TRACK_FMT_MP3 = 0,
    MUSIC_TRACK_FMT_WAV,
} music_track_format_t;

typedef struct {
    music_track_format_t format;
    char path[128];
    char display_name[64];
    uint32_t duration_ms;
} music_track_t;

/* UI 可读状态快照 */
typedef struct {
    music_source_t     source;
    music_state_t      state;
    music_play_mode_t  mode;
    uint8_t            volume;
    uint16_t           track_index;
    uint16_t           track_count;
    const music_track_t *track;
    bool               pending_cmd;
} music_play_view_t;

/* 事件 */
typedef enum {
    MUSIC_EVT_SOURCE_CHANGED,
    MUSIC_EVT_PLAY_STATE_CHANGED,
    MUSIC_EVT_TRACK_CHANGED,
    MUSIC_EVT_TRACK_INFO,
    MUSIC_EVT_PLAYLIST_CHANGED,
    MUSIC_EVT_PLAY_MODE_CHANGED,
    MUSIC_EVT_VOLUME_CHANGED,
    MUSIC_EVT_EOF,
    MUSIC_EVT_ERROR,
} music_event_id_t;

typedef struct {
    music_event_id_t  id;
    music_play_view_t view;   /* 事件携带整体状态快照 */
} music_event_t;

typedef void (*music_event_cb_t)(const music_event_t *evt, void *user_ctx);

typedef struct {
    bt_audio_handle_t     bt_audio;      /* 蓝牙源句柄（App 创建传入） */
    wifi_mcast_handle_t   audio_chan;    /* 音频通道 239.0.0.1:5680（单播发送、rx 关闭；App 打开传入） */
    wifi_mcast_handle_t   control_chan;  /* 控制组播通道 239.0.0.1:5679（App 打开传入） */
    uint32_t              sync_delay_ms; /* 同步延迟 D（ms），0=从 node_role 读取 */
    uint32_t              source_poll_ms;/* 自动源选择轮询间隔（ms），0=默认 1000（原 PlayMode 的轮询间隔） */
    music_event_cb_t      on_event;
    void                 *event_ctx;
} music_play_cfg_t;

typedef struct music_play_s *music_play_handle_t;

/* 初始化 */
music_play_handle_t music_play_create(const music_play_cfg_t *cfg);
esp_err_t           music_play_destroy(music_play_handle_t player);

/* 控制 */
/* 手动源选择（UI 调用）：蓝牙优先自动规则仍在，连接期间切本地会被下一次轮询拉回 */
esp_err_t music_play_set_source(music_play_handle_t player, music_source_t source);
esp_err_t music_play_command(music_play_handle_t player, music_cmd_t cmd);

/* 查询当前播放源（UI 初始化/切页用） */
music_source_t music_play_get_source(music_play_handle_t player);

/* 本地列表 */
esp_err_t music_play_scan_local(music_play_handle_t player);
esp_err_t music_play_select_track(music_play_handle_t player, uint16_t index);
uint16_t  music_play_get_track_count(music_play_handle_t player);
const music_track_t *music_play_get_track(music_play_handle_t player, uint16_t index);

/* 播放模式 / 音量 */
esp_err_t music_play_set_mode(music_play_handle_t player, music_play_mode_t mode);
esp_err_t music_play_set_volume(music_play_handle_t player, uint8_t volume);
uint8_t   music_play_get_volume(music_play_handle_t player);

/* 状态查询 */
const music_play_view_t *music_play_get_view(music_play_handle_t player);

/* 播放进度（ms）：本地源取 audio_decoder，蓝牙源取 bt_audio（手机 PLAY_POS_CHANGED），
 * 未知时位置置 0（UI 据此隐藏进度条） */
esp_err_t music_play_get_position_ms(music_play_handle_t player, uint32_t *position_ms);

/* 内部事件入口（由 bt_audio / audio_decoder 调用，App 其余模块不直接使用） */
void music_play_on_bt_event(music_play_handle_t player, const bt_audio_event_t *evt);
void music_play_on_decoder_event(music_play_handle_t player,
                                 audio_decoder_event_id_t evt,
                                 const audio_decoder_info_t *info);
```

> App 层依赖中间件完成硬件操作；蓝牙控制最终只能经过 `bt_audio`。

------

#### 3.3.2 `CallPhone`（已移出构建）

- **状态**：唤醒词检测（`esp-sr`）与 HFP 语音上行桥接已整体下线，模块已移入 `Play_Master/legacy_disabled/CallPhone`，不在构建内；`bt_audio` 的 HFP 代码保留但无调用者，不会建立连接。

------

#### 3.3.3 `LightControl`

- **实现状态**：已实现（`components/App/LightControl/light_control.h` / `light_control.c`）。
- **职责**：
  - 封装灯控 JSON 协议，提供 on/off 开关**单个区域灯**的 App 接口（不支持全屋广播）；灯控节点是 ESP8266 独立工程，硬件为继电器，只能开/关、不能调亮度，当前只有一盏灯（`bedroom`）；
  - 数据包经 `wifi_manager` 灯控组播通道发送（默认 239.0.0.2:8889），不自行持有 socket；报文统一带 `version` 字段（当前 1）；
  - 解析灯控上行三类消息：即时回执 `{"cmd":"ack","light":"<name>","ok":<bool>,"version":1}`、周期状态上报 `{"cmd":"status","light":"<name>","ok":<bool>,"version":1}`（灯控每 30s 发送一次）、版本不兼容回告 `verr`，统一通过 `on_event` 回调通知 UI 刷新灯状态图标；
  - 灯状态以 `ack`/`status` 的 `ok` 字段为准（true=开、false=关），不再靠下发命令推断；未收到任何上行前为 `UNKNOWN`；
  - 周期上报的周期（30s）由灯控端约定，本模块只负责解析与超时判定：超过 `state_timeout_ms` 未收到该灯上行，发 `LIGHT_EVT_ERROR` 并把该灯状态回落 `UNKNOWN`。
- **对外接口**：

```c
/* 句柄 */
typedef struct light_control_s *light_control_handle_t;

/* 指令（对应 JSON 的 "cmd" 字段） */
typedef enum {
    LIGHT_CMD_ON = 0,   /* {"cmd":"on","light":"<name>"} */
    LIGHT_CMD_OFF,      /* {"cmd":"off","light":"<name>"} */
} light_cmd_t;

/* 灯状态（UI 图标用） */
typedef enum {
    LIGHT_STATE_UNKNOWN = 0,
    LIGHT_STATE_ON,
    LIGHT_STATE_OFF,
} light_state_t;

/* 灯控事件 */
typedef enum {
    LIGHT_EVT_ACK,     /* 收到即时回执 {"cmd":"ack",...} */
    LIGHT_EVT_STATUS,  /* 收到周期状态上报 {"cmd":"status",...}（每 30s） */
    LIGHT_EVT_ERROR,   /* 回执异常 / 状态上报超时 */
    LIGHT_EVT_INCOMPATIBLE, /* 对端协议 version 不兼容（高于本端支持） */
} light_event_id_t;

typedef struct {
    char          light[16];  /* 区域灯名，如 "bedroom" */
    bool          ok;         /* ack/status 上报：true=开，false=关 */
    light_state_t state;      /* 本次上报对应的实际开关状态（由 ok 归一化，超时时为 UNKNOWN） */
} light_event_data_t;

typedef struct {
    light_event_id_t    id;
    light_event_data_t  data;
} light_event_t;

typedef void (*light_control_event_cb_t)(const light_event_t *evt,
                                         void *user_ctx);

/* 配置 */
typedef struct {
    wifi_mcast_handle_t      chan;          /* 灯控组播通道（App 经 wifi_manager 创建传入，rx 需开启） */
    uint32_t                 tx_timeout_ms; /* 发送超时，默认 100 */
    uint32_t                 state_timeout_ms; /* 状态上报超时判定，默认 90000（3 x 30s 周期） */
    light_control_event_cb_t on_event;      /* 灯状态事件回调（ack / 30s status / 超时）：UI 刷新灯状态图标 */
    void                     *event_ctx;
} light_control_cfg_t;

/* 生命周期 */
light_control_handle_t light_control_create(const light_control_cfg_t *cfg);
void                   light_control_destroy(light_control_handle_t h);

/* UI 调用：开关某个灯 */
esp_err_t light_control_send(light_control_handle_t h,
                             light_cmd_t cmd, const char *light);

/* 查询某灯当前状态（UI 初始化 / 图标恢复；缓存最近一次 ack/status） */
esp_err_t light_control_get_state(light_control_handle_t h,
                                  const char *light,
                                  light_state_t *out);
```

------

#### 3.3.4 `PlayMode`（已并入 `MusicPlay`）

- **实现状态**：**已并入 `MusicPlay`（App 层）**，不再单独存在；原规划的 `components/App/PlayMode/` 取消。
- **并入原因**：源选择的唯一状态主人本就是 `MusicPlay`（3.3.1），独立 `PlayMode` 还需另存一份 source 与 `MusicPlay` 做数据流转；且 `MusicPlay` 的 `MUSIC_MSG_SELECT_TRACK` 在非本地源时会自行切到本地源，独立模块下会出现两份 source 不一致（UI 显示与实际播放不符）。
- **并入后的行为**（接口统一为 `music_play_` 前缀，见 3.3.1）：
  - 自动源选择：`MusicPlay_Task` 内按 `music_play_cfg_t.source_poll_ms`（默认 1000ms）轮询 `bt_audio_get_a2dp_info()`；A2DP 连接→`MUSIC_SOURCE_BT`，断开→`MUSIC_SOURCE_LOCAL`（SD 卡继续播放）；仅在源变化时切换。create 后首次轮询即判定，故开机未连蓝牙会自动落到本地源；
  - 手动切换：UI 调 `music_play_set_source(source)`；蓝牙优先自动规则仍在——连接期间切本地会被下一次轮询拉回蓝牙；
  - 通知 UI：源变化经 `music_event_cb_t` 的 `MUSIC_EVT_SOURCE_CHANGED` 上报；轮询 `bt_audio_get_a2dp_info()` 失败或源参数非法发 `MUSIC_EVT_ERROR`；
  - 查询：`music_play_get_source()`（UI 初始化/切页用）。

------

### 3.4 系统服务层（msystem）

#### 3.4.1 `StartAndStop`

- **实现状态**：已实现（`StartAndStop.h` / `StartAndStop.c`）。
- **职责**：初始化电源保持输出，检测电源键长按并执行关机。
- **对外接口**：

```c
void StartAndStop_Init(void);
void SystemStart(void);
```

#### 3.4.2 `wifi_manager`

- **实现状态**：已实现（`components/msystem/wifi_manager/wifi_manager.h`，接口与本节一致；事件类型因与 esp-idf 6.0.1 自带 `wifi_event_t` 重名，实现命名为 `wifi_mgr_event_t`）。
- **职责**：
  - STA 连接、断线自动重连；启动时凭据从 `node_role` 读取（本模块不直接写 NVS）；
  - 配网：当前无 WiFi 配网 UI，SSID / 密码存 `node_role`（NVS）；`wifi_manager_set_sta()` 只用新凭据立即发起连接，持久化仍由 `node_role` 负责；
  - 统一持有 UDP socket：音频数据（单播到各从节点 5680）、音频控制（组播 239.0.0.1:5679）、灯控（239.0.0.2:8889）等通道均由 `wifi_manager_mcast_open()` 创建并维护；WiFi 重连 / IP 变化后内部自动重建并重新加入组播，业务模块无感知；
  - 事件仅作状态通知，业务模块可选注册；UI 图标与 OTA 通过查询接口获取状态，不注册事件。
- **对外接口**：

```c
/* 句柄 */
typedef struct wifi_manager_s *wifi_manager_handle_t;

/* 状态（UI 图标 / OTA 用） */
typedef enum {
    WIFI_STATE_IDLE = 0,      /* 未启动/已停止 */
    WIFI_STATE_CONNECTING,    /* 连接中 */
    WIFI_STATE_CONNECTED,     /* 已连接并拿到 IP */
    WIFI_STATE_DISCONNECTED,  /* 断开，自动重连中 */
    WIFI_STATE_ERROR,         /* 重试用尽/凭据错误 */
} wifi_state_t;

/* 事件（状态通知，业务模块可选注册） */
typedef enum {
    WIFI_EVT_CONNECTED,       /* 连接成功，携带 IP */
    WIFI_EVT_DISCONNECTED,    /* 连接断开 */
    WIFI_EVT_RECONNECTING,    /* 开始自动重连 */
    WIFI_EVT_IP_CHANGED,      /* IP 变化，本模块已自动重建组播通道 */
} wifi_event_id_t;

typedef struct {
    wifi_event_id_t id;
    char   ssid[33];
    char   ip[16];
    int8_t rssi;
} wifi_mgr_event_t;

typedef void (*wifi_event_cb_t)(const wifi_mgr_event_t *evt, void *user_ctx);

/* 配置 */
typedef struct {
    uint32_t connect_timeout_ms;     /* 单次连接超时，默认 10000 */
    uint32_t reconnect_interval_ms;  /* 重连间隔，默认 3000 */
    uint32_t max_retries;            /* 连续失败次数，0 = 无限重连 */
} wifi_manager_cfg_t;

/* 生命周期；start 时从 node_role 读取凭据并连接 */
wifi_manager_handle_t wifi_manager_create(const wifi_manager_cfg_t *cfg);
void                  wifi_manager_destroy(wifi_manager_handle_t h);
esp_err_t wifi_manager_start(wifi_manager_handle_t h);
esp_err_t wifi_manager_stop(wifi_manager_handle_t h);

/* 配网（config 已存 node_role，当前无 UI 入口）：仅用新凭据立即发起连接（持久化由 node_role 负责） */
esp_err_t wifi_manager_set_sta(wifi_manager_handle_t h,
                               const char *ssid, const char *password);

/* 事件订阅（业务模块可选注册） */
esp_err_t wifi_manager_register_event_cb(wifi_manager_handle_t h,
                                         wifi_event_cb_t cb, void *user_ctx);

/* 状态查询（UI 图标 / OTA 用） */
esp_err_t wifi_manager_get_state(wifi_manager_handle_t h, wifi_state_t *state);
bool      wifi_manager_is_connected(wifi_manager_handle_t h);
esp_err_t wifi_manager_get_ip(wifi_manager_handle_t h, char *ip, size_t *len);
int8_t    wifi_manager_get_rssi(wifi_manager_handle_t h);

/* 通道：UDP socket 统一由本模块持有（音频数据单播 / 控制组播 / 灯控共用） */
typedef struct wifi_mcast_s *wifi_mcast_handle_t;

typedef struct {
    const char *group;          /* 组播组，如 239.0.0.1（音频与音频控制）/ 239.0.0.2（灯控） */
    uint16_t    port;           /* 绑定端口，音频单播 5680、音频控制 5679、灯控 8889 */
    bool        rx_enable;      /* 需要接收：模块内开 RX 任务 + FIFO */
    uint32_t    rx_fifo_bytes;  /* 接收 FIFO，默认 16384 */
} wifi_mcast_cfg_t;

esp_err_t wifi_manager_mcast_open(wifi_manager_handle_t h,
                                  const wifi_mcast_cfg_t *cfg,
                                  wifi_mcast_handle_t *out);
esp_err_t wifi_manager_mcast_send(wifi_mcast_handle_t ch,
                                  const void *data, size_t len,
                                  uint32_t timeout_ms);
esp_err_t wifi_manager_mcast_recv(wifi_mcast_handle_t ch, /* 从 FIFO 阻塞取 */
                                  void *buf, size_t cap, size_t *len,
                                  uint32_t timeout_ms);
esp_err_t wifi_manager_mcast_close(wifi_mcast_handle_t ch);
```

- **备注**：UI 图标采用 `wifi_manager_get_state()` 查询刷新；如需实时推送，可后续把事件回调扩展为多订阅者。OTA 的 HTTP/TCP 下载由 `ota_manager` 自行管理（不经组播），仅通过 `wifi_manager_is_connected()` 判断 WiFi 是否就绪；NVS 持久化统一由 `node_role` 负责，wifi_manager 不直接写 NVS。

#### 3.4.3 `node_role`

- **实现状态**：已实现（`components/msystem/node_role/node_role.h`；接口含 §3.4.3 全部函数 + 存储设计补充的 `version`/`play_mode` 字段，布局见《nvs存储.md》）。
- **职责**：
  - NVS 持久化唯一入口：节点角色（主/从）与运行参数（WiFi 凭证、音频采样率（固定 44.1kHz）、音量、同步延迟、组播地址、OTA 服务器地址）；
  - 全局唯一实例，内存缓存一份配置，读走缓存；只做持久化读写，不触发业务动作；
  - 主/从节点共用；首次开机无数据时使用 defaults 落盘。
- **对外接口**：

```c
/* 节点角色 */
typedef enum {
    NODE_ROLE_MASTER = 0,
    NODE_ROLE_SLAVE,
} node_role_t;

/* 运行参数（整体式读写，字段顺序与《nvs存储.md》1.2 节一致） */
typedef struct {
    uint16_t     version;               /* 版本结构版本号，当前 1（字段变更时递增） */
    uint8_t      role;                  /* 节点角色：0=主（NODE_ROLE_MASTER），1=从（NODE_ROLE_SLAVE） */
    char         wifi_ssid[32];         /* WiFi 名（当前无配网 UI，由 defaults 写入） */
    char         wifi_password[64];     /* WiFi 密码 */
    char         ota_server_url[256];   /* OTA 服务器地址，默认 192.168.4.16:5000/ota/check */
    uint8_t      volume;                /* 音量 0-100，默认 80 */
    uint8_t      play_mode;             /* 播放模式：0 顺序、1 单曲循环 */
    uint32_t     sync_delay_ms;         /* 同步延迟 D，默认 200 */
    uint32_t     audio_sample_rate;     /* 音频采样率：固定 44100（全链路统一，保留字段） */
    char         multicast_group[16];   /* 通道组地址（控制组播），默认 239.0.0.1 */
} node_role_cfg_t;

/* 初始化：app_main 开机调用，首次按 defaults 写入 NVS */
esp_err_t node_role_init(const node_role_cfg_t *defaults);

/* 读：返回缓存副本（线程安全） */
esp_err_t node_role_get(node_role_cfg_t *out);

/* 写：更新缓存 + 写 NVS（整体原子提交） */
esp_err_t node_role_set(const node_role_cfg_t *cfg);

/* 便捷查询 */
node_role_t node_role_get_role(void);
bool        node_role_is_master(void);
```

- **备注**：音频端口（5680 单播 / 5679 控制）、灯控端口（8889）等作为代码常量，不入 NVS；WiFi 凭据持久化统走本模块（如 `wifi_manager_set_sta()` 不写 NVS）；OTA 服务器地址经本模块持久化（存储按《nvs存储.md》：命名空间 `node_role`、Key `cfg` 单 blob，不单独建 `ota_server_url` 键），`ota_manager` 初始化按 `cfg->check_url → node_role 配置 → 默认宏` 优先读取。

#### 3.4.4 `ota_manager`

- **实现状态**：已实现（`OTA_Update.h` / `OTA_Update.c`，位于 `components/msystem/ota_manager/`）。

- **职责**：
  - 局域网 Pull-style OTA：GET `/ota/check` 获取元数据 `{version, sha256, url}`，语义化比较版本号；
  - 发现新版本后经由 `esp_https_ota` 流式下载到备用分区，校验 SHA256 后切换启动分区并重启；
  - 通过事件回调通知上层下载进度/状态（如 `DOWNLOAD_STARTED` 时暂停高内存/高带宽任务），模块不依赖 WiFi / 音频 / AI 云具体模块。

- **对外接口**：

```c
/* 事件类型 */
typedef enum {
    OTA_UPDATE_EVT_CHECK_STARTED = 0,   /* 开始检查远端版本 */
    OTA_UPDATE_EVT_UP_TO_DATE,          /* 已是最新版本 */
    OTA_UPDATE_EVT_UPDATE_AVAILABLE,    /* 发现新版本，准备下载 */
    OTA_UPDATE_EVT_DOWNLOAD_STARTED,    /* 开始下载固件 */
    OTA_UPDATE_EVT_DOWNLOAD_PROGRESS,   /* 下载进度变化 */
    OTA_UPDATE_EVT_DOWNLOAD_FINISHED,   /* 固件下载并校验完成 */
    OTA_UPDATE_EVT_READY_TO_REBOOT,     /* 即将重启进入新固件 */
    OTA_UPDATE_EVT_ABORTED,             /* 检测/下载失败或升级中止 */
} ota_update_event_t;

typedef struct {
    ota_update_event_t event;            /* 事件类型 */
    char version[OTA_VERSION_MAX_LEN];   /* 远端固件版本号 */
    char sha256[OTA_SHA256_MAX_LEN];     /* 远端固件 SHA256 */
    char url[OTA_URL_MAX_LEN];           /* 远端固件下载 URL */
    int  progress_percent;               /* 下载进度 0~100；其他事件为 -1 */
    int  http_status;                    /* HTTP 状态码；非 HTTP 阶段为 0 */
} ota_update_event_info_t;

typedef void (*ota_update_event_cb_t)(const ota_update_event_info_t *info, void *user_ctx);

/* 初始化配置；cfg 可传 NULL 使用默认值 */
typedef struct {
    const char *check_url;            /* /ota/check URL；NULL 时依次取 `node_role` 配置、默认宏 `OTA_SERVER_CHECK_URL` */
    const char *local_version;         /* 本地版本号；NULL 自动读取当前运行固件版本 */
    uint32_t check_timeout_ms;         /* 检测超时；0 用默认 5000 */
    uint32_t download_timeout_ms;      /* 下载超时；0 用默认 60000 */
    ota_update_event_cb_t event_cb;    /* 事件回调，可为 NULL */
    void *event_user_ctx;              /* 回调用户上下文 */
} ota_update_config_t;

/* 生命周期 */
esp_err_t OTA_Update_Init(const ota_update_config_t *cfg);
esp_err_t OTA_Update_Start(void);                  /* 后台周期性检测+升级 */
esp_err_t OTA_Update_CheckAndUpgrade(void);        /* 一次性阻塞检测+升级 */
esp_err_t OTA_Update_RegisterEventCallback(ota_update_event_cb_t cb, void *user_ctx);

/* 回滚确认：新固件首次启动确认正常后调用 */
esp_err_t OTA_Update_MarkAppValid(void);

/* 查询 */
const char *OTA_Update_GetLocalVersion(void);
const char *OTA_Update_GetRemoteVersion(void);
bool        OTA_Update_IsBusy(void);
```

- **备注**：
  - `check_url` 解析优先级：`cfg->check_url` 若为空 → `node_role_get()` 读取的 `ota_server_url`（由 `node_role` 持久化，整体 blob 不单独建键）→ 默认宏 `OTA_SERVER_CHECK_URL`；因此 `OTA_Update_Init(NULL)` / `OTA_Update_Start()` 隐式初始化时也能经 `node_role` 配置读到服务器地址；
  - 需在 WiFi 就绪后调用（可用 `wifi_manager_is_connected()` 判断）；模块只走 HTTP（TCP），不走组播；
  - `OTA_Update_CheckAndUpgrade()` 阻塞期间会自动创建独立任务执行，避免调用方小栈任务栈溢出。

------

## 4. 关键数据流

### 一、手机音乐下行（A2DP）——主链路

```
手机 → A2DP(SBC) 
  ↓ [蓝牙空中，协议栈接管]
ESP-IDF 蓝牙协议栈（SBC 自动解码成 16bit PCM）
  ↓ [协议栈回调，中断/协议栈上下文]
bt_audio 模块
  ↓ [内部 FIFO + 自身任务]
on_pcm 回调 → sync_protocol → 单播(逐台从节点，UDP 5680) + 本地延迟 → amplifier → i2s_driver → 喇叭
```

逐节点职责：

- bt_audio

  ：封装蓝牙协议栈的"壳"。只做三件事：

  - 收：协议栈回调里不直接调外部回调，先把 PCM 放进 `a2dp_fifo_bytes` 的 FIFO，再由 bt_audio 自身任务取出、按需触发 `on_pcm`（避免在蓝牙回调上下文做重活）；
  - 发：收集手机的 AVRCP 状态/歌曲信息/音量变化，向外发 `on_event`；
  - 控：`bt_audio_send_ctrl_cmd()` 把 UI 命令转 AVRCP 发回手机。
  - **不干**：不解码（esp-id 做）、不决定谁播放、不合并音源。

1. **App 接线层**（app_main 初始化处）：`bt_audio_cfg.on_pcm` 被接到转发函数，把回调转调 `sync_protocol_master_push_pcm()`。**注意：只做"接线"，不做任何格式判断**——源是 A2DP 还是 HFP 由 `source` 枚举区分，决定走哪个 stream。

2. **sync_protocol**：汇聚 + 同步。它不关心音源是谁（蓝牙/SD/HFP），只认 

   ```
   stream_id + sample_rate + channels
   ```

   。收到 PCM →

   - 打上基准播放时刻 `t_play_us = t_tx + D` → 立即打包经 `wifi_manager` 音频通道逐台单播（从节点 UDP 5680）；
   - 同时把同一包放进本地**延迟队列**，等到 `t_play_us + 60ms`（`SYNC_RX_MARGIN_US`，与从节点同一公式）才经 `Amplifier_Play_Buffer()` 写 I2S，保证主从同拍。
   - **不：** 不持有 socket（wifi_manager 管）、不写 I2S 之外的东西、不做格式转换。

3. **amplifier（TX）**：持有 I2S TX 句柄，内部写锁保证同一时刻只允许一路写入，把 PCM 写到对应 I2S 端口的 DMA buffer（原 audio_bus 的 TX 职责并入本模块）。

4. **amplifier**：NS4168 输出链路 + 软件音量。NS4168 无硬件音量接口，音量只在软件侧保存/应用（写 PCM 时乘以系数）；PCM 经 `Amplifier_Play_Buffer()` 在内部写锁下落到 I2S。

5. **i2s_driver**：BSP 层，真正把 PCM 转 DMA/I²S 信号给功放。

------

### 二、SD 卡本地播放

```
SD 卡文件 → sd_card(FATFS 读) → audio_decoder 解码任务
  → on_pcm 回调 → sync_protocol_master_push_pcm()（同一条链路）
    → 单播 + 本地延迟 → amplifier → i2s_driver → 喇叭
```

职责分工（重点：**audio_decoder 极端摆烂**）：

- **audio_decoder**：只做两件事。①对 MP3 流式解码；②把解码出的 PCM 通过 `on_pcm` 回调丢出去。它**没有 play/pause 决策权**——`audio_decoder_play/pause/stop` 只是内部解码任务的启停，真正的"接下来放哪首、单曲循环还是顺序"由 **MusicPlay** 决定。

- MusicPlay

  ：播放状态机的主人。它接收 UI/蓝牙/解码三类事件，统一进内部事件队列串行处理：

  - 当上游（audio_decoder）来消息时：`AUDIO_DECODER_EVT_EOF` 由它决定下一首（顺序→自动切下一条；循环→重播当前曲），然后调用 `audio_decoder_play(下一个文件)`；
  - 广播同步命令 `sync_protocol_master_broadcast_cmd(SYNC_CMD_NEXT)`，让从节点也切曲。

- **同一个 push_pcm() 汇聚点**：本地与蓝牙都是直接 `push_pcm`，sync_protocol 不管来源。

> **启动顺序**：SD 卡挂载、蓝牙建链、列表扫描都在 UI 之前完成（UI 页面要用列表与播放状态），
> 但**第一首不在那时起播**；等 UI 首帧刷完、App 调 `music_play_set_autoplay(true)` 放行后才 open/解码，
> 因此开机观感是「屏幕先亮，音乐随后响」。

------

### 三、HFP 语音应答下行（手机→喇叭）

- **已下线**：语音唤醒 / 麦克风链路整体移出构建后，`bt_audio` 内的 HFP 代码保留但无调用者，不会建立 SCO，本数据流当前不生效。

------

### 四、麦克风上行（本地唤醒词 → 手机语音助手）

- **已下线**：`microphone`（INMP441）与 `CallPhone`（esp-sr 唤醒）均已移入 `Play_Master/legacy_disabled`，`sdkconfig` 已删除 esp-sr，本数据流当前不生效。

------

### 五、UI 资源加载（图片：Flash storage → 屏幕；字体：编译进固件）

```
UI 图片：spiffs_create_partition_image 生成的 storage 分区镜像（storage/ui_img/ 3 张 PNG，随固件烧录）
  → esp_vfs_spiffs_register 挂载 /storage
  → LVGL 文件系统盘符 'F'（VFS stdio 适配）
  → UI_Task（LVGL 渲染线程）按需解码 → LCD_Touch 显示（ILI9341）

字体/图标：lv_font_conv 生成 C 数组（ui_font_cn_16 / ui_icons_16 / ui_icons_24）编译进 app 固件，
           运行时直接引用 const lv_font_t，无文件系统 IO。
```

1. **依赖**：UI 依赖 Flash `storage`（spiffs）分区读取 3 张 PNG 图片；字体/图标编译进固件，二者都不依赖 `sd_card`；
2. **不进音频链路**：图片/字体加载是低频应用数据，只进 LVGL 图像缓存，不经过音频中间件与 `sync_protocol`；
3. **容错**：`storage` 分区未挂载（镜像未烧录/损坏）时，UI 图片用内置字形/占位色块降级，字体/图标不受影响，界面照常可用；
4. **初始化顺序**：`ui_hw_bringup()` 内 `esp_vfs_spiffs_register()` 挂载 `/storage` 成功后才允许加载图片（失败置降级标志，不阻塞 UI）。

------

### 六、控制 / 命令流（不流经音频 LINE）

#### 6.1 源选择 vs 播放执行（同一模块内的两条职责）

| | **源选择（MusicPlay 内部策略）** | **播放执行（MusicPlay 状态机）** |
| --- | --- | --- |
| 职责 | 决定「切什么源」：蓝牙/本地 | 执行「怎么切、切完怎么播」：播放/暂停/上下曲/音量/列表 |
| 如何换源 | 内部轮询 `bt_audio_get_a2dp_info()` 判断连接状态 → 自动规则  | 收到切换请求 → 停旧流/起新流（同一个 `MusicPlay_Task` 串行） |
| 自动规则 | 蓝牙优先级最高：连接→BT；断开→LOCAL（SD 继续放） | 不在乎源规则，只执行切换 |
| 手动入口 | `music_play_set_source()`（UI）；自动规则下次轮询校正 | — |
| 给 UI | `music_event_cb_t` 的 `MUSIC_EVT_SOURCE_CHANGED` | `music_event_cb_t`（播放状态/曲目/音量快照） |
| 谁有最终话语权  | 输出"期望源" | 状态的最终刷新以接收到的 `bt_audio`/解码事件为准 |

一句话结论：**源选择（自动/手动）与播放执行都在 MusicPlay 内，由同一个 `MusicPlay_Task` 串行处理；「切什么源」按蓝牙优先自动规则，「怎么切、切完之后怎么播」由状态机执行。** 原独立 `PlayMode` 模块已并入，消除了两份 source 状态不一致的问题。

#### 6.2 UI 控制手机（AVRCP）

```
UI 触摸 → music_play_command()（统一命令口）→ MusicPlay 状态机
   ├─ BT：→ bt_audio_send_ctrl_cmd(PLAY/PAUSE/NEXT/PREV/VOL) → AVRCP → 手机
   │      → 手机回流 BT_AUDIO_EVT_PLAY_STATE_CHANGED → 状态机采信/刷新
   └─ 同时：→ sync_protocol_master_broadcast_cmd(SYNC_CMD_*) → 从节点
```

边界：**UI 不得直接调 bt_audio**；必须经由 MusicPlay（文档边界：App 层依赖中间件完成硬件操作；蓝牙控制最终只能经过 bt_audio 的 API，但 UI 只能到 MusicPlay 这一层）。

- 手机与 UI "同时按键" 的处理：**指令都是"期望"**，进入 MusicPlay 事件队列串行执行，最终状态以 bt_audio 回流事件为准（本地源则以解码器状态为准）。
- MusicPlay 再把它需要静音的同步命令（播放/暂停/上下曲/音量/重置）广播给从节点。

------

### 七、系统服务流（不经过音频区域到）

#### 7.1 灯控

```
UI 点击 → light_control_send(cmd, light) → JSON 组包
   → wifi_manager_mcast_send(239.0.0.2:8889)（rx=true 已开）
   → ESP8266 → ack JSON → wifi_manager_mcast_recv(FIFO) → LightControl 解析
   → light_control on_event(ACK/ERROR) → UI 软件刷新图标

   ─── 周期状态上报（灯控每 30s 上行）───
   ESP8266 → status JSON → wifi_manager_mcast_recv(FIFO) → LightControl 解析
   → light_control on_event(STATUS) → UI 软件刷新图标
```

边界：LightControl **不持有 socket**，socket 全在 wifi_manager；它是纯粹的"协议编解码 + 状态解析"模块，灯状态以 `ack`/`status` 上报实际值为准，不再做下发推断。

#### 7.2 WiFi / 配对 / 状态

```
开机：wifi_manager_start() → 从 node_role 读 SSID/密码 → 发起连接（当前无配网 UI）
后续查询：UI 图标 → wifi_manager_get_state()/is_connected()（轮询，不绑事件）
```

- node_role 是唯一 NVS 写者；wifi_manager 只拿 NVS 凭据，不自己写。

#### 7.3 OTA

```
app 就绪 → OTA_Update_Init(NULL) ← 内部按 cfg→node_role 配置（ota_server_url）→默认宏兜底
 → OTA_Update_Start() 后台 或 CheckAndUpgrade() 阻塞
 → HTTP 直连服务器（不经组播/wifi socket）
 → 下载写入备用分区 → 校验 SHA256 → 切换重启
 → 过程经 on_event 回调（进度/失败）给 main / UI
```

- OTA 只依赖 `wifi_manager_is_connected()` 判断网络，不占用 `sync_protocol` 与 `audion 路由`。

#### 7.4 从节点（广播侧）

```
接收：从节点 wifi_manager RX（UDP 5680 单播）→ 从节点 sync_protocol(裁剪版) → 延迟队列
 → offset = d_min + lead_ms×1000 + 60ms → t_play_local = t_play_us + offset → 从节点 amplifier → i2s → 喇叭
```

- 主节点 role：唯一发流，从节点只跟随。主/从角色由 node_role 存 NVS 决定。

------

### 八、职责钳表（速查）

| 模块 | 数据流中“干的事” | “绝不干” |
| --- | --- | --- |
| bt_audio | 封装蓝牙栈；A2DP/AVRCP（HFP 代码保留，无调用者）；FIFO 输出 PCM= 事件 | 不决定播放、不解码、不跨网络、App 不得碰 ESP-IDF BT API |
| audio_decoder | 只解码 SD 文件 → on_pcm/事件 | 不持有控制、不快速造 stream、不做 seek |
| MusicPlay | 源选择（自动/手动，原 PlayMode）+ 播放状态机：命令执行、队列串行、列表/音量、给 sync 广播 | 不碰音频数据、不直接调 ESP-IDF BT API |
| sync_protocol | 汇聚 PCM + 时间戳 + 逐台单播 + 本地延迟播放 | 无源/无格式概念，不持 socket（wifi_manager 管） |
| amplifier | 功放输出 + 内部写锁（同一时刻只允许一路写 I2S）+ 软件音量 | 无音量硬件外部接口 |
| wifi_manager | 连接/重连/IP + 统一持有组播 socket | 不写 NVS |
| LightControl | 灯协议编解码 + ack/status 上行实际状态 | 不持 socket（复用 wifi_manager 通道） |
| node_role | NVS 唯一入口、配置缓存 | 不做业务动作 |
| The rest（ESP-IDF） | SBC 解码、I2S DMA、网络栈 | —— |

------

## 5. 同步播放架构说明

同步播放的本质：**主节点发一个包时，约定这个包在未来的 t_tx + D 时刻播放；主节点自己也要等到这个时刻才播。**

- `sync_protocol` 是所有音源 PCM 的汇聚点。

- 主节点本地播放不是立即的，而是延迟 `D` 再加 60ms 抖动余量（`SYNC_RX_MARGIN_US`；`D` 默认 200ms）。

- 从节点用"最小单程延迟"单向估计时钟偏移（PING/PONG 保留，但不参与音频同步），然后计算：

  ```text
d(i)   = 本地收到时刻 − t_play_us（接收窗口内取最小值 d_min）
offset = d_min + lead_ms×1000 + 60ms
t_play_local = t_play_us + offset
  ```

- 这样主从都在同一基准时刻出声（双方加相同的 60ms 余量），音频同步不需要从节点回包。

- 长期漂移用丢/插单个样点（sample slip）补偿，不改 I2S 采样率。

**音频链路的关系**：

- 同步模式下，`sync_protocol` 是 I2S TX 的唯一 PCM 数据源（经 `Amplifier_Play_Buffer()` 落 I2S）。
- 麦克风上行链路已整体下线：`microphone`（INMP441）与 `CallPhone`（esp-sr 唤醒）已移入 `legacy_disabled`，不经 `amplifier` TX；`bt_audio` 内的 HFP 代码保留但无调用者，不会建立 SCO。

------

## 6. FreeRTOS 任务设计（主节点）

> **任务视图说明**：任务表为**实现视图**——App 层任务与 middlewares / msystem 模块内部自建的常驻任务全部登记（见“所属”列），优先级、栈、核绑定全局统一仲裁；模块内部任务由模块自身 `create/start` 创建，App 层不感知创建细节。

> **核分配原则**：Core 0 (PRO_CPU) 承担协议与系统核心——Wi-Fi、蓝牙协议栈、TCP/IP 栈（lwIP）以及高精度定时器等系统关键任务默认固定在其上运行；Core 1 (APP_CPU) 是实时音频核心，**写 I2S、解码、蓝牙 PCM 出队这些有硬时限的任务放 Core 1**，与网络/蓝牙协议栈解耦，保证执行确定性。
>
> UI 是例外：LVGL 刷一整屏（320×240×2B @10MHz SPI）要连续占用所在核约 123ms，若放 Core 1 会直接造成 I2S 欠载，所以 `UI_Task`/`Touch_Task` 放 Core 0，并把优先级压到 10（低于 `SyncTx_Task` 的 11），让同核的发包节拍优先。

| 任务名 | 所属 | 优先级 | 栈大小  | 核 | 功能 |
| :--- | :--- | :----- | :--- | :--- | :--- |
| `SyncLocalPlay_Task` | middlewares: `sync_protocol` | 12 | 4096 | **Core 1** | 本地延迟队列取 PCM，按 `t_play_us + 60ms` 写 I2S；喂 I2S 的消费端，优先级最高 |
| `SyncTx_Task` | middlewares: `sync_protocol` | 11 | 4096 | **Core 0** | 打时间戳、UDP 逐台单播发送 |
| `bt_audio_task` | middlewares: `bt_audio` | 11 | 4096 | **Core 1** | 蓝牙事件 FIFO 出队，触发 `on_event`/`on_pcm`（协议栈回调不入用户回调） |
| `UI_Task` | App: UI | 10 | 32768 | **Core 0** | LVGL 界面交互与显示；图片从 Flash `/storage` 按需加载 |
| `audio_decoder` 解码任务 | middlewares: `audio_decoder` | 10 | 4096 | **Core 1** | SD 卡 MP3 流式解码→ `on_pcm`→`push_pcm()`；解码任务在模块内部 |
| `MusicPlay_Task` | App: MusicPlay | 9 | 4096 | **Core 1** | SD 选曲/播放控制/状态机 + 自动源选择（原 PlayMode，轮询 A2DP）；不承载解码（在 audio_decoder 内部） |
| `wifi_mcast_rx` | msystem: `wifi_manager` | 6 | 6144 | **Core 0** | 组播收包→FIFO（rx 启用的通道，如灯控通道 ack/status） |
| `SmartHome_Task` | App: LightControl | 5 | 4096 | **Core 0** | 处理 UI 灯控指令 UDP 组播发送；解析 ack / 30s status 上报并触发事件回调 |
| `ota_update` / `ota_sync` | msystem: `ota_manager` | 5 | 12288 | **Core 0** | 动态创建，执行固件下载/升级，完成后自销毁 |
| `Touch_Task` | middlewares: LCD_Touch | 3 | 2048 | **Core 0** | 触摸 IC（FT6336G）扫描，由模块内部创建 |
| `app_hb` | App: `app_main` 心跳 | 2 | 3072 | **Core 0** | 卡死定位心跳，不参与启动时序，创建失败仅少一份诊断 |

**核分配理由**（按“网络/协议侧→Core 0，实时/应用侧→Core 1”）：
- **网络/协议侧（Core 0）**：`SyncTx_Task`（UDP 单播依赖 lwIP）、`ota_update`/`ota_sync`（网络下载）、`SmartHome_Task`、`wifi_mcast_rx`（组播收包）、`app_hb`（心跳）放 Core 0，与 lwIP/蓝牙同核，减少跨核开销；
- **实时音频侧（Core 1）**：`SyncLocalPlay_Task`（写 I2S）、`audio_decoder` 解码任务、`bt_audio_task`（PCM 出队回调）、`MusicPlay_Task`（播放状态机）放 Core 1，与网络协议栈分核，隔离网络抖动；
- **交互（Core 0）**：`UI_Task` / `Touch_Task` 放 Core 0。LVGL 刷一整屏（320×240×2B @10MHz SPI）约 123ms，会连续占住所在核；若与 `SyncLocalPlay_Task` 同核，会直接造成 I2S 欠载。代价是会推后同核的 `SyncTx_Task`，所以 `UI_Task` 优先级定在 10（低于 `SyncTx_Task` 的 11），让发包节拍优先；
- **任务归属变化说明**：原“`AudioSource_Task`”（逻辑上汇总蓝牙/SD 音频源）**不再作为独立任务**——A2DP PCM 由 `bt_audio_task` 出队回调、SD 解码由 `audio_decoder` 解码任务产出，二者均在中间件内部直接回调 `sync_protocol`；原“`LocalPlay_Task`”更名为 `MusicPlay_Task`，只做选曲/控制/模式状态机；启动期另有一次性引导任务（`mp_boot`、`lc_boot`）和 UI 引导任务，跑完即退出，不登记为常驻任务。

> **实现约定**：所有任务统一用 `xTaskCreatePinnedToCore()` 创建，按上表绑定核（`Core 0`=0，`Core 1`=1）；模块内部任务由各模块 `create/start` 自建；`ota_update` / `ota_sync` 动态创建时同样按表绑定。

> 任务间通信：中控之间用事件组/命令队列传递状态与控制；PCM 数据经 `audio_decoder`/`bt_cb` 的文件级回调进入 `sync_protocol`，再经各 FIFO/Jitter Buffer 传递，不走核间消息队列。
## 7. 依赖组件（idf_component.yml）

```yaml
dependencies:
  lvgl/lvgl: "^9"
  espressif/cjson: "^1.7.19"    #这个因为esp-idf6.x版本以上没有内置json组件了，需要外部添加
  espressif/freetype: "^2.14.3" # LVGL 9 的运行时 TTF 渲染后端（ui_font.c 用 lv_freetype_font_create）
  # espressif/esp-sr 已移除（2026-10-25）：语音唤醒/麦克风整条链路下线，见 legacy_disabled/README.md
```

------

## 8. 关键 menuconfig 配置

```bash
# WiFi 与组播
CONFIG_LWIP_IPV4=y
CONFIG_LWIP_MULTICAST=y
CONFIG_LWIP_IGMP=y

# OTA
CONFIG_ESP_OTA=y
CONFIG_BOOTLOADER_APP_ROLLBACK_ENABLE=y

# FATFS 长文件名
CONFIG_FATFS_LONG_FILENAMES=y

# 蓝牙（仅主节点）
CONFIG_BT_ENABLED=y
CONFIG_BT_BLUEDROID_ENABLED=y
CONFIG_BT_CLASSIC_ENABLED=y
```
