currygood/MusicPlaySyncSpeakers/docs/02-设计/从音频节点软件架构分层设计.md

# 从音频节点软件架构分层设计

> **节点型号**：量产目标与主节点相同，为 ESP32-WROVER-E-N16R8；开发阶段暂用 ESP32-S3 开发板（如 ESP32-S3-N16R8）替代，`Play_Slave/sdkconfig` 里的 `CONFIG_IDF_TARGET="esp32s3"` 即为此开发态。
> **文档范围**：仅描述**音频从节点**的软件架构；主节点（ESP32-WROVER-E）固件另行设计。
> **核心原则**：从节点仅工作于**同步模式**，接收主节点 UDP **单播** PCM，按包头 `t_play_us` 对齐出声、用丢/插单个样点补偿晶振漂移，实现与主节点几乎无感知的同步播放。从节点**无经典蓝牙、无触摸屏、无 SD 卡、无麦克风**，仅保留 I2S 功放输出。

------

## 1. 节点概述

从节点是低成本同步播放终端，硬件上仅使用：

- ESP32-WROVER-E-N16R8（量产目标，16MB Flash + 8MB PSRAM）；开发阶段改用现成的 ESP32-S3 开发板（如 ESP32-S3-N16R8，同为 16MB Flash + 8MB PSRAM）
- NS4168 I2S 功放 + 4Ω 3W 喇叭
- 状态灯（GPIO15）
- 电源

从节点**不包含**：

- 经典蓝牙：固件不含 A2DP，不接蓝牙音频（开发阶段的 ESP32-S3 本身也不支持 BR/EDR）
- 触摸屏 / LCD
- SD 卡
- 麦克风
- 灯控相关硬件

从节点软件职责：

1. 连接同一 WiFi 路由器；音频在 UDP `5680` 上 `bind(INADDR_ANY)` 单向接收（**不加入任何组播组、不做 `IP_ADD_MEMBERSHIP`**）。
2. 接收主节点**单播**发来的 PCM 音频帧（20 字节包头 + PCM，44.1kHz/16bit/单声道，默认 15ms 一帧、661/662 样点交替）。
3. 用 `d(i) = 本地收到时刻 − t_play_us` 的窗口最小值单向估计时钟偏移（从节点不回包，不需要 PING/PONG）。
4. 按 `seq` 将 PCM 帧放入环形抖动槽位（吸收乱序与抖动）。
5. 在本地时间 `t_play_us + offset`（`offset = d_min + lead_ms×1000 + 60ms`）时刻，通过 I2S 输出至功放。
6. 以抖动缓冲水位为观测量，用丢/插单个样点（sample slip）补偿晶振漂移，**不改 I2S 采样率**。
7. 处理异常：丢包、网络中断、主节点重启等。
8. OTA 升级：**未实现**（仅分区表预留 `ota_0` / `ota_1` 槽位）。

------

## 2. 设计原则

1. **极简分层**：仅保留必要模块，降低 Flash / RAM 占用与 BOM 成本。
2. **同步优先**：所有音频数据流围绕 `udp_audio` 设计，无本地音源（原 `sync_protocol` 已从从节点工程删除）。
3. **无蓝牙依赖**：不编译任何经典蓝牙 / A2DP / HFP 组件。
4. **无文件系统**：不挂载 SD 卡，不使用 FATFS，不包含 `audio_decoder`。
6. **I2S 唯一写者**：从节点只有 `udp_audio` 向 I2S TX 写数据，无需复杂仲裁。

------

## 3. 分层架构总览

```reStructuredText
┌─────────────────────────────────────────────────────────────┐
│                        应用层 (App)                         │
│                     MusicPlay（同步播放引擎 + 状态LED）        │
│                     StatusLed（状态指示，可选）              │
└──────────────┬──────────────────────────────────────────────┘
               │ 调用中间件 API / 接收事件
┌──────────────▼──────────────────────────────────────────────┐
│                      中间件层 (middlewares)                  │
│     udp_audio         │     amplifier     │                  │
└──────────────┬──────────────────────────────────────────────┘
               │ 调用 BSP 驱动
┌──────────────▼──────────────────────────────────────────────┐
│                         BSP 层 (bsp)                        │
│          gpio_driver        │        i2s_driver             │
└──────────────┬──────────────────────────────────────────────┘
               │
┌──────────────▼──────────────────────────────────────────────┐
│                   硬件 (ESP32-S3 开发板)                    │
│          GPIO / I2S / WiFi / 功放 NS4168 / 喇叭             │
└─────────────────────────────────────────────────────────────┘

横切服务：mysystem（ota_manager / wifi_manager / node_role / StartAndStop）
```

------

## 4. 各层详细设计

### 4.1 BSP 层（board support package）

> 从节点无需 I²C、SPI、I2S RX。

#### 3.1.1 `gpio_driver`

- **实现状态**：已实现（`gpio_driver.h` / `gpio_driver.c`）。
- **职责**：封装 GPIO 模式配置、电平读写、翻转和中断处理。
- **对外接口**：

```c
esp_err_t Gpio_Init(gpio_num_t gpioNum, Gpio_Mode_t mode);
void Gpio_Set_Level(gpio_num_t gpioNum, uint8_t level);
uint8_t Gpio_Get_Level(gpio_num_t gpioNum);
void Gpio_Toggle(gpio_num_t gpioNum);
esp_err_t Gpio_Install_Isr_Service(int flags);
esp_err_t Gpio_Set_Intr_Type(gpio_num_t gpioNum, gpio_int_type_t intrType);
esp_err_t Gpio_Isr_Handler_Add(gpio_num_t gpioNum, gpio_isr_t isrHandler, void *args);
esp_err_t Gpio_Intr_Enable(gpio_num_t gpioNum);
```

#### 3.1.2 `i2s_driver`

- **实现状态**：已实现（`i2s_driver.h` / `i2s_driver.c`）。
- **职责**：创建单向 I2S TX/RX 物理总线，参数化引脚、采样格式、DMA 深度和采样率。
- **对外接口**：

```c
esp_err_t i2s_bus_phy_create(i2s_port_t port, bool is_tx,
                             const i2s_pin_cfg_t *pin_cfg,
                             const i2s_bus_cfg_t *bus_cfg,
                             i2s_bus_handle_t *out_handle);
esp_err_t i2s_bus_phy_write(i2s_bus_handle_t bus, const uint8_t *buffer,
                            size_t size, size_t *bytes_written, uint32_t timeout);
esp_err_t i2s_bus_phy_read(i2s_bus_handle_t bus, uint8_t *buffer,
                           size_t size, size_t *bytes_read, uint32_t timeout);
esp_err_t i2s_bus_phy_flush(i2s_bus_handle_t bus);
esp_err_t i2s_bus_phy_set_sample_rate(i2s_bus_handle_t bus, uint32_t sample_rate);
void i2s_bus_phy_debug_dma(i2s_bus_handle_t bus);
esp_err_t i2s_bus_phy_destroy(i2s_bus_handle_t bus);
```

> BSP 层只关心“如何操作硬件”，不包含音频业务、文件系统或应用策略。

### 4.2 中间件层（middlewares）

#### 4.2.1 amplifier

- **职责**：NS4168 I2S 功放驱动，将 PCM 输出至喇叭。
- **依赖**：`i2s_driver`（I2S TX 由 amplifier 内部持有）
- **对外接口**：

```c
/* ======================== 功放音频配置 =========================================== */

/** 音频采样率（Hz）：44.1kHz，与主节点全链路统一 */
#define AMPLIFIER_SAMPLE_RATE  44100

/** 音频位深度：16-bit，每个采样点 2 字节 */
#define AMPLIFIER_BIT_DEPTH    16

/** 音频通道数：1（单声道），语音播放不需要立体声 */
#define AMPLIFIER_CHANNEL_NUM  1

/* ======================== API 函数 =============================================== */

/**
 * @brief 初始化功放模块
 *
 * 初始化 I2S TX（I2S_NUM_1）接口，准备音频输出到 NS4168 功放芯片。
 * NS4168 是一款 5W 单声道 D 类功放芯片，通过 I2S 接口接收 PCM 音频数据。
 *
 * 注意：初始化后需要调用 Amplifier_Play_Buffer() 才能播放音频。
 *
 * @return ESP_OK  初始化成功
 *         ESP_FAIL I2S 接口初始化失败
 */
esp_err_t Amplifier_Init(void);

/**
 * @brief 反初始化功放模块
 *
 * 关闭 I2S TX 接口，释放 DMA 缓冲区等资源。
 *
 * @return ESP_OK 反初始化成功
 */
esp_err_t Amplifier_Deinit(void);

/**
 * @brief 通过功放播放 PCM 音频缓冲区
 *
 * 将 PCM 16-bit 单声道音频数据通过 I2S 总线发送到 NS4168 功放芯片，
 * 驱动扬声器发声。
 *
 * @param buffer        指向 PCM 音频数据的指针（16-bit 单声道，小端字节序）
 * @param size          缓冲区大小（字节）
 * @param bytes_written 输出参数，返回实际写入的字节数（可为 NULL）
 * @param timeout       超时时间（FreeRTOS tick 数），若 I2S DMA 缓冲区满则等待
 *
 * @return ESP_OK             播放成功
 *         ESP_ERR_INVALID_ARG buffer 为 NULL 或 size 为 0
 *         ESP_FAIL            I2S 写入失败
 */
esp_err_t Amplifier_Play_Buffer(const uint8_t *buffer, size_t size, size_t *bytes_written, uint32_t timeout);
```

- **备注**：从节点仅此一个音频输出设备。

#### 4.2.2 amplifier（原 audio_bus 已删除，TX 职责并入 4.2.1）

- **状态**：原独立 `audio_bus` 中间件已从代码中删除——从节点是单写者场景，无需独立仲裁层，TX 写锁直接并入 `amplifier`：
  - `Amplifier_Init()` 内部创建 I2S TX（I2S_NUM_1）并初始化写锁；
  - `Amplifier_Play_Buffer()` 在写锁内把 PCM 写入 I2S，`udp_audio` 是从节点唯一写者；
  - 采样率固定 `AMPLIFIER_SAMPLE_RATE = 44100`（与主节点全链路一致），无需动态重建接口。

- **对外接口**：同 4.2.1（`Amplifier_Init` / `Amplifier_Deinit` / `Amplifier_Play_Buffer` / `Amplifier_Set_Volume`）。

- **备注**：若未来从节点须扩展其他音源（如本地提示音），可在 `amplifier` 内复用主节点的写锁互斥逻辑。
#### 4.2.3 udp_audio（从节点音频接收与同步，取代原 sync_protocol）
- **实现状态**：已实现（`components/middlewares/udp_audio/udp_audio.h` / `udp_audio.c`）；从节点工程已删除 `sync_protocol`，该名字只在主节点保留（单播发送端）。
- **架构位置**：从节点唯一的音频汇入点——只负责**接收**主节点**单播**发来的 PCM 并按 `t_play_us` 对准出声，**不产生也不转发任何音源**：
  
  - 音频通道：UDP **5680 单播**（RX），`bind(INADDR_ANY)`，**不加入组播组、不做 `IP_ADD_MEMBERSHIP`**；包头 20 字节 `magic(u16,0xAA55) | version(u8,=2) | flags(u8,bit0=流首帧) | stream_id(u16) | seq(u16) | t_play_us(u64) | payload_len(u16) | lead_ms(u16)`，后接 44.1kHz/16bit/单声道 PCM（默认 15ms 一帧，661/662 样点交替）；
  - 控制通道（音量 / 公告）由 `ctl_rx` 单独处理（组播 `239.0.0.1:5679`，见 4.4 的 wifi_manager），本模块不持有它；
  - 本模块自建 5680 单播 socket（`ua_open_socket()`），不经 `wifi_manager_mcast_open()`；
  - 音频同步**不需要从节点回包**：`PING(0x20)` / `PONG(0x21)` 帧仍保留在控制通道定义里，但已不参与音频同步。
- **源无关（纯接收端）**：从节点没有蓝牙/SD/HFP，不感知音源业务，只认 `stream_id + 44.1kHz/16bit/单声道`（全链路固定采样率，见 4.2.1 amplifier）。
- **同步算法**：

  ```text
  时钟估计（单向，不需要 PING/PONG）
    d(i)   = 本地收到第 i 帧的时刻 − 该帧 t_play_us
    d_min  = 最近 64 帧窗口内 d(i) 的最小值
    offset = d_min + lead_ms × 1000 + UDIO_MARGIN_US(60000)
    出声时刻 = t_play_us + offset

  漂移补偿（sample slip，不改 I2S 采样率）
    观测量 = 抖动缓冲"跑道"（最近收到的 t_play − 正在播放帧的 t_play）
    开播 200 帧后把跑道均值定为基准
      跑道比基准长 4ms 以上 → 丢 1 个样点（加快）
      跑道比基准短 4ms 以上 → 插 1 个样点（放慢）
      最小间隔 20ms，拼接点做 8 点线性过渡
  ```

- **对外接口**：

```c
/* ======================== 线格式（与主节点逐字节一致） ============================ */
#define UDIO_MAGIC                  (0xAA55)
#define UDIO_VERSION                (2)
#define UDIO_DEFAULT_PORT           (5680)
#define UDIO_SAMPLE_RATE            (44100)
#define UDIO_CHANNELS               (1)
#define UDIO_BITS                   (16)

/** flags 位定义：bit0 = 本次流的首帧 */
#define UDIO_FLAG_STREAM_START      (0x01)

/** 帧头（packed，20 字节），`t_play_us` 落在 8 字节边界上 */
typedef struct __attribute__((packed)) {
    uint16_t magic;         /* 固定 UDIO_MAGIC */
    uint8_t  version;       /* 固定 UDIO_VERSION */
    uint8_t  flags;         /* UDIO_FLAG_* */
    uint16_t stream_id;     /* 一次音频流唯一标识 */
    uint16_t seq;           /* 包序号，0~65535 回绕 */
    uint64_t t_play_us;     /* 基准播放时刻（发送端时钟，µs） */
    uint16_t payload_len;   /* PCM 字节数（不含头） */
    uint16_t lead_ms;       /* 发送端提前量 D（ms） */
} udio_hdr_t;

/** 接收端抖动余量（µs）：抖动缓冲深度，主节点本地播放也加同一值 */
#define UDIO_MARGIN_US              (60000)

/* ======================== 对外接口 =============================================== */
esp_err_t udp_audio_start(uint16_t port);   /* 0 = UDIO_DEFAULT_PORT(5680)；内部起接收、播放两个任务 */
void      udp_audio_stop(void);             /* 停止接收任务并关闭 socket（调试用，正常流程不调用） */
```

- **收包链路**：`ua_rx_task` 在 5680 上 `recvfrom` → 校验 `magic` / `version` → 按 `seq % 64` 落环形槽位（重复包丢弃，已播过的迟到包丢弃）→ 更新 `d(i)` 窗口；`flags` 首帧或 `stream_id` 变化视为新流，清盘重新 preroll。
- **出声链路**：`ua_play_task` 攒够 preroll（有效帧 ≥ 8 且缓冲深度 ≥ `lead_ms` 的 3/4）后冻结 `offset`，等到 `t_play_us + offset` 起播，经 `Amplifier_Play_Buffer()`（amplifier 内部写锁）直接写 I2S，从节点 I2S 唯一写者；首帧做 128 点淡入，缺帧用上一帧 3/4 衰减的 PLC 补，断流 > 500ms 清盘重新 preroll，缓冲深于 450ms 跳到 150ms 位置。
- **无心跳链路**：从节点不收心跳、不做速率微调、也不回 PING；漂移完全由上面的 sample slip 补偿，丢包/欠载规则见第 6 章。
- **构件裁剪**：从节点为独立工程，`app_main` 直接串起 `StartAndStop / node_role / StatusLed / wifi_manager / amplifier / ctl_rx / udp_audio`；不存在 `CONFIG_NODE_ROLE_SLAVE` 这类角色裁剪宏，主节点的 `sync_protocol_master_*` 系列 API 不出现在从节点。

#### 4.2.4 无蓝牙、无解码、无文件系统

从节点**不包含**：

- `bt_audio`
- `audio_decoder`
- `sd_card`
- `LCD_Touch`
- `microphone`

------

### 4.3 应用层（App）

| 模块 | 职责 | 依赖中间件 |
| :--- | :--- | :--- |
| `MusicPlay` | **未实现**（`MusicPlay.c` 为空占位）；原规划：启动 / 停止 `udp_audio`，维护播放状态并按状态驱动 `StatusLed`，不接触 PCM 数据 | `udp_audio`、`amplifier` |
| `StatusLed` | 通过 GPIO 驱动 LED（GPIO15）；已实现 `StatusLed_Init()`，`On/Off` 当前无调用者 | `gpio_driver` |

> 从节点无 UI、无本地播放、无蓝牙、无灯控；PCM 数据**不经过** MusicPlay，由 `udp_audio` 经 `Amplifier_Play_Buffer()` 直接送入 `amplifier`。

#### 4.3.1 `MusicPlay`

- **实现状态**：未实现（占位）；`components/App/MusicPlay/MusicPlay.c` 目前只有一个 `#include "MusicPlay.h"`，`MusicPlay.h` 只有调试宏。下面为规划稿；原设计的 `sync_protocol_slave` 事件源已随从节点 `sync_protocol` 删除而不存在，`udp_audio` 也不对外抛事件，本模块当前没有事件来源。
- **职责**：
  - 同步播放控制：启动 / 停止 `udp_audio`，处理异常恢复（原“同步播放引擎”的职责保留在本模块）；
  - 播放状态机：订阅 `udp_audio` 的播放状态 / 命令事件，把主节点的 `SYNC_CMD_*` 翻译成本机状态（播放 / 暂停 / 停止）；该事件接口尚未实现；
  - LED 联动：状态为播放中 → `StatusLed_On()`，否则 → `StatusLed_Off()`；
  - 音量落地：收到 `SYNC_CMD_VOLUME` → 调用 `Amplifier_Set_Volume()`（当前已由 `ctl_rx` 直接落地）；
  - `NEXT` / `PREV` **直接忽略**（从节点不换曲）；
  - **不接触 PCM 数据**：音频由 `udp_audio` 直接经 `Amplifier_Play_Buffer()` 送到 `amplifier`，不经过本模块；音乐控制只作用于“状态面”。
- **数据流说明**：`WiFi → udp_audio ──Amplifier_Play_Buffer()──→ amplifier(内部写锁) → I2S → 喇叭`；`udp_audio ──(状态/命令事件)──→ MusicPlay`（事件接口尚未实现）。
- **对外接口**：

```c
/* ======================== 播放状态 =============================================== */
typedef enum {
    MUSIC_STATE_STOPPED = 0,   /* 未播放：初始 / 主节点停止 / 失联超时 */
    MUSIC_STATE_PLAYING,       /* 正在播放 */
    MUSIC_STATE_PAUSED,        /* 已暂停 */
} music_play_state_t;

/* 事件（可选订阅；从节点无 UI，主要给日志/调试用） */
typedef enum {
    MUSIC_EVT_STATE_CHANGED,   /* 播放状态变化 */
    MUSIC_EVT_VOLUME_CHANGED,  /* 音量变化（VOLUME 命令落地后） */
} music_event_id_t;

typedef struct {
    music_event_id_t  id;
    music_play_state_t state;  /* id == MUSIC_EVT_STATE_CHANGED 时有效 */
    uint8_t           volume;  /* id == MUSIC_EVT_VOLUME_CHANGED 时有效（0~100） */
} music_event_t;

typedef void (*music_event_cb_t)(const music_event_t *evt, void *user_ctx);

/* 配置 */
typedef struct {
    uint8_t          init_volume;   /* 初始音量（未收到 VOLUME 前），默认 80 */
    music_event_cb_t on_event;      /* 可选事件订阅，可 NULL */
    void            *event_ctx;
} music_play_cfg_t;

/* 生命周期（单例） */
esp_err_t music_play_init(const music_play_cfg_t *cfg);
esp_err_t music_play_deinit(void);

/* 启动 / 停止同步播放链路（内部调用 udp_audio_start / udp_audio_stop） */
esp_err_t music_play_start(void);
esp_err_t music_play_stop(void);

/* 内部事件入口：预留（udp_audio 当前没有事件回调可转接） */

/* 状态查询 */
music_play_state_t music_play_get_state(void);
uint8_t            music_play_get_volume(void);
```

- **StatusLed 联动规则**（规划；当前 `ctl_rx` 只把音量帧落地到 `Amplifier_Set_Volume()`，PAUSE / NEXT / PREV / SYNC_RESET 帧被直接忽略，所以下表在 `MusicPlay` 落地前不会发生）：

| 事件 / 状态 | MusicPlay 状态 | 动作 |
| --- | --- | --- |
| `SYNC_EVT_STATE_CHANGED` = PLAYING / 恢复 | `PLAYING` | `StatusLed_On()` |
| `SYNC_EVT_CMD_RECEIVED` = PAUSE | `PAUSED` | `StatusLed_Off()` |
| `SYNC_EVT_MASTER_LOST` / `SYNC_STOP` | `STOPPED` | `StatusLed_Off()` |
| `SYNC_EVT_CMD_RECEIVED` = SYNC_RESET | `STOPPED`（等待首包） | `StatusLed_Off()` |
| `SYNC_EVT_CMD_RECEIVED` = VOLUME | 状态不变 | `Amplifier_Set_Volume(param)` |
| `SYNC_EVT_CMD_RECEIVED` = NEXT / PREV | 状态不变 | 忽略，不换曲 |

#### 4.3.2 `StatusLed`

- **实现状态**：已实现（`components/App/StatusLed/StatusLed.h` / `StatusLed.c`）；当前全工程只有 `StatusLed_Init()` 被调用（`app_main` 第 4 步），`StatusLed_On()` / `StatusLed_Off()` 没有任何调用者——原本应由 `MusicPlay` 调用，而 `MusicPlay.c` 是空的。
- **职责**：驱动状态 LED（GPIO15，高电平亮）；由 `MusicPlay` 按播放状态调用，不建独立任务。
- **对外接口**：

```c
/**
 * @file StatusLed.h
 * @brief 状态 LED 模块接口
 *
 * 核心功能：让 MusicPlay 调用，如果正在播放音乐，点亮 LED，否则熄灭 LED
 *
 * @note LED 为高电平有效，高电平亮，低电平熄灭
 */
#ifndef __STATUS_LED_H__
#define __STATUS_LED_H__

#include "esp_err.h"
#include "gpio_driver.h"

#define STATUS_LED_GPIO 15

#define STATUS_LED_ON  1
#define STATUS_LED_OFF 0

esp_err_t StatusLed_Init(void);   /* 初始化（GPIO15 输出） */
esp_err_t StatusLed_On(void);     /* 点亮 LED */
esp_err_t StatusLed_Off(void);    /* 熄灭 LED */

#endif
```

------

### 4.4 系统服务层（mysystem）

| 模块 | 职责 |
| :--- | :--- |
| `StartAndStop` | 初始化电源保持输出，检测电源键长按并执行关机 |
| `ota_manager`  | 双备份 OTA 升级、回滚（ESP32-S3 16MB Flash，可放大 ota 分区） |
| `wifi_manager` | WiFi 连接、重连、加入组播组 |
| `node_role` | NVS 存储节点角色（Slave）及运行参数 |

#### 3.4.1 `StartAndStop`

- **实现状态**：已实现（`StartAndStop.h` / `StartAndStop.c`）。
- **职责**：初始化电源保持输出，检测电源键长按并执行关机。
- **对外接口**：

```c
void StartAndStop_Init(void);
void SystemStart(void);
```

#### 3.4.2 `wifi_manager`

- **实现状态**：已实现（`components/mysystem/wifi_manager/wifi_manager.h` / `wifi_manager.c`）。
- **职责**：
  - STA 连接、断线自动重连；启动时凭据从 `node_role` 读取（本模块不直接写 NVS）；
  - 配网：从节点**没有配网 UI**，SSID / 密码存在 `node_role`（NVS），当前由固件内置默认值落盘；`wifi_manager_set_sta()` 作为后续配网入口保留（先经 `node_role_set()` 持久化，再发起连接）；
  - 统一持有 UDP 组播 socket：控制组播（音量 / ANNOUNCE，`239.0.0.1:5679`）与灯控等通道由 `wifi_manager_mcast_open()` 创建并维护；音频数据面是 `udp_audio` 自建的单播 socket（5680），不经本模块；WiFi 重连 / IP 变化后内部自动重建并重新加入组播，业务模块无感知；
  - 事件仅作状态通知，业务模块可选注册；UI 图标与 OTA 通过查询接口获取状态，不注册事件。
- **对外接口**：

```c
/* 句柄 */
typedef struct wifi_manager_s *wifi_manager_handle_t;

/* 状态（UI 图标 / OTA 用） */
typedef enum {
    WIFI_STATE_IDLE = 0,      /* 未启动/已停止 */
    WIFI_STATE_CONNECTING,    /* 连接中 */
    WIFI_STATE_CONNECTED,     /* 已连接并拿到 IP */
    WIFI_STATE_DISCONNECTED,  /* 断开，自动重连中 */
    WIFI_STATE_ERROR,         /* 重试用尽/凭据错误 */
} wifi_state_t;

/* 事件（状态通知，业务模块可选注册） */
typedef enum {
    WIFI_EVT_CONNECTED,       /* 连接成功，携带 IP */
    WIFI_EVT_DISCONNECTED,    /* 连接断开 */
    WIFI_EVT_RECONNECTING,    /* 开始自动重连 */
    WIFI_EVT_IP_CHANGED,      /* IP 变化，本模块已自动重建组播通道 */
} wifi_event_id_t;

typedef struct {
    wifi_event_id_t id;
    char   ssid[33];
    char   ip[16];
    int8_t rssi;
} wifi_mgr_event_t;   /* 与 esp-idf 的 wifi_event_t 重名，实现改名为 wifi_mgr_event_t */

typedef void (*wifi_event_cb_t)(const wifi_mgr_event_t *evt, void *user_ctx);

/* 配置 */
typedef struct {
    uint32_t connect_timeout_ms;     /* 单次连接超时，默认 10000 */
    uint32_t reconnect_interval_ms;  /* 重连间隔，默认 3000 */
    uint32_t max_retries;            /* 连续失败次数，0 = 无限重连 */
} wifi_manager_cfg_t;

/* 生命周期；start 时从 node_role 读取凭据并连接 */
wifi_manager_handle_t wifi_manager_create(const wifi_manager_cfg_t *cfg);
void                  wifi_manager_destroy(wifi_manager_handle_t h);
esp_err_t wifi_manager_start(wifi_manager_handle_t h);
esp_err_t wifi_manager_stop(wifi_manager_handle_t h);

/* 配网（UI 触摸屏）：仅用新凭据立即发起连接（持久化由 node_role 负责） */
esp_err_t wifi_manager_set_sta(wifi_manager_handle_t h,
                               const char *ssid, const char *password);

/* 事件订阅（业务模块可选注册） */
esp_err_t wifi_manager_register_event_cb(wifi_manager_handle_t h,
                                         wifi_event_cb_t cb, void *user_ctx);

/* 状态查询（UI 图标 / OTA 用） */
esp_err_t wifi_manager_get_state(wifi_manager_handle_t h, wifi_state_t *state);
bool      wifi_manager_is_connected(wifi_manager_handle_t h);
esp_err_t wifi_manager_get_ip(wifi_manager_handle_t h, char *ip, size_t *len);
int8_t    wifi_manager_get_rssi(wifi_manager_handle_t h);

/* 组播通道：UDP socket 统一由本模块持有（控制 / 灯控共用） */
typedef struct wifi_mcast_s *wifi_mcast_handle_t;

typedef struct {
    const char *group;          /* 组播组，如 239.0.0.1（控制）/ 239.0.0.2（灯控） */
    uint16_t    port;           /* 绑定端口，控制 5679、灯控 8889（音频数据面为单播 5680，不走组播） */
    bool        rx_enable;      /* 需要接收：模块内开 RX 任务 + FIFO */
    uint32_t    rx_fifo_bytes;  /* 接收 FIFO，默认 16384 */
} wifi_mcast_cfg_t;

esp_err_t wifi_manager_mcast_open(wifi_manager_handle_t h,
                                  const wifi_mcast_cfg_t *cfg,
                                  wifi_mcast_handle_t *out);
esp_err_t wifi_manager_mcast_send(wifi_mcast_handle_t ch,
                                  const void *data, size_t len,
                                  uint32_t timeout_ms);
esp_err_t wifi_manager_mcast_recv(wifi_mcast_handle_t ch, /* 从 FIFO 阻塞取 */
                                  void *buf, size_t cap, size_t *len,
                                  uint32_t timeout_ms);
esp_err_t wifi_manager_mcast_close(wifi_mcast_handle_t ch);
```

- **备注**：UI 图标采用 `wifi_manager_get_state()` 查询刷新；如需实时推送，可后续把事件回调扩展为多订阅者。OTA 的 HTTP/TCP 下载由 `ota_manager` 自行管理（不经组播），仅通过 `wifi_manager_is_connected()` 判断 WiFi 是否就绪；NVS 持久化统一由 `node_role` 负责，wifi_manager 不直接写 NVS。

#### 3.4.3 `node_role`

- **实现状态**：已实现（`components/mysystem/node_role/node_role.h` / `node_role.c`）。
- **职责**：
  - NVS 持久化唯一入口：节点角色（主/从）与运行参数（WiFi 凭证、音频采样率（固定 44.1kHz）、音量、播放模式、同步延迟、组播地址、OTA 服务器地址）；
  - 全局唯一实例，内存缓存一份配置，读走缓存；只做持久化读写，不触发业务动作；
  - 主/从节点共用；首次开机无数据时使用 defaults 落盘。
- **对外接口**：

```c
/* 节点角色 */
typedef enum {
    NODE_ROLE_MASTER = 0,
    NODE_ROLE_SLAVE,
} node_role_t;

/* 运行参数（整体式读写，NVS blob） */
typedef struct {
    uint16_t     version;               /* blob 结构版本号，当前 1 */
    uint8_t      role;                  /* 主/从：0=MASTER，1=SLAVE */
    char         wifi_ssid[32];         /* WiFi 名 */
    char         wifi_password[64];     /* WiFi 密码 */
    char         ota_server_url[256];   /* OTA 服务器地址，默认 192.168.4.16:5000/ota/check */
    uint8_t      volume;                /* 音量 0-100 */
    uint8_t      play_mode;             /* 播放模式：0 顺序、1 单曲循环 */
    uint32_t     sync_delay_ms;         /* 同步延迟 D，默认 200 */
    uint32_t     audio_sample_rate;     /* 音频采样率：固定 44100（保留字段） */
    char         multicast_group[16];   /* 通道组地址（控制组播），默认 239.0.0.1 */
} node_role_cfg_t;

/* 初始化：app_main 开机调用，首次按 defaults 写入 NVS */
esp_err_t node_role_init(const node_role_cfg_t *defaults);

/* 读：返回缓存副本（线程安全） */
esp_err_t node_role_get(node_role_cfg_t *out);

/* 写：更新缓存 + 写 NVS（整体原子提交） */
esp_err_t node_role_set(const node_role_cfg_t *cfg);

/* 便捷查询 */
node_role_t node_role_get_role(void);
bool        node_role_is_master(void);
```

- **备注**：音频端口（单播 5680、控制组播 5679）、灯控端口（8889）等作为代码常量，不入 NVS；WiFi 配网持久化统走本模块（如 `wifi_manager_set_sta()` 不写 NVS）；OTA 服务器地址经本模块持久化（`node_role` blob 里的 `ota_server_url` 字段，不单独建键），`ota_manager` 初始化按 `cfg->check_url → node_role 配置 → 默认宏` 优先读取。

#### 3.4.4 `ota_manager`

- **实现状态**：**未实现**；`components/mysystem/ota_manager/ota_manager.h` / `ota_manager.c` 当前都是空壳（各自只有一行 `#include`），分区表里只有 `ota_0` / `ota_1` 槽位，本小节为规划的对外接口。
- **职责**：
  - 局域网 Pull-style OTA：GET `/ota/check` 获取元数据 `{version, sha256, url}`，语义化比较版本号；
  - 发现新版本后经由 `esp_https_ota` 流式下载到备用分区，校验 SHA256 后切换启动分区并重启；
  - 通过事件回调通知上层下载进度/状态（如 `DOWNLOAD_STARTED` 时暂停高内存/高带宽任务），模块不依赖 WiFi / 音频 / AI 云具体模块。
- **对外接口**：

```c
/* 事件类型 */
typedef enum {
    OTA_UPDATE_EVT_CHECK_STARTED = 0,   /* 开始检查远端版本 */
    OTA_UPDATE_EVT_UP_TO_DATE,          /* 已是最新版本 */
    OTA_UPDATE_EVT_UPDATE_AVAILABLE,    /* 发现新版本，准备下载 */
    OTA_UPDATE_EVT_DOWNLOAD_STARTED,    /* 开始下载固件 */
    OTA_UPDATE_EVT_DOWNLOAD_PROGRESS,   /* 下载进度变化 */
    OTA_UPDATE_EVT_DOWNLOAD_FINISHED,   /* 固件下载并校验完成 */
    OTA_UPDATE_EVT_READY_TO_REBOOT,     /* 即将重启进入新固件 */
    OTA_UPDATE_EVT_ABORTED,             /* 检测/下载失败或升级中止 */
} ota_update_event_t;

typedef struct {
    ota_update_event_t event;            /* 事件类型 */
    char version[OTA_VERSION_MAX_LEN];   /* 远端固件版本号 */
    char sha256[OTA_SHA256_MAX_LEN];     /* 远端固件 SHA256 */
    char url[OTA_URL_MAX_LEN];           /* 远端固件下载 URL */
    int  progress_percent;               /* 下载进度 0~100；其他事件为 -1 */
    int  http_status;                    /* HTTP 状态码；非 HTTP 阶段为 0 */
} ota_update_event_info_t;

typedef void (*ota_update_event_cb_t)(const ota_update_event_info_t *info, void *user_ctx);

/* 初始化配置；cfg 可传 NULL 使用默认值 */
typedef struct {
    const char *check_url;            /* /ota/check URL；NULL 时依次取 `node_role` 的 `ota_server_url`、`OTA_SERVER_CHECK_URL` */
    const char *local_version;         /* 本地版本号；NULL 自动读取当前运行固件版本 */
    uint32_t check_timeout_ms;         /* 检测超时；0 用默认 5000 */
    uint32_t download_timeout_ms;      /* 下载超时；0 用默认 60000 */
    ota_update_event_cb_t event_cb;    /* 事件回调，可为 NULL */
    void *event_user_ctx;              /* 回调用户上下文 */
} ota_update_config_t;

/* 生命周期 */
esp_err_t OTA_Update_Init(const ota_update_config_t *cfg);
esp_err_t OTA_Update_Start(void);                  /* 后台周期性检测+升级 */
esp_err_t OTA_Update_CheckAndUpgrade(void);        /* 一次性阻塞检测+升级 */
esp_err_t OTA_Update_RegisterEventCallback(ota_update_event_cb_t cb, void *user_ctx);

/* 回滚确认：新固件首次启动确认正常后调用 */
esp_err_t OTA_Update_MarkAppValid(void);

/* 查询 */
const char *OTA_Update_GetLocalVersion(void);
const char *OTA_Update_GetRemoteVersion(void);
bool        OTA_Update_IsBusy(void);
```

- **备注**：
  - `check_url` 解析优先级：`cfg->check_url` → `node_role` 的 `ota_server_url` 字段（blob 内，由 `node_role` 持久化）→ 默认宏 `OTA_SERVER_CHECK_URL`；因此 `OTA_Update_Init(NULL)` / `OTA_Update_Start()` 隐式初始化时也能从 NVS 读到服务器地址；
  - 需在 WiFi 就绪后调用（可用 `wifi_manager_is_connected()` 判断）；模块只走 HTTP（TCP），不走组播；
  - `OTA_Update_CheckAndUpgrade()` 阻塞期间会自动创建独立任务执行，避免调用方小栈任务栈溢出。

## 5. 关键数据流

### 5.1 同步播放数据流

```reStructuredText
主节点 UDP 单播 → 从节点 5680
        │
        ▼
从节点 WiFi 接收（不加入组播组）
        │
        ▼
udp_audio
        │
        ├── 解析包头：stream_id, flags, seq, t_play_us, payload_len, lead_ms
        ├── 计算 offset = d_min + lead_ms×1000 + 60ms
        ├── 按 seq 放入抖动缓冲环形槽位
        │
        ▼
udp_audio 播放任务
        │
        ├── 等到 t_play_us + offset
        ├── 从槽位取 PCM
        ├── 缺帧时用上一帧 PLC（3/4 衰减）补
        │
        ▼
Amplifier_Play_Buffer()
        │
        ▼
I2S → 喇叭
```

### 5.2 时钟同步数据流

音频同步不使用 PING/PONG：`PING(0x20)` / `PONG(0x21)` 帧仍保留在控制通道定义里，但已不参与音频同步，从节点也不回包。时钟偏移由单向观测得到：

```reStructuredText
主节点单播音频帧（带 t_play_us）
        │
        ▼
从节点收到：d(i) = 本地收到时刻 − t_play_us
        │
        ▼
窗口（64 帧）内取最小值 d_min
        │
        ▼
offset = d_min + lead_ms×1000 + 60ms
        │
        ▼
出声时刻 = t_play_us + offset
```

主节点本地也按 `t_play_us + 60ms` 出声，所以两端残差只有最小单程延迟（局域网通常 1~3ms）。

### 5.3 漂移校正数据流

从节点不收心跳、不做速率微调，也不改 I2S 采样率；漂移由抖动缓冲水位间接观测，再用丢/插单样点补偿：

```reStructuredText
从节点每个播放帧
  ├── 跑道 = 最近收到的 t_play − 正在播放帧的 t_play
  ├── 开播 200 帧后把跑道均值定为基准
  ├── 跑道比基准长 > 4ms → 丢 1 个样点（加快播放头）
  ├── 跑道比基准短 > 4ms → 插 1 个样点（放慢播放头）
  └── 两次 slip 间隔 ≥ 20ms，拼接点做 8 点线性过渡
```

------

## 6. 同步机制（从节点核心算法）

### 6.1 启动同步

1. 从节点连接 WiFi（**不加入音频组播组**）。

2. 在 UDP `5680` 上 `bind(INADDR_ANY)`，等待主节点单播音频帧。

3. 每收到一帧记录 `d(i) = now − t_play_us`，维护最近 64 帧窗口内的最小值 `d_min`。

4. 攒够 preroll（有效帧 ≥ 8 且缓冲深度 ≥ `lead_ms` 的 3/4）后冻结换算偏移：

   ```text
offset = d_min + lead_ms × 1000 + 60000
   t_play_local = t_play_us + offset
   ```
   
5. 等到 `t_play_local` 到达时起播（首帧 128 点淡入，避免直流台阶）。

6. 已播过的 `seq` 直接丢弃，迟到包不覆盖槽位。

7. 缓冲深于 450ms 时跳到约 150ms 的位置，避免延迟无限累积。

### 6.2 持续校正

- 从节点不回包、不收心跳；播放过程中**不重算 offset**（重算等于改出声时刻，会产生阶跃）。

- 观测量是抖动缓冲"跑道"：`跑道 = 最近收到的 t_play − 正在播放帧的 t_play`。从机晶振慢 → DMA 消耗慢 → 跑道变长。

- 开播 200 帧后把跑道均值定为基准，之后只看它相对基准的变化量。

- 调整策略：

  | 条件                     | 动作                                         |
| :----------------------- | :------------------------------------------- |
  | `跑道 − 基准 > +4ms`     | 丢 1 个样点（加快播放头）                    |
| `跑道 − 基准 < −4ms`     | 插 1 个样点（放慢播放头）                    |
  | 其余                     | 保持                                         |
  
- 两次 slip 间隔 ≥ 20ms，拼接点做 8 点线性过渡；**不改 I2S 采样率**（`disable → reconfig → enable` 会清空 DMA 中未播的音频）。

### 6.3 异常处理

| 异常场景 | 处理策略 |
| :--- | :--- |
| 丢包（Seq 不连续） | 用上一帧 3/4 衰减后的 PLC 补一帧，`seq` 照常前进 |
| Jitter Buffer 欠载 | 同上（没有上一帧可参考时补 10ms 静音）；断流 > 500ms 清盘重新 preroll |
| 网络中断 > 500ms | 持续写静音（避免 DMA 放空出嗡嗡声），断流超时后清盘重新 preroll；不涉及组播重新加入 |
| 主节点重启 / 切换 | 检测到 `stream_id` 变化或首帧标志，清空缓冲重新 preroll |
| 从节点启动晚于主节点 | 按最小单程延迟对齐，落后的帧直接丢弃 / 跳帧，从可播位置开始 |
| 主节点暂停 / 恢复 | 从节点不解析 PAUSE / PLAY（`ctl_rx` 只认音量帧）；主节点停发后按"欠载 / 断流"处理，恢复发流后重新 preroll |
| 主节点切歌 | 靠 `stream_id` / 首帧标志识别新流并清盘，不解析 `NEXT` / `PREV` |

------

## 7. FreeRTOS 任务设计（从节点）

> **任务视图说明**：任务表为**实现视图**——与主节点一致，App 层任务与 mysystem / middlewares 模块内部自建的常驻任务全部登记（见“所属”列），优先级、栈、核绑定全局统一仲裁；模块内部任务由模块自身 `create/start` 创建，App 层不感知创建细节。从节点无蓝牙（`bt_audio`）、无 SD 解码（`audio_decoder`）、无 UI/麦克风等模块，因此表中只登记同步链路、控制通道与网络三类任务。

> **核分配原则（设计目标；当前 `udp_audio` / `ctl_rx` 的任务尚未绑定核）**：Core 0 (PRO_CPU) 承担协议与系统核心——Wi-Fi、TCP/IP 栈（lwIP）以及高精度定时器等系统关键任务默认固定在其上运行，负载较高，**不适合再放置高优先级、计算密集型的应用任务**；Core 1 (APP_CPU) 是应用与实时核心，**对实时性、流畅度要求高的任务（I2S 音频输出）都放在 Core 1**，与网络协议栈解耦，保证执行确定性。

| 任务名 | 所属 | 优先级 | 栈大小  | 核 | 功能 |
| :--- | :--- | :----- | :--- | :--- | :--- |
| `udp_audio_rx` | middlewares: `udp_audio` | 11 | 4096 | 未绑定（`xTaskCreate`） | 在 5680 单播 socket 上 `recvfrom` → 校验 magic/version → 按 `seq` 落环形槽位 → 更新 `d(i)` 偏移窗口 |
| `udp_audio_play` | middlewares: `udp_audio` | 10 | 5120 | 未绑定（`xTaskCreate`） | 攒够 preroll 后等 `t_play_us + offset`，取 PCM 经 `Amplifier_Play_Buffer()` 落 I2S；缺帧 PLC / 断流重新 preroll / sample slip |
| `ctl_rx` | middlewares: `ctl_rx` | 5 | 3072 | 未绑定（`xTaskCreate`） | 控制组播 5679：取 4 字节音量帧调 `Amplifier_Set_Volume()`；每 3s 发一条 ANNOUNCE |
| `wifi_mcast_rx_Task` | mysystem: `wifi_manager` | 6 | 4096 | **Core 0** | 组播收包写入通道 FIFO（`rx_enable` 的通道各创建一个，从节点当前只有控制通道） |

> WiFi 连接 / 断线重连由 esp_event 默认事件循环处理，**没有独立的 `WiFi_Manager_Task`**；`OTA_Task` 也不存在——`ota_manager` 目前是空壳，OTA 尚未实现。

**核分配理由**：
- `udp_audio_rx`：从单播 socket 收包，依赖 lwIP 栈侧数据；只解包入队，出声对齐不在这里。当前用 `xTaskCreate()` 创建，未绑定核。
- `udp_audio_play`：写 I2S 是实时音频输出，按上表设计目标应放 Core 1 以减小抖动；当前同样用 `xTaskCreate()`，未绑定核。
- `ctl_rx`：读控制组播 FIFO 并周期发公告，负载很轻；同样未绑定核。
- `wifi_mcast_rx_Task`（Core 0）：组播收包依赖 lwIP 栈，用 `xTaskCreatePinnedToCore()` 固定在 Core 0，优先级 6，与主节点一致。
- **不建独立任务说明**：`StatusLed`（GPIO 状态指示）**不建独立任务**——`StatusLed_Init()` 在 `app_main` 里调用一次，`StatusLed_On()/Off()` 原定由 `MusicPlay` 按播放状态调用，但 `MusicPlay` 尚未实现，当前两个接口没有任何调用者。

> 实现约定：`wifi_manager` 的组播收包任务用 `xTaskCreatePinnedToCore()` 绑定 Core 0；`udp_audio`、`ctl_rx` 的任务当前用 `xTaskCreate()` 创建（未绑定核）；模块内部任务由各模块 `create/start` 接口自建。

> 任务间通信：事件组通知同步状态切换，消息队列 / 环形缓冲区（FIFO / Jitter Buffer）传输 PCM 数据块。

------

## 8. 目录结构

```text
project_slave/
├── main/
│   ├── app_main.c
│   ├── idf_component.yml
│   └── CMakeLists.txt
├── components/
│   ├── bsp/
│   │   ├── gpio_driver/
│   │   └── i2s_driver/
│   ├── middlewares/
│   │   ├── amplifier/
│   │   ├── ctl_rx/
│   │   └── udp_audio/
│   ├── App/
│   │   ├── MusicPlay/
│   │   └── StatusLed/
│   └── mysystem/
│       ├── StartAndStop/
│       ├── ota_manager/
│       ├── wifi_manager/
│       └── node_role/
└── partitions.csv
```

> 从节点是独立工程（`Play_Slave`），不使用 `CONFIG_NODE_ROLE_SLAVE` 之类的角色裁剪宏；`bt_audio`、`LCD_Touch`、`sd_card`、`audio_decoder`、`microphone` 等模块本就不在工程里。

------

## 9. 关键 menuconfig 配置

```bash
# WiFi 与组播
CONFIG_LWIP_IPV4=y
CONFIG_LWIP_MULTICAST=y
CONFIG_LWIP_IGMP=y

# OTA（规划：当前 sdkconfig 里 `CONFIG_BOOTLOADER_APP_ROLLBACK_ENABLE` 未开，
#      `ota_manager` 也还是空壳）
CONFIG_ESP_OTA=y
CONFIG_BOOTLOADER_APP_ROLLBACK_ENABLE=y

# 节点角色
# 从节点是独立工程，没有角色切换的 Kconfig（CONFIG_NODE_ROLE_SLAVE 未使用）

# 蓝牙（从节点关闭）
CONFIG_BT_ENABLED=n

# FATFS（从节点无 SD 卡，关闭）
CONFIG_FATFS_LONG_FILENAMES=n
```

------

## 10. 分区表建议（开发板 ESP32-S3-N16R8，16MB Flash）

```csv
# Name,    Type, SubType, Offset,   Size,    Flags
nvs,       data, nvs,     0x9000,   0x4000,
otadata,   data, ota,     0xD000,   0x2000,
factory,   app,  factory, 0x10000,  0x200000,
ota_0,     app,  ota_0,   0x210000, 0x400000,
ota_1,     app,  ota_1,   0x610000, 0x400000,
storage,   data, spiffs,  0xA10000, 0x4F0000,
model,     data, spiffs,  0xF00000, 0x100000,
```

> 与 `Play_Slave/partitions.csv` 一致。当前运行的是 `factory` 分区，`ota_0` / `ota_1` 只是预留槽位（OTA 未实现），因此实际还没有走双备份升级流程。

## 11. 配网

从节点目前**没有配网 UI**（无屏，也没有 AP 配网流程）：WiFi SSID / 密码存放在 `node_role`（NVS），当前由固件内置默认值首次落盘；后续再补配网入口（`wifi_manager_set_sta()` 已预留）。
