currygood/MusicPlaySyncSpeakers/docs/03-开发/主音频节点任务与内存分配.md

# 主节点任务与内存分配说明

> 适用对象：主音频节点（`Play_Master`，ESP32-WROVER-E-N16R8，16MB Flash + 8MB PSRAM）。
> 本文是**实现视图**：任务参数、缓冲大小全部取自当前代码与当前构建产物
> （`build/Play_Master.elf`、`build/Play_Master.map`、`idf.py size`），
> 与《主音频节点软件构架分层设计.md》§6 的设计视图存在若干差异，见第 9 节。

**核心结论**：内部 RAM 是最稀缺资源，**只有任务栈、DMA 缓冲、ISR/定时器回调缓冲必须留在内部 RAM**；
其余音频/网络数据缓冲、模块句柄、队列/信号量一律放 PSRAM（8MB 富余）。

---

## 1. 常驻任务总表

优先级数值越大越高（`configMAX_PRIORITIES = 25`，tick = 1000Hz，双核）。

| 任务名 | 所属模块 | 优先级 | 栈(B) | 栈位置 | 核 | 功能 | 创建点 |
| :--- | :--- | :--- | :--- | :--- | :--- | :--- | :--- |
| `UI_Task` | App: UI | 10 | 32768 | 内部 RAM | **0** | LVGL 界面渲染与交互；图片按需从 Flash 加载 | `main/app_main.c:1071`（启动最先建，栈最大先占位） |
| `SyncLocalPlay_Task` | middlewares: sync_protocol | **12** | 4096 | 内部 RAM | 1 | 本地延迟队列取 PCM，按 `t_play_us + 60ms` 写 I2S | `components/middlewares/sync_protocol/sync_protocol.c:1325` |
| `SyncTx_Task` | middlewares: sync_protocol | 11 | 4096 | 内部 RAM | 0 | 打时间戳、UDP 逐台单播发送（依赖 lwIP） | `components/middlewares/sync_protocol/sync_protocol.c:1322` |
| `audio_decoder` | middlewares: audio_decoder | 10 | 4096 | 内部 RAM | 1 | SD 卡 MP3 流式解码 → `on_pcm` | `components/middlewares/audio_decoder/audio_decoder.c:887` |
| `MusicPlay_Task` | App: MusicPlay | 9 | 4096 | 内部 RAM | 1 | 选曲/播放状态机 + 自动源选择（轮询 A2DP） | `components/App/MusicPlay/music_play.c:1658` |
| `wifi_mcast_rx` | mysystem: wifi_manager | 6 | 6144 | 内部 RAM | 0 | 组播收包 → FIFO（rx 通道 ack/status） | `components/msystem/wifi_manager/wifi_manager.c:762` |
| `bt_audio_task` | middlewares: bt_audio | 11 | 4096 | 内部 RAM | 1 | 蓝牙事件 FIFO 出队 → `on_event`/`on_pcm` | `components/middlewares/bt_audio/bt_audio.c:2283` |
| `SmartHome_Task`（`Light_Control_Task`） | App: LightControl | 5 | 4096 | 内部 RAM | 0 | 灯控指令 UDP 组播 + ack/30s status 解析 | `components/App/LightControl/light_control.c:479` |
| `ota_update` / `ota_sync` | mysystem: ota_manager | 5 | 12288 | 内部 RAM | 0 | OTA 下载/校验/升级（**按需动态创建**，无常驻） | `components/msystem/ota_manager/OTA_Update.c:836` / `:900` |
| `ota_ui` | App: UI（scr_settings） | 5 | 4096 | 内部 RAM | 0 | 设置页 OTA 检查后台任务（**按需动态创建**） | `components/App/UI/scr_settings.c:640` |
| `Touch_Task` | middlewares: LCD_Touch | 3 | 2048 | 内部 RAM | 0 | FT6336G 触摸扫描 | `components/middlewares/LCD_Touch/LCD_Touch.c:665` |
| `app_hb` | main: app_main | 2 | 3072 | 内部 RAM | 0 | 3s 低频心跳 + 唯一的 `[btpcm]` 统计打印点（诊断用，非功能任务） | `main/app_main.c:1096` |

- **栈位置**：FreeRTOS 任务栈不允许落在 PSRAM（切栈/`vTaskDelete` 会断言"当前任务栈在 DRAM"），
  故上表全部为**内部 RAM**。
- **栈合计**：常驻任务约 64KB（含诊断心跳 `app_hb` 约 67KB）；含按需创建的 OTA 任务约 79KB（不含 ESP-IDF 内置任务）。

## 2. 启动引导任务（boot，临时）

`main/app_main.c` 在 `app_main()` 里**最先**创建 `UI_Task`（栈最大，趁内部堆还完整时
占住这块连续内存，随后阻塞等各模块就绪），再**严格串行**创建 2 个引导任务：每个任务
完成对应模块的 `create()`、置位就绪事件后 `vTaskDelete(NULL)` 退出，`app_main` 再建下一个
（中间 `vTaskDelay(50ms)` 让 IDLE 回收栈）。

| 任务名 | 入口函数 | 优先级 | 栈(B) | 核 | 依赖 / 职责 |
| :--- | :--- | :--- | :--- | :--- | :--- |
| `mp_boot` | `App_MusicPlay_Task` | **11** | 4096 | 1 | 建 MusicPlay（内部建蓝牙）→ 置 `APP_EVT_MUSIC_READY` |
| `lc_boot` | `App_LightControl_Task` | **9** | 3072 | 0 | 等 WiFi ready → 建 LightControl |
宏定义：`APP_MUSIC_TASK_PRIO = 11`、`APP_LIGHT_TASK_PRIO = 9`、
`APP_MUSIC_TASK_STACK = 4096`、`APP_LIGHT_TASK_STACK = 3072`、
`APP_UI_TASK_STACK = UI_TASK_STACK_BYTES`（32768，定义在 `components/App/UI/ui.h`）、
`APP_UI_TASK_PRIO = 10`（`main/app_main.c:88-113`）。
另有一个 `APP_BOOT_TASK_PRIO = 10` 宏，当前未被引用（仅作注释性说明）。

> **boot 优先级为何提到 9~11**（`app_main.c:88-92`）：boot 任务必须高于解码(10)/同步(11)，
> 否则解码节流在"恰好追平"时余量 <1ms、不再 `vTaskDelay`（连续不让步），prio 5 的 boot
> 任务会被饿死——实测表现为 boot 任务 60s 内既不就绪也不失败，UI 只能陪等满 60s 超时才出屏。

> 所有 boot 任务统一经 `App_Boot_Task_Create()` 创建：失败会打印内部堆余量并置对应
> FAILED 位，依赖方不再空等超时；`app_main()` 收尾改为 `return`，让 IDF 主任务自删、
> 回收约 4KB 内部栈。

> **为什么串行**：引导栈同样必须落内部 DRAM，2 个 boot 栈并存会直接把内部 RAM 吃光；
> 串行 + 逐个回收，是启动期内部 RAM 峰值最小化的关键约束。

## 3. ESP-IDF 内置任务（非本项目创建，仅登记）

| 任务名 | 优先级 | 栈(B) | 核 | 说明 |
| :--- | :--- | :--- | :--- | :--- |
| `IDLE0` / `IDLE1` | 0 | 1536 | 0 / 1 | `CONFIG_FREERTOS_IDLE_TASK_STACKSIZE` |
| `Tmr Svc` | 1 | 2048 | 0 | FreeRTOS 软件定时器服务 |
| `main`（app_main） | 1 | 4096 | 0 | `CONFIG_ESP_MAIN_TASK_STACK_SIZE`(3584)+`TASK_EXTRA_STACK_SIZE`(512) |
| `tiT`（lwIP TCP/IP） | 18 | 3584 | 未绑定 | `CONFIG_LWIP_TCPIP_TASK_PRIO=18`，栈 3072+512 |
| `sys_evt` | 20 | 2816 | 0 | `ESP_TASKD_EVENT_PRIO = MAX-5`，2304+512（未开 core-locking） |
| `BTU` | 20 | 4864 | 0 | Bluedroid 上层，`CONFIG_BT_BTU_TASK_STACK_SIZE`(4352)+512 |
| `BTC` | 19 | 3584 | 0 | Bluedroid 控制，`CONFIG_BT_BTC_TASK_STACK_SIZE`(3072)+512 |
| `esp_timer` | 22 | 4096 | 0 | `ESP_TASK_TIMER_PRIO = MAX-3`，3584+512 |
| `btController` | 23 | 4096 | 0 | `ESP_TASK_BT_CONTROLLER_PRIO = MAX-2`，3584+512 |
| `wifi` | 23 | ~3584 | 0 | `CONFIG_ESP_WIFI_TASK_PINNED_TO_CORE_0` |
| `ipc0` / `ipc1` | 24 | 1024 | 0 / 1 | `CONFIG_ESP_IPC_TASK_STACK_SIZE` |

- `TASK_EXTRA_STACK_SIZE`：本工程用 picolibc（未开 `CONFIG_LIBC_NEWLIB_NANO_FORMAT`），
  IDF 头文件按 512 预留，故上表系统栈 = 配置值 + 512。
- 内置任务栈合计约 37.9KB，全部占**内部 RAM**，是内部 RAM 预算里必须先扣掉的一块。

## 4. 内存放置红线（必须内部 RAM）

1. **所有任务栈**（含引导栈）——PSRAM 栈会触发断言；
2. **DMA 缓冲与描述符**（I2S RX/TX、LCD SPI flush、SD/SPI 传输）；
3. **ISR / `esp_timer` 回调**里访问的缓冲（回调要求代码与数据都在内部 RAM）；
4. **cache 一致性 / 极低延迟**数据（如 `sync_master_s` 这类被高频读写的模块单例）。

除此之外的音频/网络数据缓冲、模块句柄、队列与信号量，**一律 PSRAM 优先、内部 RAM 回退**。

## 5. PSRAM 缓冲清单

分配方式：`heap_caps_malloc/calloc(..., MALLOC_CAP_SPIRAM | MALLOC_CAP_8BIT)`，
失败回退 `MALLOC_CAP_INTERNAL`；队列/信号量用 `xQueueCreateWithCaps` /
`xSemaphoreCreateXxxWithCaps(MALLOC_CAP_SPIRAM)`。

| 缓冲 / 对象 | 大小(B) | 位置 | 说明 |
| :--- | ---: | :--- | :--- |
| `s_hfpDnStereoBuf` | 4096 | `main/app_main.c` | HFP 下行单声道→立体声扩展（2048 样本×2B）；语音链路已下线，代码保留 |
| `s_bt_audio`（`bt_audio_s`） | 3992 | `bt_audio.c` | 蓝牙模块单例（FIFO 句柄、回调、任务句柄） |
| `evt_q_storage` | 4×536 = 2144 | `bt_audio.c` | 蓝牙事件队列静态存储（4 深度） |
| `task_pcm_buf` | 4096 | `bt_audio.c` | 蓝牙任务 PCM 出队缓冲（2048 样本） |
| `task_hfp_dn_raw` | 320 | `bt_audio.c` | HFP 下行原始块 |
| A2DP PCM FIFO | 65536 | `bt_audio.c` | 64KB（`BT_A2DP_FIFO_DEFAULT_BYTES`） |
| HFP 上行 FIFO | 16384 | `bt_audio.c` | 16KB（`BT_HFP_UP_FIFO_DEFAULT_BYTES`）；语音链路已下线，代码保留 |
| HFP 下行 FIFO | 8192 | `bt_audio.c` | 8KB（`BT_HFP_DN_FIFO_DEFAULT_BYTES`）；同上 |
| `ingress_buf` | 65536 | `sync_protocol.c` | 入口 StreamBuffer 存储（64KB ≈ 741ms @44.1k/16bit/单声道，`SYNC_CFG_DEFAULT_INGRESS_BYTES`） |
| `delay_q` | 24×1432 = 34368 | `sync_protocol.c` | 本地延迟队列，默认 24 包（`SYNC_CFG_DEFAULT_DELAY_PKTS`），单包 `sizeof(sync_delay_entry_t)`=1432B |
| `frame_buf` | 1400 | `sync_protocol.c` | 攒帧缓冲（700 样本） |
| `play_buf` | 2800 | `sync_protocol.c` | 单声道→立体声扩展（700×2×2B） |
| `tx_pkt` | 1420 | `sync_protocol.c` | 组包缓冲（20B 头 + 700×2B） |
| `in_buf` | 8192 | `audio_decoder.c` | MP3 输入滑动窗口（约 6 帧） |
| `scratch`（`mp3dec_scratch_t`） | 16236 | `audio_decoder.c` | 帧解码 scratch，**不占任务栈** |
| `audio_decoder_s`（句柄） | 6800 | `audio_decoder.c` | `calloc` 超过 4KB 阈值 → 实际落 PSRAM |
| `s_amp_scaled` | 8192 | `amplifier.c` | 音量缩放输出（2048 帧×2ch×2B） |
| `wifi_mcast_rx` 收包缓冲 | 4096 | `wifi_manager.c` | 组播收包临时缓冲 |
| `music_play_s`（句柄） | 336 | `music_play.c` | 含 cmd 队列 4×540、mutex、二进制信号量 |
| `light_control_s`（句柄） | 260 | `light_control.c` | 含 cmd 队列 8×24、mutex、信号量 |
| UI 灯控 / 播放事件队列 | 8×28 / 8×32 | `ui.c` | `xQueueCreateWithCaps(..., MALLOC_CAP_SPIRAM)` |
| `Sd_Mkfs_Work()`（f_mkfs 工作区） | 4096 | `sd_card.c` | 惰性分配一次；`bsp/spi_driver` 已做 DMA 中转，不再要求内部 RAM |

**PSRAM 占用合计约 253KB**（258,972 B；PSRAM 总量 8MB，余量充足）。

> 两处大缓冲是为"播放中不欠载"付的代价：A2DP FIFO 64KB 吸收蓝牙回调与解码任务之间的抖动；
> sync 入口环 64KB（≈741ms）吸收 UI 切页/整屏重绘（约 120ms 刷屏）抢占解码任务造成的欠载窗口。
> 早期版本分别是 24KB / 24KB、延迟队列 16 包，合计约 163KB，改为现值合计约 253KB。

> `audio_decoder_s` 的落点是 heap 分配阈值决定的：`CONFIG_SPIRAM_MALLOC_ALWAYSINTERNAL = 0`，
> 普通 `calloc` 分配 > 4096B 时 IDF 优先取 PSRAM。`audio_decoder.c` 里"随结构体在内部 DRAM"
> 的注释与实际不符，需要时改用 `heap_caps_calloc(MALLOC_CAP_INTERNAL)` 才会真正落内部 RAM。

## 6. 内部 RAM 缓冲清单

| 缓冲 / 对象 | 大小(B) | 位置 | 说明 |
| :--- | ---: | :--- | :--- |
| 功放 I2S TX DMA | 4×512×4 = 8192 | `amplifier.c` | `dma_desc_num=4`，`dma_frame_num=512`，2slot×16bit |
| LVGL flush 缓冲 | 320×8×2 = 5120 | `ui_disp.c` | `MALLOC_CAP_DMA` + `MALLOC_CAP_INTERNAL`，失败逐半降行（最小 4 行） |
| SPI 收发静态缓冲 | 3 × 64 = 192 | `bsp/spi_driver/spi_driver.c` | `s_rx_dummy`/`s_rx_bounce`/`s_tx_bounce`，4 字节对齐（RX DMA 硬性要求） |
| SPI2 DMA 描述符 | 2 × 2 × 12 = 48 | IDF `spicommon_dma_desc_alloc` | 总线初始化时按 `max_transfer_sz` 预分配，TX/RX 各一份 |
| SPI 设备事务队列 | LCD 2×12×2 + SD 1×12×2 = 72 | IDF `spi_bus_add_device` | `xQueueCreate(queue_size, sizeof(spi_trans_priv_t))`，trans/ret 各一条；LCD 深度已由 7 收到 2 |
| `s_master`（`sync_master_s`） | 232 | `sync_protocol.c` | 模块单例静态变量（高频读写） |

> **SPI 总线约束**：`max_transfer_sz` 只按最大单笔传输设置（LCD 局部刷屏 320×8×2），
> 不要按整屏设置——它决定 IDF 在总线初始化时预分配的 DMA 描述符数量。
>
> 另外 ESP32 的 SPI DMA **只认内部 RAM**，且 RX 还要求缓冲起始地址 4 字节对齐
> （TX 无对齐要求，长度也不必对齐）。只要不满足，IDF 就会为**每一笔事务**从内部 DMA 堆
> 申请一份私有 bounce 缓冲；内部 RAM 耗尽时该分配失败，而驱动的错误清理路径会解引用
> 空指针直接 panic（`spi_common.c` 分配失败时不回写出参 → `spi_master.c`
> `setup_priv_desc` → `uninstall_priv_desc` 对 NULL 复制）。
>
> 这条约束在本项目里**真的会踩到**：FATFS 的扇区缓冲在 PSRAM
> （`CONFIG_FATFS_ALLOC_PREFER_EXTRAM=y`），ESP32 的 SPI DMA 到不了 PSRAM，所以每次
> SD 扇区读写都会申请一份 512B 内部缓冲。`bsp/spi_driver` 已改为自己做中转：DMA 可达
> （RX 另需 4 字节对齐）的缓冲直传，否则分块经静态对齐缓冲搬运。调用方不必关心 DMA
> 约束，也不会再有每笔事务的堆分配；代价是非直传传输被拆成 64B 一笔（SD 读一个扇区
> = 8 笔），带宽仍远高于音频需求。

## 7. 内部 RAM 用量实测

`idf.py size`（当前构建）：

| 段 | 大小(B) | 备注 |
| :--- | ---: | :--- |
| DRAM `.data` | 32395 | 已初始化数据 |
| DRAM `.bss` | 65288 | 未初始化数据 |
| **DRAM 合计** | **97683** | `dram0_0_seg` 段长 124580，段内余 26897 |
| IRAM | 115487 | 段长 131072，余 15585 |

链接期内部堆区间：`_heap_start = 0x3FFD7030` → `_heap_end = 0x40000000`，约 **164KB**
（含 `0x3FFE0000`–`0x40000000` 的 128KB 块）。

运行期用 `main/app_main.c` 的 `App_Log_Heap()` 在启动各节点打印三组余量：
`int`（`MALLOC_CAP_INTERNAL|MALLOC_CAP_8BIT`）、`dma`（`MALLOC_CAP_DMA|MALLOC_CAP_INTERNAL`）、
`psram`。其中 **`dma` 一栏最关键**：SPI 等外设驱动的收发缓冲只能落在这一区，
它见底就意味着任何一笔"驱动私有 bounce 缓冲"的分配都会失败（见第 6 节 SPI 总线约束）。

DRAM 静态占用最大的符号（`nm`，当前 ELF）：`a2dp_sink_local_param` 9680、
`sigmoid_table_5_8` 5680、`bta_hf_client_cb` 4372、`port_IntStack` 4192、
`g_cnxMgr` 3944、`bta_hf_client_co_cb` 3752、`s_io_buf`/`vflash_mem` 各 2048、`btm_cb` 1880、
`a2dp_source_local_param` 1752、`rfc_cb` 1700、`avdt_cb` 1696、`l2cb` 1392。

> 运行期：WiFi + 蓝牙协议栈启动后会再吃掉几十 KB 内部堆，
> 启动到 `bt_audio` 完成时内部堆仅剩个位数 KB（见《主音频节点开发过程.md》十三A 启动曲线）。
> 这正是"任务栈必须精打细算、大缓冲一律 PSRAM"的根本原因。
>
> 另一个关键约束是**分配顺序**：LVGL 的 widget/style 都是几百字节的小块
> `malloc`，当前 `CONFIG_SPIRAM_MALLOC_ALWAYSINTERNAL=0`，普通 `malloc` 优先落 PSRAM。
> 所以 `app_main()` 最先创建 `UI_Task`（`ui_init()` 只做硬件/LVGL 移植），主题与页面构建
> 在 UI 任务里执行——任务栈先占住，LVGL 的小对象不足时自动落 PSRAM 兜底。

## 8. 任务栈预算速查

| 类别 | 栈合计(B) | 位置 |
| :--- | ---: | :--- |
| App + 中间件常驻任务 | ~68608 | 内部 RAM |
| 按需 OTA 任务 | 12288 | 内部 RAM |
| ESP-IDF 内置任务 | ~37888 | 内部 RAM |
| 引导任务（峰值 1 个） | 3072~4096 | 内部 RAM |

## 9. 与设计文档 §6 的差异（历史记录）

> 《主音频节点软件构架分层设计.md》§6 已按当前代码同步为右列数值。下表保留的是
> **当初设计稿与实现的差异及调整原因**，用来说明这些参数为什么改成现在这样，不是待办。

以**代码实际值**为准（下表左为设计稿原值，右为当前代码）：

| 任务 | 设计 §6（优先级/栈/核） | 代码实际 | 说明 |
| :--- | :--- | :--- | :--- |
| `bt_audio_task` | 6 / 8192 / Core 1 | **11** / 4096 / **Core 1** | 用 `xTaskCreatePinnedToCore` 绑到 Core 1；栈按实测降到 4KB |
| `OTA_Task` | 11 / 8192 / Core 0 | 5 / 12288 / Core 0 | 宏 `OTA_TASK_PRIORITY=5`、`OTA_TASK_STACK_SIZE=12288` |
| `SyncTx_Task` | 11 / 8192 / Core 0 | 11 / **4096** / Core 0 | 组包缓冲移到 PSRAM 后栈可减半 |
| `SyncLocalPlay_Task` | 10 / 10240 / Core 1 | **12** / **4096** / Core 1 | 数据缓冲全在 PSRAM，栈再减；优先级提到 12（喂 I2S 消费端最高） |
| `LCD_Touch_Task` | 5 / 4096 / Core 1 | **3** / **2048** / **Core 0** | 栈上只有 6B 读缓冲，2KB 足够 |
| `MusicPlay_Task` | 9 / 4096 / Core 1 | 一致 | 原 `LocalPlay_Task` 改名而来 |
| `UI_Task` | 12 / 13312 / Core 1 | **10** / **32768** / **Core 0** | 栈最大，由 app_main 最先创建；**已从 Core 1 挪到 Core 0**（与音频实时链路分核，见 UI 优化记录） |
| `audio_decoder` | 10 / 8192 / Core 1 | 10 / **4096** / Core 1 | 单帧 PCM 4.6KB 已移出任务栈（PSRAM 优先） |
| `wifi_mcast_rx_Task` | 6 / 4096 / Core 0 | 6 / **6144** / Core 0 | |
| `SmartHome_Task` | 5 / 4096 / Core 0 | 一致 | |

设计文档 §6 未登记 `app_main` 的引导任务（`mp_boot`/`lc_boot`）与最先创建的
`UI_Task`，也把 `LCD_Touch_Task` 画成了固定绑核，实际实现见第 1、2 节。

## 10. 关键经验：大任务栈必须"先占位"

内部 RAM 紧张时，堆会被 WiFi/BT/I2S DMA/各任务栈逐步切碎：实测 `lc_boot` 之后
`free=12775` 但 `largest=6400`，到 `ui_init` 时只剩 `largest=4096` —— 这时再想建
32768B 的 `UI_Task` 必然失败（free 看起来够、最大连续块不够）。

所以**最大的那个任务栈要在启动最初分配**：`app_main()` 先建 `UI_Task`(32768B)，
它立刻阻塞等各模块就绪，等其它任务把堆切碎时这块内存已经握在手里。
`ui_run()` 打印的 `hwm_words`（栈高水位，×4 得字节数）用于复核栈是否给大了。

同理，`ui_init()` 不再内部建任务：调用方（UI 任务）在 `ui_init()` 成功后调用
`ui_run()` 进入渲染循环，避免"建任务"与"建页面"两个阶段互相挤占内部 RAM。

## 11. 维护约定

- 新增任务：先定"能不能不占任务栈"，再定栈大小；栈必须内部 RAM，且要计入第 8 节预算。
- 新增大缓冲：默认 `MALLOC_CAP_SPIRAM`，仅在第 4 节红线内才用内部 RAM。
- 队列/信号量：用 `xQueueCreateWithCaps` / `xSemaphoreCreateXxxWithCaps(MALLOC_CAP_SPIRAM)`。
- 改动后复测：`idf.py size` 看 DRAM 余量，运行期看 `heap_caps_get_free_size` +
  `heap_caps_get_largest_free_block`（`largest` 更能解释"为什么 free 够也建不出栈"）。
