currygood/MusicPlaySyncSpeakers/docs/04-测试/抓包与IGMP验证.md

目前已经解决了这个问题。

抓包发现速度，主节点发送挺快的，但是从节点一直都播放不了，从节点显示的日志：
I (60729) SP_SLAVE: [ctrl] PING=64 PONG=48 START=1 HB=33 PLAY=0 PAUSE=0 RESET=0
W (60729) SP_SLAVE: PONG t1=49881328 无匹配未决 PING，丢弃（未决 1 个，最新 t1=58881328）
W (62789) SP_SLAVE: PONG t1=51881363 无匹配未决 PING，丢弃（未决 1 个，最新 t1=61891320）
W (63799) SP_SLAVE: PONG t1=52891365 无匹配未决 PING，丢弃（未决 1 个，最新 t1=62881331）
W (64729) SP_SLAVE: PONG t1=53881329 无匹配未决 PING，丢弃（未决 1 个，最新 t1=62881331）
I (65739) SP_SLAVE: [status] state=1 stream=2 lock=0 rx=2502 ping=69 pong=52 lost=0 late=0 under=0ms jb=24/24 offset=+0us nd=0us err=+0us rate=44100
I (65739) SP_SLAVE: [ctrl] PING=69 PONG=52 START=1 HB=37 PLAY=0 PAUSE=0 RESET=0
W (65789) SP_SLAVE: PONG t1=54881328 无匹配未决 PING，丢弃（未决 1 个，最新 t1=64891330）
W (66679) SP_SLAVE: PONG t1=55881333 无匹配未决 PING，丢弃（未决 1 个，最新 t1=64891330）
W (67789) SP_SLAVE: PONG t1=56891365 无匹配未决 PING，丢弃（未决 1 个，最新 t1=66881328）
W (68729) SP_SLAVE: PONG t1=57891331 无匹配未决 PING，丢弃（未决 1 个，最新 t1=66881328）
W (69749) SP_SLAVE: PONG t1=58881328 无匹配未决 PING，丢弃（未决 1 个，最新 t1=67881328）
I (70759) SP_SLAVE: [status] state=1 stream=2 lock=0 rx=2776 ping=75 pong=57 lost=0 late=0 under=0ms jb=24/24 offset=+0us nd=0us err=+0us rate=44100
I (70759) SP_SLAVE: [ctrl] PING=74 PONG=57 START=1 HB=42 PLAY=0 PAUSE=0 RESET=0
