currygood/MusicPlaySyncSpeakers/docs/04-测试/测试计划.md

1. 功能性测试
2. 持续性测试（运行24小时等长期运行会不会崩）
3. 极端测试（不会有了）
