currygood/MusicPlaySyncSpeakers/docs/06-管理/项目计划与分工.md

1. 一号人物：主节点，最终测试和性能提示。
2. 二号人物：从节点，灯控节点。
