currygood/MusicPlaySyncSpeakers/.workbuddy/memory/2026-10-27.md

# 2026-10-27

## FreeType 中文字体接入（任务启动，Phase 0 完成）

目标：用阿里汉仪智能黑体 TTF + LVGL FreeType 运行时渲染，替掉 520 字烘焙子集
`ui_font_cn_16`，解决歌名/SSID 缺字。

Phase 0 已完成（只读诊断，未改代码、未编译、未上板）：

- 编码：UI 全部源文件 UTF-8（main/app_main.c 带 BOM，无害）；全仓库无 GBK/iconv
  转换代码。歌名来自 music_play.c:1327 的 FAT `ent->d_name`，蓝牙歌名来自 AVRCP
  （bt_audio.c:1059），SSID 来自 wifi scan 原始字节 → 均按 UTF-8 处理。
  结论：当前豆腐块是**字库覆盖不足**，不是编码问题，不需要先修编码。
- 烘焙字体实际是 NotoSansSC 16px，`line_height=19 / base_line=5`，
  `--symbols` 手工列举约 520 字 + 0x20-0x7E + 0xB7 起 65125 长度的稀疏区间。
  **全工程布局按 19px 行高硬编码**（如 scr_settings.c 的 `SYNC_ROW_H=19`），
  新字体 16px 行高 23 → 行高适配是 Phase 4 的主要工作量。
- 静态基线：app bin 2,341,872 B（4MB 槽 55.8%）；.dram0.data 22,607 +
  .dram0.bss 66,280；.iram0.text 114,463；.flash.rodata 562,824（含烘焙字体）；
  storage 分区 7,602,176 B，镜像内仅 3 张 PNG 共 10,490 B。
- sdkconfig 实况与任务书有出入：`CONFIG_LV_CACHE_DEF_SIZE=16384`（不是 0），
  `CONFIG_LV_USE_FREETYPE` 未开，`LV_USE_OS=0`，`SPIRAM_MALLOC_ALWAYSINTERNAL=0`，-Og。
- 环境：fontTools 4.65.0 + Pillow 12.3.0 只在 `F:\python3.10.1\python`（默认
  python 3.13 没有）；组件仓库可达，`espressif/freetype 2.14.3~1` 可下载但本地未缓存。
- 发现缺陷：`ui_run()` 的 hwm_words 打印在 `ui_pages_create()` **之前**，测不到
  真实峰值，需要把打印挪到页面构建之后才有基线意义。
- 构建注意：components/App/CMakeLists.txt 用 `file(GLOB_RECURSE)` 且无
  `CONFIGURE_DEPENDS`，新增 ui_font.c 后必须 reconfigure 才会被纳入编译。

## Phase 1 完成：字体资产已生成并通过校验

产物（全部已落盘）：
- `Play_Master/tools/font/make_ui_font_charset.py` → `ui_font_chars.txt`（6878 字）
- `Play_Master/tools/font/make_ui_font.py`（subset + 校验 + 写 meta，可 `--verify-only`）
- `Play_Master/storage/font/ui_font.ttf` 1,542,592 B，SHA256 `6CD9AB6F...2518E`
- `Play_Master/storage/font/ui_font.meta`
- `docs/07-许可/所用开源/阿里汉仪智能黑体-授权说明.md`（商用结论标"待确认"）

校验结果（与任务书预期逐项吻合）：size 偏差 0.00%、numGlyphs 6990、cmap 28,600 B、
GB2312 6763/6763、ASCII 95/95、TTF 魔数 0x00010000。

关键发现：
1. **源字体不含 U+23ED/23EE/23F8/25B6（⏭⏮⏸▶）**，子集产物必然没有；UI 里这些符号
   只出现在注释，实际图标走 ui_icons PUA 码位。校验器已改为区分「源字体缺失」与
   「子集丢字」，后者才 FAIL，避免掩盖真 bug。
2. **行高口径有分歧，必须以实测为准**：任务书给的 17/20/23/28 是 PIL 的
   ascent+descent 口径；LVGL 用的是 `face->size->metrics.height>>6`
   （lv_freetype.c:232），按 hhea(asc 1001/desc -326/upem 1000) 推算应为
   **15 / 18 / 21 / 26**。Phase 3 的 ui_font_init 会打印实测 line_height，
   Phase 4 布局按实测收口，先按保守（大）值预留。
3. 缺字行为已实测：不在字体里的字（囧/喆/堃/玥/镕/犇/龘）渲染成 notdef 方框
   （同一 ink=126），不崩溃、不留空 —— Phase 5 的"可预期"要求天然满足。
4. **`sdkconfig` 被 .gitignore 忽略且无 sdkconfig.defaults** → Phase 2 打开的
   FreeType 开关不会进版本库，换机/新克隆会退化成未开启。需要决定是否新增
   sdkconfig.defaults（已列入 Phase 2 待确认项）。

## Phase 2 改动（代码已就绪，等上板验证）

用户决定：**sdkconfig 纳入 git**（不是新增 sdkconfig.defaults）。
- `.gitignore` 删除 `sdkconfig` 忽略行（保留 `sdkconfig.old`），`git add` 已暂存。

改动清单：
- `Play_Master/main/idf_component.yml`：加 `espressif/freetype: "^2.14.3"` 直接依赖
- `Play_Master/sdkconfig`：`CONFIG_LV_USE_FREETYPE=y`、
  `CONFIG_LV_FREETYPE_USE_LVGL_PORT` 关闭、`CACHE_FT_GLYPH_CNT=128`、`CACHE_FT_GLYPH_L1=y`
- `ui.c`：栈水位改为在 `ui_pages_create()` 之后采样；新增 PHASE2 切页首帧计时
  （`s_navT0` + `lv_refr_now` + `[PHASE2] page N first frame`）
- `scr_settings.c`：`section_add()` 增加 font 参数；新增 `settings_title_font()`
  只为"固件"标题创建 16px FreeType 字体，并打印创建耗时 / line_height / base_line / 堆余量

必须整片烧录（含 storage 分区），否则 `/storage/font/ui_font.ttf` 不存在。
关键待验证风险：espressif/freetype 若禁用 ANSI stdio 流（FT_CONFIG_OPTION_DISABLE_STREAM_SUPPORT），
`LV_FREETYPE_USE_LVGL_PORT=n` 下按路径打开会失败；届时备选方案是开启 LVGL port（注意
FT_Stream_Open 重复符号风险，需查 map 确认来源）。

## Phase 2 上板失败 → 根因定位 + 修法（2026-10-27 晚）

上板日志暴露两个严重问题，都发生在 FreeType 打开 face 期间：
1. `task_wdt`：CPU0 被 UI_Task 占住 >5s（IDLE0 饿死），tcpip 那一次也是同一原因；
   backtrace 明确停在 `FT_New_Face → tt_face_load_hmtx → ft_ansi_stream_io → fseek
   → vfs_spiffs_lseek`。
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
