currygood/MusicPlaySyncSpeakers/.workbuddy/memory/2026-10-28.md

# 2026-10-28

## 设置页切页：650ms 单帧渲染 + UI_Task 栈溢出（第三次崩溃）

日志：
```
[REFR] page 1 done in 650885 us
stack[after render]: headroom=5980 B, used<=6308 B, stack=12288 B
***ERROR*** A stack overflow in task UI_Task
backtrace: _xt_lowint1 -> _frxt_int_exit -> _frxt_dispatch -> vTaskSwitchContext
           -> vApplicationStackOverflowHook (port.c:573)
```

判定：
- 650ms 是**一次**整屏渲染（REFR_READY 在 lv_refr.c:458，是 lv_display_refr_timer
  最末尾发出的，即所有 area 都渲染+flush 完之后）。
- 已排除的因素：LV_USE_LOG/ASSERT/PERFMON 全关；无 shadow；卡片只有 radius8+border1；
  SPI = LCD_TOUCH_SPI_FREQ_HZ **15MHz**（全屏 153KB → 物理下限 ~82ms）。
- 因此 ~500ms 落在 LVGL 软件绘制（-Og）+ 首次字形光栅化。工程全局是
  CONFIG_COMPILER_OPTIMIZATION_DEBUG（-Og），这是主要可优化项。
- 栈溢出机制：ESP32 上**中断使用被打断任务自己的栈**。12288 在 REFR_READY 仍有
  5980B 余量，但 level-1（WiFi/BT MAC）中断落在 LVGL/FreeType 最深调用链上时
  把栈底 canary 压穿 → vTaskSwitchContext 检测到 → abort。
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
