currygood/MusicPlaySyncSpeakers/docs/02-设计/ui_img/Music_Album.png

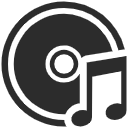
docs/02-设计/ui_img/Music_Album.png
