currygood/MusicPlaySyncSpeakers/ProductShow/Img/主节点-UI-播放页面.jpg

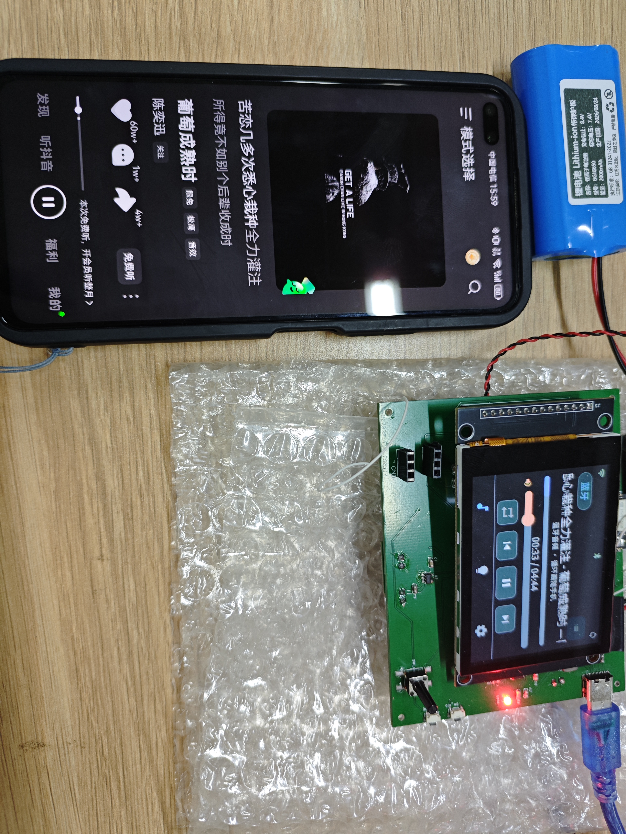
ProductShow/Img/主节点-UI-播放页面.jpg
