currygood/MusicPlaySyncSpeakers/ProductShow/Img/主节点-UI-灯控页面.jpg

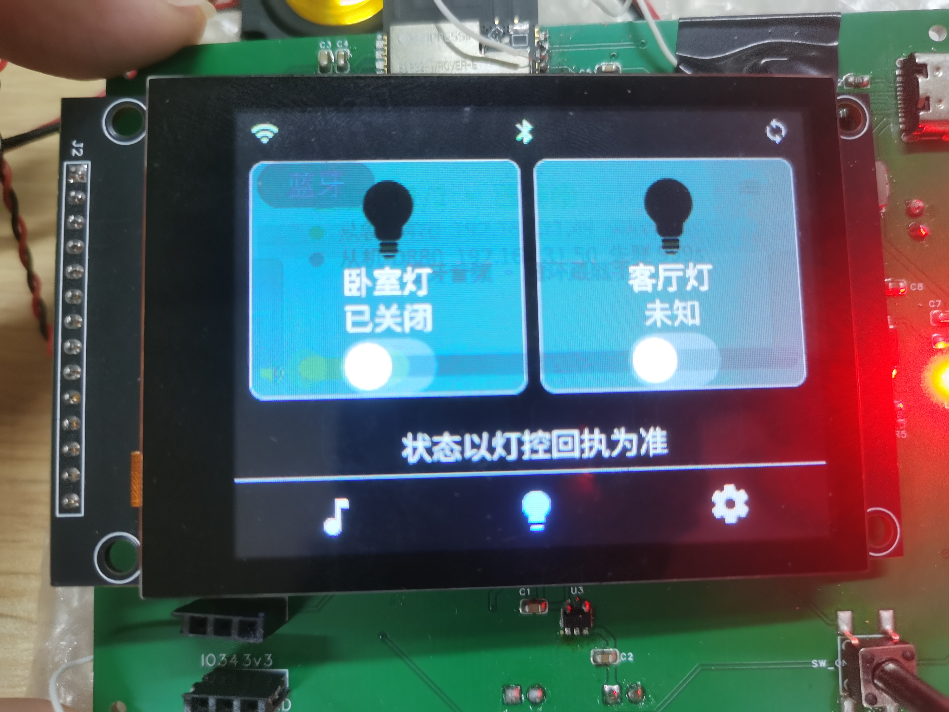
ProductShow/Img/主节点-UI-灯控页面.jpg
