currygood/MusicPlaySyncSpeakers/ProductShow/Img/主节点-UI-设置页面-1.jpg

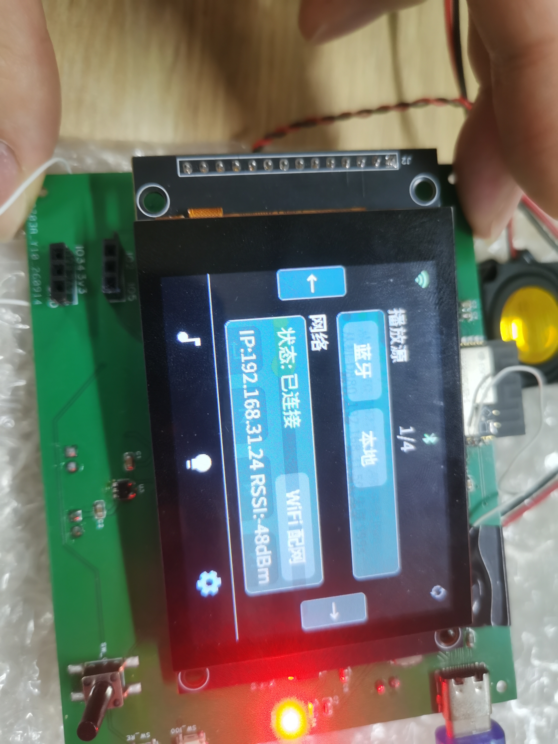
ProductShow/Img/主节点-UI-设置页面-1.jpg
