currygood/MusicPlaySyncSpeakers/ProductShow/Img/灯控-ESP8266-1.jpg

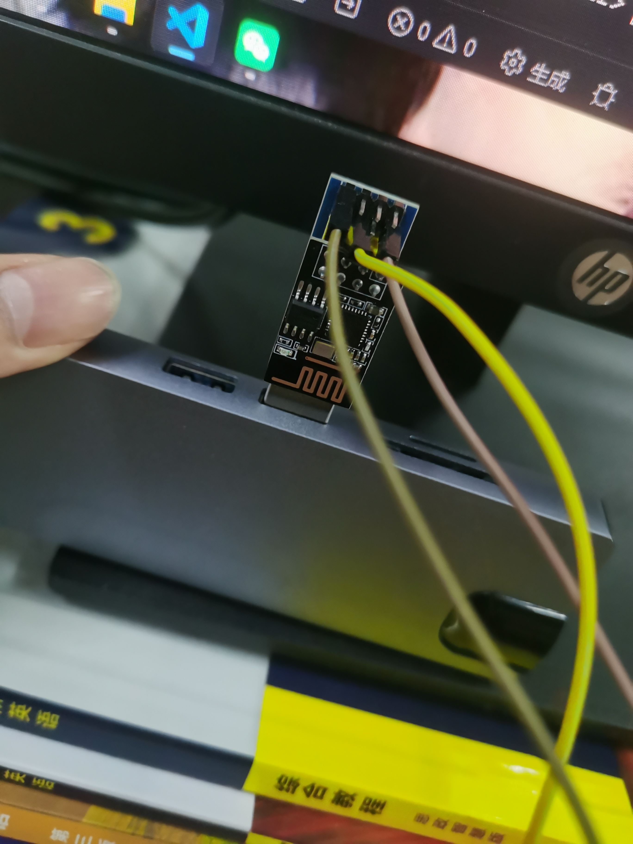
ProductShow/Img/灯控-ESP8266-1.jpg
