currygood/MusicPlaySyncSpeakers/ProductShow/Img/灯控-ESP8266-2.jpg

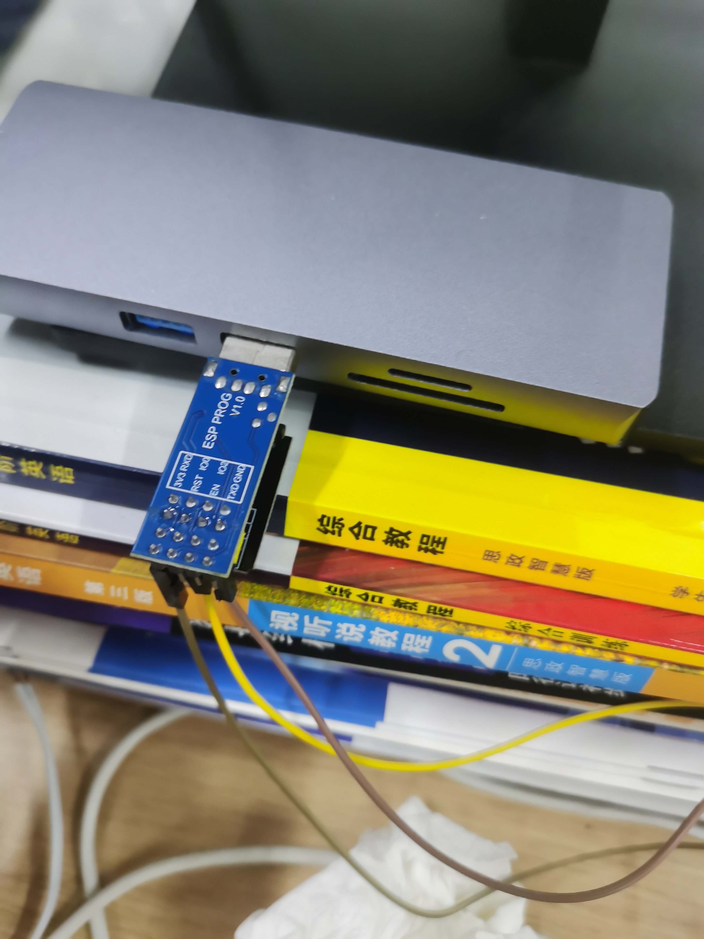
ProductShow/Img/灯控-ESP8266-2.jpg
