currygood/MusicPlaySyncSpeakers/ProductShow/Img/灯控-继电器.jpg

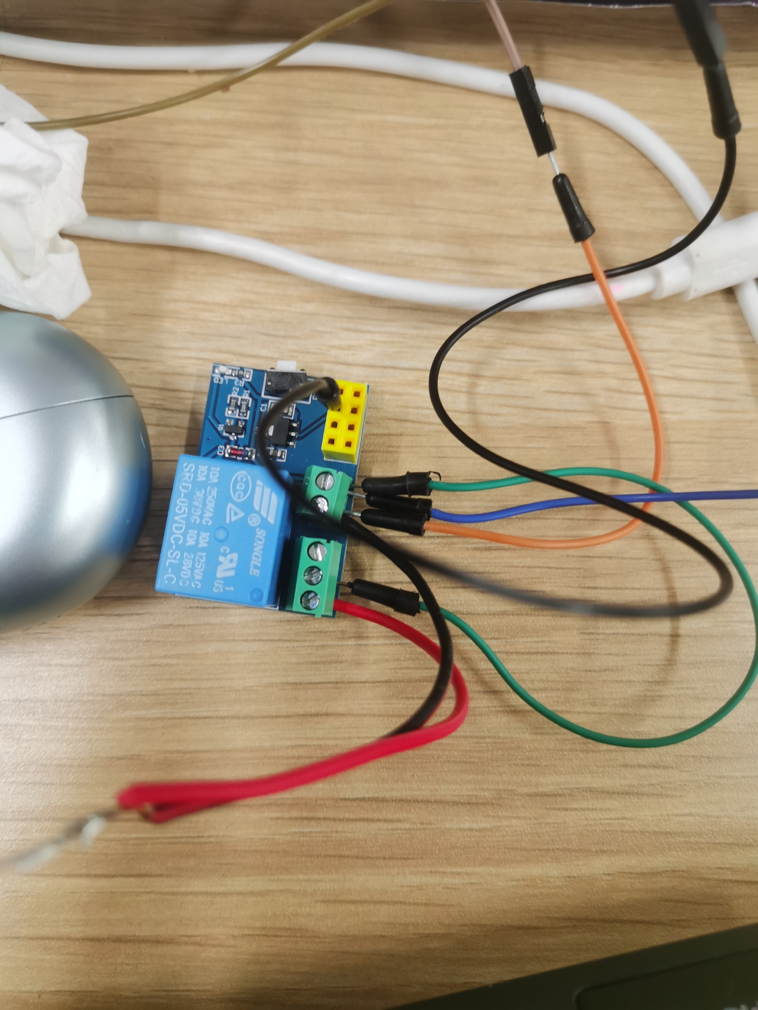
ProductShow/Img/灯控-继电器.jpg
