currygood/MusicPlaySyncSpeakers/note/板子设计不合理的地方-对于调试阶段.md

如果想要让ai自己去编译烧录，然后监控串口等，就需要一直按着这个开关机按键，不可能的，一直按着就做不了别的事情了。为什么要一直按着：如果不按着也就没有电，因为烧录和监控串口启动的时候esp32是不能通过拉低控制引脚让电通过电源模块一直进MCU和外围电路。

解决办法，开发调试测试阶段板子上多加一个开关，不需要按着就一直有电了。
