currygood/MusicPlaySyncSpeakers/docs/04-测试/主节点测试出的bug.md

> data：2026-10-20
>

1. UI上按切换单曲循环，蓝牙播放还是不变（手机上还是一样，那播放还是按照手机那样的来）；sd卡播放的没问题。->OVER
2. 本地播放的时候，暂停后再播放，会重新从歌曲的最前面播放->OVER
3. 连接蓝牙后，在UI上切换为本地播放，还是会继续蓝牙播放**->这个因为设计就这样**
4. 断掉蓝牙后切换为本地播放，本地播放的声音很卡->OVER
5. UI-wifi图标状态没切换->OVER
6. UI进行切换的时候播放sd卡音乐真的卡，不过好像没什么办法可以避免，共用一条总线，改不了，也不够引脚用了，无法再弄一个总线，只能无限性能调优。
7. 当LCD屏幕刷新不一样的帧的时候就会导致sd卡音乐播放卡顿，然后就会加速，追回来之后才变为正常速度
   **6和7共性问题，都是LCD和SD卡共用同一个SPI总线，必定会有点卡，只能优化到能接收的地步。**
   去掉Microphone相关的所有东西（esp-sr语音唤醒）之后就很流畅了，6和7的解决了，大概率是因为这个芯片的语音唤醒不怎么样，占用了很多CPU时钟！！！
8. sd卡一首歌快播放完的时候就会一直嗡嗡嗡响，直到下一首歌解析到->OVER
9. UI配网问题->OVER
10. sd卡播放的时候UI显示的播放时长不对->OVER
11. 固件版本显示不对->OVER
12. 设置页面的网络连接那里，WIFI配网控件把RSSI的数值显示挡住了->OVER

> data:2026-10-24

13. 在可以进行主从同步播放后（修好同步播放后），主节点连接蓝牙播放，只能听到“吱吱吱”的声音。->OVER
14. 播放着播放着就“卡死”，手机是一直在显示播放着的，蓝牙也没掉，一直给主节点发音频，主节点没有日志打印，看门狗没开，大概率是死锁了。->OVER

> data:2026-10-28

15. 弄好矢量字体库解析显示正确中文后，获取sd卡的音乐还是一样显示乱码（跟没弄字体库之前一样的显示），但是连接蓝牙播放显示的就绝大部分字不会。这个我感觉是因为从sd卡上获取的就是乱码了，交给FreeType的文字就是乱码，导致无法进行计算后显示->OVER

> data:2026-10-29

16. 电脑连接蓝牙播放的时候，UI上无法显示播放的歌曲信息（网易云的无法显示），用网页版b站播放的可以显示标题名。而且用电脑播放，因为电脑是48的，不是44.1，在终端上转换为44.1之后呢就变得很低音，而且有比较小声的“吱吱吱”。经过最终排查，吱吱吱是因为喇叭。。。。->OVER

查看`主节点bug解决.md` 得知bug原因和解决办法
