currygood/MusicPlaySyncSpeakers/Play_Master/main/app_main.c

/**
 * @file app_main.c
 * @brief 主音频节点应用入口（十三A阶段：最终整合）
 *
 * 启动流程（《主音频节点开发过程》十三A阶段）：
 *   app_main:
 *     1) nvs_flash_init → node_role_init（NVS 唯一入口，WiFi/OTA 参数来源）
 *     2) wifi_manager_create/start → 等待拿到 IP
 *     3) OTA_Update_Init + CheckAndUpgrade（有新固件则下载校验后重启；无则继续）
 *     4) Amplifier_Init（功放 TX 物理链路；麦克风 RX 已随语音唤醒功能一并下线）
 *     5) 串行创建各功能任务（前一个 boot 任务跑完退出后再建下一个，
 *        避免多个 boot 栈同时占内部 DRAM；依赖关系经事件组就绪位衔接）：
 *        MusicPlay    : SD 卡 + 组播通道 + bt_audio + music_play_create（内部建 MusicPlay_Task）
 *        LightControl : 等 wifi 就绪 → 灯控组播通道 + light_control_create（内部建 SmartHome_Task）
 *        UI           : 等各句柄就绪 → ui_init（LCD/触摸屏，内部建 UI_Task）
 *
 * 启动时序（播放与显示的顺序，2026-10 调整）：
 *   音乐模块只做"准备"不做"起播"——SD 卡挂载、蓝牙建链、列表扫描都在 UI 之前完成，
 *   但自动源选择切到本地源时**不自动播放**（music_play_set_autoplay 闸门默认关闭）。
 *   UI 页面构建完 + 首帧真正刷完时，ui_run 回调 ui_set_ready_cb 注册的
 *   App_Ui_Ready_Cb，这里才放行 SD 卡起播。效果：屏幕先亮出播放页，音乐随后响起，
 *   不再出现"黑屏先出声"。UI 不可用（ui_init 失败/任务建不起来）时直接放行兜底。
 *
 * 线程/内存约定（见 note/MusicPlay调试笔记.md）：
 *   - main_task 栈仅 3584B，SD/蓝牙/LVGL 等重活一律单独起任务；
 *   - 内部 DRAM 是最稀缺资源（WiFi+BT 已占 ~90KB，见调试笔记 3.1 曲线）：
 *     非 DMA 的大缓冲 / 队列 / 信号量 / 模块句柄一律进 PSRAM，只有任务栈、
 *     中断上下文与 DMA 描述符留内部 RAM；boot 任务用完即退出回收栈；
 *   - 任务间只共享句柄与就绪事件位，模块内部常驻任务由各模块 create 自建。
 */

#include <stdio.h>
#include <stdbool.h>
#include <string.h>

#include "freertos/FreeRTOS.h"
#include "freertos/task.h"
#include "freertos/event_groups.h"

#include "esp_err.h"
#include "esp_log.h"
#include "esp_system.h"
#include "esp_psram.h"
#include "esp_heap_caps.h"
#include "esp_timer.h"
#include "esp_clk_tree.h"
#include "nvs_flash.h"
#include "i2c_driver.h"

#include "StartAndStop.h"
#include "node_role.h"
#include "wifi_manager.h"
#include "OTA_Update.h"
#include "amplifier.h"
#include "sd_card.h"
#include "bt_audio.h"
#include "sync_protocol.h"
#include "music_play.h"
#include "light_control.h"
#include "ui.h"

#define APP_MAIN_LOG (false)

#if APP_MAIN_LOG
static const char *TAG = "AppMain";
#endif

/* ======================== 任务就绪事件位 ======================== */
/* 各模块初始化在独立任务里完成，依赖方用事件组等待上游就绪 */

#define APP_EVT_WIFI_READY   (1 << 0)   /* wifi_manager 已连接并拿到 IP */
#define APP_EVT_BT_READY     (1 << 1)   /* bt_audio 已创建并启动 */
#define APP_EVT_MUSIC_READY  (1 << 2)   /* music_play 已创建 */
/* (1 << 3) 曾用于 call_phone，语音唤醒功能已下线，位号留空不复用，避免与旧日志混淆 */
#define APP_EVT_LIGHT_READY  (1 << 4)   /* light_control 已创建 */

/* 失败位：供依赖方不再无限等待（值为高位，避免与就绪位混淆） */
#define APP_EVT_BT_FAILED    (1 << 8)
#define APP_EVT_MUSIC_FAILED (1 << 9)
/* (1 << 10) 原 APP_EVT_CALL_FAILED，同上留空 */
#define APP_EVT_LIGHT_FAILED (1 << 11)

/* ======================== 常量 ======================== */

/** 蓝牙广播名（主节点） */
#define APP_BT_DEVICE_NAME      "MPS-Sync-Speaker"

/** 灯控组播通道（分层设计 3.4.2：239.0.0.2:8889，代码常量不入 NVS） */
#define APP_LIGHT_MCAST_GROUP   "239.0.0.2"
#define APP_LIGHT_MCAST_PORT    8889

/** WiFi 等待 IP 超时（轮询 100ms x 200 = 20s） */
#define APP_WIFI_WAIT_TRIES     200

/** 各 boot 任务栈/优先级（mp/lc 创建完即退出；UI 任务常驻，见下）
 *
 *  boot 任务必须高于解码(10)/同步(11)：解码节流在"恰好追平"时余量 <1ms
 *  不再 vTaskDelay（连续不让步），prio 5 的 boot 任务会被饿死——实测表现
 *  为 boot 任务 60s 内既不就绪也不失败，UI 只能陪等满 60s 超时后才出屏 */
#define APP_BOOT_TASK_PRIO      10
#define APP_MUSIC_TASK_PRIO     11
#define APP_LIGHT_TASK_PRIO     9

#define APP_MUSIC_TASK_STACK    4096
#define APP_LIGHT_TASK_STACK    3072
/* UI 任务栈最大，必须趁内部堆还没被 WiFi/BT/其它任务切碎时最先创建；
 * 大小由 UI 模块统一给出（components/App/UI/ui.h 的 UI_TASK_STACK_BYTES）：
 * FreeType 接入后实测峰值 7.9KB，原 10240 只剩 2.3KB 余量，已提到 16384。
 * 实际水位看 ui_run() 打印的 "stack after pages built" 与切页时的 hwm。 */
#define APP_UI_TASK_STACK       UI_TASK_STACK_BYTES
/* UI 优先级 12 → 10。
 *
 * 原值 12 比 SyncTx(11) 还高，而这两个任务都在 core 0：LVGL 用 10MHz SPI
 * 刷一整屏要 ~123ms（320×240×2B），期间 UI 反复唤醒、每次占住 core 0
 * 几毫秒，SyncTx 的 15ms 发包节拍就被推后 → 本地延迟队列少填几帧。
 * 播放路径本来就只有 200ms 余量，再被刷屏蹭掉一截，就会周期性露底。
 *
 * UI 是人眼任务（10ms 周期），降到 10 手感无差别，但把 core 0 的 CPU
 * 让给了音频发包。 */
#define APP_UI_TASK_PRIO        10

/** 依赖等待超时（ms）：上游异常时避免永久挂起 */
#define APP_DEP_WAIT_MS         60000

/** 非关键依赖等待超时（ms）：UI 最多只等这么久，超时按占位降级先出屏
 *  （light_control 晚到不影响显示与本地/蓝牙播放控制） */
#define APP_OPT_WAIT_MS         10000

/* ======================== 全局运行上下文 ======================== */

/** 各任务共享的句柄与就绪事件组（只写一次、读取方判空） */
typedef struct {
    EventGroupHandle_t     evt;         /* 就绪/失败事件位 */
    wifi_manager_handle_t  wifi;
    bt_audio_handle_t      bt;
    wifi_mcast_handle_t    audio_chan;  /* 音频通道 239.0.0.1:5678（只发） */
    wifi_mcast_handle_t    control_chan;/* 控制通道 239.0.0.1:5679（收发） */
    wifi_mcast_handle_t    light_chan;  /* 灯控通道 239.0.0.2:8889（收发） */
    music_play_handle_t    music;
    light_control_handle_t light;
    bool                   ui_ready;    /* UI 首帧已出屏（放行 SD 卡自动起播的闸门） */
} app_ctx_t;

static app_ctx_t s_app;

/**
 * HFP 下行单声道 → 立体声扩展缓冲（bt_audio 任务上下文，非 ISR/DMA）
 *
 * 内部 DRAM 是最稀缺资源（WiFi + BT 已占 ~90KB）：这类"大数据缓冲"一律放
 * PSRAM，只把任务栈 / DMA 描述符留给内部 RAM。分配失败时回退内部 RAM。
 */
#define APP_HFP_DN_STEREO_SAMPLES  2048
static int16_t *s_hfpDnStereoBuf = NULL;

/* ======================== 通用工具 ======================== */

/**
 * 打印内部 DRAM / DMA 可用内部 RAM / PSRAM 余量（内存紧张时定位用，见调试笔记）
 *
 * "dma" 那一栏最关键：SPI 等外设驱动的收发缓冲只能落在
 * MALLOC_CAP_DMA | MALLOC_CAP_INTERNAL 区，这一栏一旦见底，任何一笔
 * "驱动私有 bounce 缓冲"的分配都会失败（原因见 spi_driver.c 顶部说明）。
 */
static void App_Log_Heap(const char *stage)
{
#if APP_MAIN_LOG
    ESP_LOGI(TAG, "[heap] %s: int free=%u largest=%u | dma free=%u largest=%u | psram free=%u",
             stage,
             (unsigned)heap_caps_get_free_size(MALLOC_CAP_INTERNAL | MALLOC_CAP_8BIT),
             (unsigned)heap_caps_get_largest_free_block(MALLOC_CAP_INTERNAL | MALLOC_CAP_8BIT),
             (unsigned)heap_caps_get_free_size(MALLOC_CAP_DMA | MALLOC_CAP_INTERNAL),
             (unsigned)heap_caps_get_largest_free_block(MALLOC_CAP_DMA | MALLOC_CAP_INTERNAL),
             (unsigned)heap_caps_get_free_size(MALLOC_CAP_SPIRAM));
#endif
}

/**
 * @brief 等待事件位（就绪位或失败位任一即可唤醒），超时仅告警
 *
 * @param bits       关心的位（就绪 | 失败）
 * @param timeout_ms 超时（ms）
 * @param what       日志用名称
 * @return 已置位的事件位
 */
static EventBits_t App_Wait_Bits(EventBits_t bits, uint32_t timeout_ms, const char *what)
{
    int64_t     t0  = esp_timer_get_time();
    EventBits_t got = xEventGroupWaitBits(s_app.evt, bits, pdFALSE, pdFALSE,
                                          pdMS_TO_TICKS(timeout_ms));
    uint32_t    elapsed_ms = (uint32_t)((esp_timer_get_time() - t0) / 1000);
    (void)elapsed_ms;
    if ((got & bits) == 0)
    {
#if APP_MAIN_LOG
        ESP_LOGW(TAG, "wait %s timeout after %u ms (%u ms budget)",
                 what, (unsigned)elapsed_ms, (unsigned)timeout_ms);
#endif
    }
    else
    {
        /* 就绪耗时打点：启动期瓶颈定位（哪个模块/哪段等待拖慢了 UI） */
#if APP_MAIN_LOG
        ESP_LOGI(TAG, "wait %s ok in %u ms (bits=0x%lx)", what,
                 (unsigned)elapsed_ms, (unsigned long)(got & bits));
#endif
    }
    return got;
}

/**
 * @brief 创建 boot 引导任务，创建失败必须显式上报
 *
 * 内部 RAM 紧张时 xTaskCreatePinnedToCore 会返回失败；此前未检查返回值，
 * UI 引导任务静默消失（无任何日志），排查代价很高（见十三A记录）。
 * 失败时同步置 FAILED 位，依赖方不必等满超时即可降级继续。
 */
static bool App_Boot_Task_Create(TaskFunction_t entry, const char *name,
                                 uint32_t stack_bytes, UBaseType_t prio, BaseType_t core,
                                 EventBits_t failed_bit)
{
    if (xTaskCreatePinnedToCore(entry, name, stack_bytes, NULL, prio,
                                NULL, core) == pdPASS)
    {
        return true;
    }
#if APP_MAIN_LOG
    ESP_LOGE(TAG, "[boot] %s create failed (stack=%u, int free=%u largest=%u)",
             name, (unsigned)stack_bytes,
             (unsigned)heap_caps_get_free_size(MALLOC_CAP_INTERNAL | MALLOC_CAP_8BIT),
             (unsigned)heap_caps_get_largest_free_block(MALLOC_CAP_INTERNAL | MALLOC_CAP_8BIT));
#endif
    xEventGroupSetBits(s_app.evt, failed_bit);
    return false;
}

/* ======================== WiFi ======================== */

/** wifi_manager 事件回调：仅打印状态变化 */
static void App_Wifi_Evt_Cb(const wifi_mgr_event_t *evt, void *ctx)
{
    (void)ctx;
    if (evt == NULL)
    {
        return;
    }

    switch (evt->id)
    {
    case WIFI_EVT_CONNECTED:
#if APP_MAIN_LOG
        ESP_LOGI(TAG, "[wifi] CONNECTED ip=%s rssi=%d", evt->ip, evt->rssi);
#endif
        break;
    case WIFI_EVT_DISCONNECTED:
#if APP_MAIN_LOG
        ESP_LOGW(TAG, "[wifi] DISCONNECTED");
#endif
        break;
    case WIFI_EVT_RECONNECTING:
#if APP_MAIN_LOG
        ESP_LOGI(TAG, "[wifi] RECONNECTING");
#endif
        break;
    case WIFI_EVT_IP_CHANGED:
#if APP_MAIN_LOG
        ESP_LOGI(TAG, "[wifi] IP_CHANGED ip=%s", evt->ip);
#endif
        break;
    default:
        break;
    }
}

/** 初始化 wifi_manager 并等待拿到 IP（凭据由 wifi_manager 经 node_role 读取） */
static void App_Wifi_Start(void)
{
    wifi_manager_cfg_t cfg = {
        .max_retries = 3,   /* 连接失败 3 次后放弃，等用户通过 UI 配网 */
    };
    esp_err_t          err;

    s_app.wifi = wifi_manager_create(&cfg);
    if (s_app.wifi == NULL)
    {
#if APP_MAIN_LOG
        ESP_LOGE(TAG, "wifi_manager_create failed");
#endif
        return;
    }
    wifi_manager_register_event_cb(s_app.wifi, App_Wifi_Evt_Cb, NULL);

    err = wifi_manager_start(s_app.wifi);
    if (err != ESP_OK)
    {
#if APP_MAIN_LOG
        ESP_LOGE(TAG, "wifi_manager_start failed: %s", esp_err_to_name(err));
#endif
        return;
    }
#if APP_MAIN_LOG
    ESP_LOGI(TAG, "connecting to AP, waiting for IP ...");
#endif

    for (int i = 0; i < APP_WIFI_WAIT_TRIES; i++)
    {
        if (wifi_manager_is_connected(s_app.wifi))
        {
            char   ip[16] = {0};
            size_t ip_len = sizeof(ip);
            if (wifi_manager_get_ip(s_app.wifi, ip, &ip_len) == ESP_OK)
            {
#if APP_MAIN_LOG
                ESP_LOGI(TAG, "wifi connected: ip=%s rssi=%d",
                         ip, wifi_manager_get_rssi(s_app.wifi));
#endif
            }
            xEventGroupSetBits(s_app.evt, APP_EVT_WIFI_READY);
            return;
        }
        vTaskDelay(pdMS_TO_TICKS(100));
    }

#if APP_MAIN_LOG
    ESP_LOGE(TAG, "wait IP timeout (请检查 NVS 中的 SSID/密码)");
#endif
}

/* ======================== OTA ======================== */

#if APP_MAIN_LOG
static const char *App_Ota_Evt_Name(ota_update_event_t evt)
{
    switch (evt)
    {
    case OTA_UPDATE_EVT_CHECK_STARTED:     return "CHECK_STARTED";
    case OTA_UPDATE_EVT_UP_TO_DATE:        return "UP_TO_DATE";
    case OTA_UPDATE_EVT_UPDATE_AVAILABLE:  return "UPDATE_AVAILABLE";
    case OTA_UPDATE_EVT_DOWNLOAD_STARTED:  return "DOWNLOAD_STARTED";
    case OTA_UPDATE_EVT_DOWNLOAD_PROGRESS: return "DOWNLOAD_PROGRESS";
    case OTA_UPDATE_EVT_DOWNLOAD_FINISHED: return "DOWNLOAD_FINISHED";
    case OTA_UPDATE_EVT_READY_TO_REBOOT:   return "READY_TO_REBOOT";
    case OTA_UPDATE_EVT_ABORTED:           return "ABORTED";
    default:                               return "?";
    }
}
#endif

/** OTA 事件回调：打印状态/进度（正式 UI 展示后续接入） */
static void App_Ota_Evt_Cb(const ota_update_event_info_t *info, void *ctx)
{
    (void)ctx;
    if (info == NULL)
    {
        return;
    }
#if APP_MAIN_LOG
    ESP_LOGI(TAG, "[ota] %s version=%s progress=%d%% http=%d",
             App_Ota_Evt_Name(info->event), info->version,
             info->progress_percent, info->http_status);
#endif
}

/**
 * @brief WiFi 就绪后检查是否需要 OTA 升级
 *
 * 有新固件：模块内部下载→校验 SHA256→切换分区→esp_restart()（不返回）；
 * 已是最新或检测失败：记录日志后继续往下启动。
 */
static void App_Ota_Check(void)
{
    ota_update_config_t cfg = {0};
    esp_err_t           err;

    cfg.event_cb = App_Ota_Evt_Cb;
    err = OTA_Update_Init(&cfg);
    if (err != ESP_OK)
    {
#if APP_MAIN_LOG
        ESP_LOGE(TAG, "OTA_Update_Init failed: %s", esp_err_to_name(err));
#endif
        return;
    }

#if APP_MAIN_LOG
    ESP_LOGI(TAG, "checking OTA ...");
#endif
    err = OTA_Update_CheckAndUpgrade();
    if (err == ESP_OK)
    {
#if APP_MAIN_LOG
        ESP_LOGI(TAG, "OTA: firmware up to date, continue boot");
#endif
    }
    else
    {
#if APP_MAIN_LOG
        ESP_LOGW(TAG, "OTA check failed (%s), continue boot", esp_err_to_name(err));
#endif
    }
}

/* ======================== 蓝牙 PCM / 事件胶水 ======================== */

/* ======================== 临时诊断：A2DP PCM 自检（定位完删掉） ==================== */

/**
 * 蓝牙"吱吱吱/蹦蹦蹦"排查用：统计 A2DP PCM 流的块率/采样率/峰值
 *
 *   samp/s  期望 = 44100 帧 × 2 声道 = 88200 个 int16/s
 *   peak    期望 2000~26000（真实音乐）；≈0 = 没声音；≈32000 且随机 = 满量程噪声
 *
 *   (a) samp/s≈88200 + peak 正常  → PCM 没问题，问题在 sync/I2S 下游
 *   (b) samp/s≈96000             → 手机实际发 48k（元数据骗人），入口环会涨满
 *   (c) peak≈32000 且跳变剧烈     → 采样错位/格式不符（半个 int16 拼接）
 *   (d) peak≈0                   → 手机没送音频 / SBC 解码没出数
 *
 * drop  = A2DP FIFO 溢出丢的字节数（应恒为 0；涨说明消费端被拖住）
 * resync= 因字节错位复位整条流的次数（应恒为 0）
 * ingress = sync 入口环已用字节 / 容量（持续接近容量说明生产快于消费）
 */
#define APP_BT_PCM_DIAG  1

/** sync 入口环容量（与 sync_protocol 的 SYNC_CFG_DEFAULT_INGRESS_BYTES 一致，仅用于日志显示） */
#define APP_BT_INGRESS_CAP  65536u

#if APP_BT_PCM_DIAG
/**
 * @brief A2DP PCM 诊断计数（采集与打印严格分离）
 *
 * **为什么必须分离**：本文件的回调跑在 bt_audio 任务的 A2DP PCM 回调里，
 * 一行 ~190 字节的日志在 115200 波特下要阻塞约 16ms。原先每秒在这里打一行，
 * 等于每秒往音频回调里塞一个 16ms 的洞 —— 直接表现为 gap/un 指标恶化
 * （实测 gap=92ms、un=4），而且让音频线程长期处于"不可预期阻塞"状态。
 * 诊断代码不允许反过来影响被诊断的对象，所以：
 *
 *   - 回调侧（App_Bt_Pcm_Diag）只做整数累加，**无锁、无格式化、无 I/O**；
 *   - 打印侧（App_Bt_Diag_Print）在心跳任务里做，低优先级、可被抢占。
 *
 * 单调计数器用"读取差值"而不是"读后清零"，避免与回调侧抢写导致丢计数。
 * peak_win 是例外（需要窗口峰值），回调侧写、心跳侧读后清零，
 * 极端情况下会丢掉一个块的峰值，对诊断无影响。
 */
typedef struct {
    volatile uint32_t blocks;     /* 累计回调次数（单调） */
    volatile uint32_t samples;    /* 累计 int16 样本数（单调） */
    volatile int32_t  peak_win;   /* 本窗口绝对值峰值（心跳读后清零） */
    bool              raw_done;   /* 只抓第一段有声音的块 */
    volatile bool     raw_ready;  /* 捕获完成，待心跳打印 */
    int16_t           raw[16];    /* 被抓的那 16 个原始样本 */
    uint32_t          raw_n;
    int32_t           raw_peak;
} app_bt_diag_t;

static app_bt_diag_t s_btDiag;

/** PCM 回调侧：只累加计数，禁止任何阻塞调用 */
static void App_Bt_Pcm_Diag(const int16_t *pcm, size_t samples)
{
    int32_t peak = 0;
    size_t  i;

    if (pcm == NULL || samples == 0)
    {
        return;
    }

    for (i = 0; i < samples; i++)
    {
        int32_t v = pcm[i];
        if (v < 0)
        {
            v = -v;
        }
        if (v > peak)
        {
            peak = v;
        }
    }

    s_btDiag.blocks++;
    s_btDiag.samples += (uint32_t)samples;
    if (peak > s_btDiag.peak_win)
    {
        s_btDiag.peak_win = peak;
    }

    /* 抓到第一段"有声音"的块，存下 16 个原始样本：格式/错位一眼能看出来。
     * 这里只拷贝，不打印 —— 打印交给心跳侧。 */
    if (!s_btDiag.raw_done && peak > 2000)
    {
        uint32_t n = (samples < 16u) ? (uint32_t)samples : 16u;

        s_btDiag.raw_done = true;
        for (i = 0; i < n; i++)
        {
            s_btDiag.raw[i] = pcm[i];
        }
        s_btDiag.raw_n    = n;
        s_btDiag.raw_peak = peak;
        s_btDiag.raw_ready = true;
    }
}

/** 心跳侧：唯一允许打印 PCM 诊断的地方（3s 一次） */
static void App_Bt_Diag_Print(void)
{
    static uint32_t s_prev_blocks;
    static uint32_t s_prev_samples;
    static int64_t  s_prev_us;
    sync_protocol_master_status_t st;
    int64_t  now       = esp_timer_get_time();
    uint32_t d_blocks  = s_btDiag.blocks  - s_prev_blocks;
    uint32_t d_samples = s_btDiag.samples - s_prev_samples;
    int64_t  span_us   = now - s_prev_us;
    uint32_t blk_s;
    uint32_t samp_s;

    if (s_prev_us == 0)
    {
        /* 首个窗口只记基线，避免开机瞬间算出一个离谱的速率 */
        s_prev_us      = now;
        s_prev_blocks  = s_btDiag.blocks;
        s_prev_samples = s_btDiag.samples;
        return;
    }
    if (span_us <= 0)
    {
        span_us = 1;
    }

    blk_s  = (uint32_t)(((uint64_t)d_blocks  * 1000000ull) / (uint64_t)span_us);
    samp_s = (uint32_t)(((uint64_t)d_samples * 1000000ull) / (uint64_t)span_us);
    (void)blk_s;
    (void)samp_s;

    if (s_btDiag.raw_ready)
    {
        s_btDiag.raw_ready = false;
#if APP_MAIN_LOG
        ESP_LOGI(TAG, "[btpcm] raw: %04x %04x %04x %04x %04x %04x %04x %04x "
                      "%04x %04x %04x %04x %04x %04x %04x %04x (n=%u peak=%d)",
                 (unsigned)((uint16_t)s_btDiag.raw[0]),  (unsigned)((uint16_t)s_btDiag.raw[1]),
                 (unsigned)((uint16_t)s_btDiag.raw[2]),  (unsigned)((uint16_t)s_btDiag.raw[3]),
                 (unsigned)((uint16_t)s_btDiag.raw[4]),  (unsigned)((uint16_t)s_btDiag.raw[5]),
                 (unsigned)((uint16_t)s_btDiag.raw[6]),  (unsigned)((uint16_t)s_btDiag.raw[7]),
                 (unsigned)((uint16_t)s_btDiag.raw[8]),  (unsigned)((uint16_t)s_btDiag.raw[9]),
                 (unsigned)((uint16_t)s_btDiag.raw[10]), (unsigned)((uint16_t)s_btDiag.raw[11]),
                 (unsigned)((uint16_t)s_btDiag.raw[12]), (unsigned)((uint16_t)s_btDiag.raw[13]),
                 (unsigned)((uint16_t)s_btDiag.raw[14]), (unsigned)((uint16_t)s_btDiag.raw[15]),
                 (unsigned)s_btDiag.raw_n, (int)s_btDiag.raw_peak);
#endif
    }

    memset(&st, 0, sizeof(st));
    (void)sync_protocol_master_get_status(&st);

#if APP_MAIN_LOG
    ESP_LOGI(TAG, "[btpcm %ums] %u blk/s %u samp/s peak=%d | drop=%u resync=%u un=%u idle=%u gap=%ums | "
                  "sync st=%d %luHz %uch ingress=%u/%u dq=%u tx=%u dropPkt=%u sil=%u",
             (unsigned)(span_us / 1000), blk_s, samp_s,
             (int)s_btDiag.peak_win,
             (unsigned)bt_audio_get_pcm_dropped(s_app.bt, BT_AUDIO_PCM_SOURCE_A2DP),
             (unsigned)bt_audio_get_pcm_resync(s_app.bt),
             (unsigned)bt_audio_get_a2dp_underrun(s_app.bt),
             (unsigned)bt_audio_get_a2dp_idle(s_app.bt),
             (unsigned)bt_audio_get_and_reset_a2dp_gap(s_app.bt),
             (int)st.state, (unsigned long)st.sample_rate, (unsigned)st.channels,
             (unsigned)st.ingress_used, (unsigned)APP_BT_INGRESS_CAP,
             (unsigned)st.delay_queue_used, (unsigned)st.tx_pkts,
             (unsigned)st.dropped_pkts, (unsigned)st.silence_frames);
#endif

    s_btDiag.peak_win  = 0;
    s_prev_blocks      = s_btDiag.blocks;
    s_prev_samples     = s_btDiag.samples;
    s_prev_us          = now;
}
#endif /* APP_BT_PCM_DIAG */

/* ======================== 卡死定位：独立心跳 ======================== */

/**
 * @brief 独立的低频心跳任务（core 0 / prio 2）
 *
 * **同时充当全系统唯一的低频日志出口**：`[btpcm]` 统计也搬到这里打印
 * （原先打在 A2DP PCM 回调里，每行约 16ms 的串口阻塞直接落在音频路径上，
 *  见 App_Bt_Pcm_Diag 的说明）。
 *
 * 为什么必须有它：日志一旦只由音频回调驱动，音频一卡（或手机不再送数据），
 * 整条日志链就同时静默 —— 而系统可能仍然活着，"什么都没有"本身不携带
 * 任何信息，无法判断卡在哪一环。心跳独立于音频，因此能把"突然没声音"
 * 唯一地拆成三种：
 *
 *   a2dp_cb 涨 + beat 涨   → 数据在流、模块任务在转（再卡就是 I2S/功放侧）
 *   a2dp_cb 不涨 + beat 涨  → 手机/链路不再送数据（host 根本没收到）
 *   a2dp_cb 涨 + beat 停    → bt_audio_task 自己卡死（被下游互斥量堵住）
 *
 * 同时打印复位原因，用来区分"真的死住没重启"与"其实重启过、只是没看到日志"
 * （经典蓝牙的连接由控制器维持，主机重启后手机端往往还会显示"已连接"几秒，
 *  很容易把重启误判成卡死）。
 *
 * i2c f=/ok=/r= 是总线失败数、成功数、软件复位次数：驱动内部的 i2c 日志被
 * 整体静音了，这里是"总线被拉死"这类故障唯一的低成本观测点 —— 它会让任务
 * 长时间阻塞，是系统级卡死的头号嫌疑（见 I2c_Get_Err_Stats）。
 * **ok 必须和 f 一起看**：只看 f=2195 无法判断故障性质 ——
 *   失败率 ~6%（f 缓慢增长、ok 飞快增长）→ 信号完整性/时序问题；
 *   失败率 ~90%（ok 几乎不涨）→ 从设备根本没在应答，查供电/接插件/复位。
 * 两条路的处置方向相反，所以这个字段不能省。
 */
#define APP_HB_PERIOD_MS   3000

/** `[hb]` 打印节流：每 N 个 tick 打一次（3000ms × 3 ≈ 10s）。
 *
 *  心跳本身保持 3s 一跳，因为 `[btpcm]` 的统计窗口需要这个节拍，
 *  而且"心跳停了"本身就是任务卡死的判据 —— 把节拍也拉长会削弱这个信号。
 *  只降低打印频次：一条 ~280 字节的 `[hb]` 在 115200 波特下要占用串口 ~24ms。 */
#define APP_HB_LOG_EVERY_N 3

static void App_Heartbeat_Task(void *arg)
{
    uint32_t tick = 0;

    (void)arg;

#if APP_MAIN_LOG
    ESP_LOGW(TAG, "[hb] start: reset_reason=%d (1=poweron 3=sw 4=panic 5=int_wdt 6=task_wdt)",
             (int)esp_reset_reason());
#endif

    for (;;)
    {
        sync_protocol_master_status_t st;
        i2c_err_stats_t               i2c;

        vTaskDelay(pdMS_TO_TICKS(APP_HB_PERIOD_MS));
        tick++;

#if APP_BT_PCM_DIAG
        /* PCM 诊断：唯一的打印点（回调侧只累加计数） */
        App_Bt_Diag_Print();
#endif

        if ((tick % APP_HB_LOG_EVERY_N) != 0)
        {
            continue;
        }

        memset(&st, 0, sizeof(st));
        (void)sync_protocol_master_get_status(&st);

        memset(&i2c, 0, sizeof(i2c));
        I2c_Get_Err_Stats(&i2c);

#if APP_MAIN_LOG
        ESP_LOGW(TAG,
                 "[hb] up=%us reset=%d heap=%u psram=%u int=%u/%u | "
                 "a2dp_cb=%u beat=%u fifo=%uB | "
                 "sync st=%d dq=%u tx=%u drop=%u sil=%u | "
                 "i2c f=%u ok=%u r=%u last=%s",
                 (unsigned)(esp_timer_get_time() / 1000000),
                 (int)esp_reset_reason(),
                 (unsigned)esp_get_free_heap_size(),
                 (unsigned)heap_caps_get_free_size(MALLOC_CAP_SPIRAM),
                 /* 内部 DRAM 才是真正的瓶颈：esp_get_free_heap_size() 在
                  * CONFIG_SPIRAM_USE_MALLOC + ALWAYSINTERNAL=0 下把 PSRAM 一起算进去了，
                  * 那个 1.5MB 的数字会让人误以为内存很宽裕。int=空闲/最大连续块。 */
                 (unsigned)heap_caps_get_free_size(MALLOC_CAP_INTERNAL),
                 (unsigned)heap_caps_get_largest_free_block(MALLOC_CAP_INTERNAL),
                 (unsigned)bt_audio_get_a2dp_cb_count(s_app.bt),
                 (unsigned)bt_audio_get_task_beat(s_app.bt),
                 (unsigned)bt_audio_get_a2dp_fifo_used(s_app.bt),
                 (int)st.state,
                 (unsigned)st.delay_queue_used,
                 (unsigned)st.tx_pkts,
                 (unsigned)st.dropped_pkts,
                 (unsigned)st.silence_frames,
                 (unsigned)i2c.fail_cnt,
                 (unsigned)i2c.ok_cnt,
                 (unsigned)i2c.reset_cnt,
                 esp_err_to_name(i2c.last_err));
#endif
    }
}

/**
 * @brief bt_audio PCM 回调（bt_audio 任务上下文）
 *
 *   - A2DP 音乐：直连 sync_protocol_master_push_pcm()（不经过 MusicPlay），
 *     由 sync_protocol 统一打时间戳、组播并本地延迟播放；
 *   - HFP 下行（语音助手应答）：44.1kHz 单声道，而功放总线为立体声，
 *     先扩展为 L/R 相同再交功放（见 note/HFP下行无声-声道与音量bug.md）。
 */
static void App_Bt_Pcm_Cb(bt_audio_pcm_source_t source, const int16_t *pcm,
                          size_t samples, uint32_t sample_rate, void *user_ctx)
{
    (void)sample_rate;
    (void)user_ctx;

    if (pcm == NULL || samples == 0)
    {
        return;
    }

    if (source == BT_AUDIO_PCM_SOURCE_A2DP)
    {
#if APP_BT_PCM_DIAG
        App_Bt_Pcm_Diag(pcm, samples);
#endif
        sync_protocol_master_push_pcm(pcm, samples);
        return;
    }

    if (source == BT_AUDIO_PCM_SOURCE_HFP_DOWNLINK)
    {
        if (s_hfpDnStereoBuf == NULL)
        {
            return;
        }
        if (samples > APP_HFP_DN_STEREO_SAMPLES)
        {
#if APP_MAIN_LOG
            ESP_LOGW(TAG, "HFP mono chunk too large: %u", (unsigned)samples);
#endif
            return;
        }
        for (size_t i = 0; i < samples; i++)
        {
            s_hfpDnStereoBuf[i * 2]     = pcm[i];
            s_hfpDnStereoBuf[i * 2 + 1] = pcm[i];
        }
        Amplifier_Play_Buffer((const uint8_t *)s_hfpDnStereoBuf,
                              samples * 2 * sizeof(int16_t), NULL, 200);
    }
}

/** bt_audio 事件回调：全部交给 MusicPlay（MusicPlay 未就绪前忽略） */
static void App_Bt_Evt_Cb(const bt_audio_event_t *evt, void *user_ctx)
{
    (void)user_ctx;
    if (evt == NULL)
    {
        return;
    }
    if (s_app.music != NULL)
    {
        music_play_on_bt_event(s_app.music, evt);
    }
}

/* ======================== 各功能 boot 任务 ======================== */

/**
 * @brief MusicPlay 任务：SD 卡 + 组播通道 + 蓝牙 + music_play_create
 *
 * 蓝牙句柄由本任务创建并写入全局上下文（UI / 心跳诊断共用）。
 */
static void App_MusicPlay_Task(void *arg)
{
    (void)arg;
    music_play_cfg_t mcfg = {0};
    wifi_mcast_cfg_t mc   = {0};
    bt_audio_cfg_t   bcfg = {0};
    bool             bt_ready = false;
    esp_err_t        err;

#if APP_MAIN_LOG
    ESP_LOGI(TAG, "[MusicPlay] boot: SD card / mcast / bt_audio / music_play");
#endif

    /* 1) SD 卡（本地播放依赖；失败仅告警，蓝牙源仍可用） */
    if (SD_Card_Init() != ESP_OK)
    {
#if APP_MAIN_LOG
        ESP_LOGW(TAG, "[MusicPlay] SD_Card_Init failed, 本地列表将为空");
#endif
    }

    /* 2) 通道：音频通道只用来**单播**发数据（绑定本机端口，不收）；
     *    控制走组播 239.0.0.1:5679，收发 */
    mc.group         = SYNC_PROTOCOL_MCAST_GROUP;
    mc.port          = SYNC_UNICAST_PORT_AUDIO;
    mc.rx_enable     = false;
    err = wifi_manager_mcast_open(s_app.wifi, &mc, &s_app.audio_chan);
    if (err != ESP_OK)
    {
#if APP_MAIN_LOG
        ESP_LOGE(TAG, "[MusicPlay] mcast_open audio failed: %s", esp_err_to_name(err));
#endif
        goto fail;
    }

    mc.group         = SYNC_PROTOCOL_MCAST_GROUP;
    mc.port          = SYNC_PROTOCOL_MCAST_PORT_CTRL;
    mc.rx_enable     = true;
    mc.rx_fifo_bytes = 4096;
    err = wifi_manager_mcast_open(s_app.wifi, &mc, &s_app.control_chan);
    if (err != ESP_OK)
    {
#if APP_MAIN_LOG
        ESP_LOGE(TAG, "[MusicPlay] mcast_open ctrl failed: %s", esp_err_to_name(err));
#endif
        goto fail;
    }

    /* 3) 蓝牙：on_pcm 直连 sync，on_event 胶水进 MusicPlay */
    bcfg.device_name = APP_BT_DEVICE_NAME;
    bcfg.on_pcm      = App_Bt_Pcm_Cb;
    bcfg.on_event    = App_Bt_Evt_Cb;
    s_app.bt = bt_audio_create(&bcfg);
    if (s_app.bt == NULL)
    {
#if APP_MAIN_LOG
        ESP_LOGE(TAG, "[MusicPlay] bt_audio_create failed");
#endif
        goto fail;
    }
    err = bt_audio_start(s_app.bt);
    if (err != ESP_OK)
    {
#if APP_MAIN_LOG
        ESP_LOGE(TAG, "[MusicPlay] bt_audio_start failed: %s", esp_err_to_name(err));
#endif
        goto fail;
    }

    /* 蓝牙就绪位：暂无等待方（语音唤醒已下线），保留给后续需要 bt_audio 句柄的模块 */
    bt_ready = true;
    xEventGroupSetBits(s_app.evt, APP_EVT_BT_READY);
    App_Log_Heap("after bt_audio");

    /* 4) MusicPlay：内部自行 init/deinit sync_protocol（D=0 从 node_role 读） */
    mcfg.bt_audio      = s_app.bt;
    mcfg.audio_chan    = s_app.audio_chan;
    mcfg.control_chan  = s_app.control_chan;
    mcfg.sync_delay_ms = 0;
    mcfg.on_event      = ui_on_music_event;
    s_app.music = music_play_create(&mcfg);
    if (s_app.music == NULL)
    {
#if APP_MAIN_LOG
        ESP_LOGE(TAG, "[MusicPlay] music_play_create failed");
#endif
        goto fail;
    }

    /* 5) 开机即扫描本地列表（自动源选择未连蓝牙时落本地源） */
    music_play_scan_local(s_app.music);

    /* UI 首帧可能已经刷完（UI 任务在 mp_boot 之前创建）：补一次闸门放行。
     * 消息排队在 SCAN 之后，任务上下文按序执行，起播时列表已就绪。 */
    if (s_app.ui_ready)
    {
        (void)music_play_set_autoplay(s_app.music, true);
    }

    xEventGroupSetBits(s_app.evt, APP_EVT_MUSIC_READY);
#if APP_MAIN_LOG
    ESP_LOGI(TAG, "[MusicPlay] boot done");
#endif
    vTaskDelete(NULL);
    return;

fail:
    if (!bt_ready)
    {
        xEventGroupSetBits(s_app.evt, APP_EVT_BT_FAILED);
    }
    xEventGroupSetBits(s_app.evt, APP_EVT_MUSIC_FAILED);
    vTaskDelete(NULL);
}

/**
 * @brief LightControl 任务：等 wifi_manager 就绪 → 灯控组播通道 + 灯控模块
 *
 * 灯控通道（239.0.0.2:8889）由 App 经 wifi_manager 打开并传入；上行 ack/status
 * 经 ui_on_light_event 通知 UI 刷新灯图标。
 */
static void App_LightControl_Task(void *arg)
{
    (void)arg;
    wifi_mcast_cfg_t    mc   = {0};
    light_control_cfg_t lcfg = {0};
    esp_err_t           err;

#if APP_MAIN_LOG
    ESP_LOGI(TAG, "[LightControl] boot: waiting for wifi ready ...");
#endif
    App_Wait_Bits(APP_EVT_WIFI_READY, APP_DEP_WAIT_MS, "wifi ready");

    if (s_app.wifi == NULL || !wifi_manager_is_connected(s_app.wifi))
    {
#if APP_MAIN_LOG
        ESP_LOGE(TAG, "[LightControl] wifi not ready, skip");
#endif
        xEventGroupSetBits(s_app.evt, APP_EVT_LIGHT_FAILED);
        vTaskDelete(NULL);
        return;
    }

    mc.group         = APP_LIGHT_MCAST_GROUP;
    mc.port          = APP_LIGHT_MCAST_PORT;
    mc.rx_enable     = true;
    mc.rx_fifo_bytes = 4096;
    err = wifi_manager_mcast_open(s_app.wifi, &mc, &s_app.light_chan);
    if (err != ESP_OK)
    {
#if APP_MAIN_LOG
        ESP_LOGE(TAG, "[LightControl] mcast_open failed: %s", esp_err_to_name(err));
#endif
        xEventGroupSetBits(s_app.evt, APP_EVT_LIGHT_FAILED);
        vTaskDelete(NULL);
        return;
    }

    lcfg.chan     = s_app.light_chan;
    lcfg.on_event = ui_on_light_event;
    s_app.light = light_control_create(&lcfg);
    if (s_app.light == NULL)
    {
#if APP_MAIN_LOG
        ESP_LOGE(TAG, "[LightControl] light_control_create failed");
#endif
        xEventGroupSetBits(s_app.evt, APP_EVT_LIGHT_FAILED);
        vTaskDelete(NULL);
        return;
    }

#if APP_MAIN_LOG
    ESP_LOGI(TAG, "[LightControl] boot done");
#endif
    xEventGroupSetBits(s_app.evt, APP_EVT_LIGHT_READY);
    vTaskDelete(NULL);
}

/**
 * @brief UI 首帧就绪 → 放行 SD 卡自动起播（启动时序：先出界面，再出声）
 *
 * 调用上下文：UI_Task 的 LVGL 首帧完成事件（或超时兜底 / UI 不可用降级）。
 * 这里只投递一条消息给 MusicPlay_Task，不做任何阻塞操作。
 *
 * 幂等：MusicPlay 句柄可能还没建好（UI 任务在 mp_boot 之前创建），
 * 先记 s_app.ui_ready，App_MusicPlay_Task 建好后自己补一次放行。
 */
static void App_Ui_Ready_Cb(void *ctx)
{
    (void)ctx;
    s_app.ui_ready = true;
    if (s_app.music != NULL)
    {
        (void)music_play_set_autoplay(s_app.music, true);
    }
#if APP_MAIN_LOG
    ESP_LOGI(TAG, "[UI] ready -> release SD autoplay (music=%s)",
             (s_app.music != NULL) ? "wired" : "not yet");
#endif
}

/**
 * @brief UI 任务：等各模块句柄就绪 → ui_init（LCD / 触摸屏 / LVGL）
 *
 * 未就绪的句柄保持 NULL，UI 按"占位"降级显示；ui_init 内部自建 UI_Task。
 */
static void App_UI_Task(void *arg)
{
    (void)arg;
    ui_cfg_t  ucfg = {0};
    esp_err_t err;

#if APP_MAIN_LOG
    ESP_LOGI(TAG, "[UI] boot: waiting for module handles ...");
#endif
    /* 逐个等 READY|FAILED：某模块挂了立刻继续，UI 按占位降级显示；
     * 若只等 READY 位，模块失败会空等满超时导致长时间黑屏 */
    App_Wait_Bits(APP_EVT_MUSIC_READY | APP_EVT_MUSIC_FAILED,
                  APP_DEP_WAIT_MS, "music_play ready");
    App_Wait_Bits(APP_EVT_LIGHT_READY | APP_EVT_LIGHT_FAILED,
                  APP_OPT_WAIT_MS, "light_control ready");

    ucfg.wifi       = s_app.wifi;
    ucfg.light      = s_app.light;
    ucfg.music      = s_app.music;

    App_Log_Heap("before ui_init");
    err = ui_init(&ucfg);
    if (err != ESP_OK)
    {
#if APP_MAIN_LOG
        ESP_LOGE(TAG, "[UI] ui_init failed: %s", esp_err_to_name(err));
#endif
        /* UI 起不来也不能让音乐永远不响：直接放行 SD 卡自动起播 */
        App_Ui_Ready_Cb(NULL);
        vTaskDelete(NULL);
        return;
    }
    App_Log_Heap("after ui_init");

    /* 启动时序：页面构建 + 首帧刷完（ui_run 内部回调）之后才放行 SD 卡起播。
     * 注册必须在 ui_run 之前——页面是在 ui_run 里建的。 */
    ui_set_ready_cb(App_Ui_Ready_Cb, NULL);

#if APP_MAIN_LOG
    ESP_LOGI(TAG, "[UI] boot done");
#endif
    /* UI 任务常驻：进入主题/页面构建 + LVGL 渲染循环（不再返回） */
    ui_run();
}

/* ======================== 应用入口 ======================== */

void app_main(void)
{
    esp_err_t      err;
    node_role_cfg_t nr = {0};

    SystemStart();
    StartAndStop_Init();

    /* 1. NVS：node_role / wifi_manager / ota_manager 的持久化基础 */
    err = nvs_flash_init();
    if (err == ESP_ERR_NVS_NO_FREE_PAGES || err == ESP_ERR_NVS_NEW_VERSION_FOUND)
    {
        ESP_ERROR_CHECK(nvs_flash_erase());
        err = nvs_flash_init();
    }
    ESP_ERROR_CHECK(err);

    if (esp_psram_is_initialized())
    {
#if APP_MAIN_LOG
        ESP_LOGI(TAG, "PSRAM ready, size=%u bytes", (unsigned)esp_psram_get_size());
#endif
    }
    else
    {
#if APP_MAIN_LOG
        ESP_LOGW(TAG, "PSRAM not initialized");
#endif
    }

    /* CPU / Flash 频率打点：解码吞吐（MP3 ~1x@160MHz）与 UI 流畅度直接相关 */
    {
        uint32_t cpu_hz = 0;
        if (esp_clk_tree_src_get_freq_hz(SOC_MOD_CLK_CPU,
                                         ESP_CLK_TREE_SRC_FREQ_PRECISION_CACHED,
                                         &cpu_hz) != ESP_OK)
        {
            cpu_hz = 0;
        }
#if APP_MAIN_LOG
        ESP_LOGI(TAG, "clk: cpu=%u MHz flash=%s psram=%d MHz",
                 (unsigned)(cpu_hz / 1000000), CONFIG_ESPTOOLPY_FLASHFREQ,
                 CONFIG_SPIRAM_SPEED);
#endif
    }

    /* 2. node_role：wifi_manager 启动时经 node_role_get() 读取 WiFi 凭据 */
    ESP_ERROR_CHECK(node_role_init(NULL));

    /* 3. 就绪事件组：各模块 boot 任务与依赖方同步用 */
    s_app.evt = xEventGroupCreate();
    if (s_app.evt == NULL)
    {
#if APP_MAIN_LOG
        ESP_LOGE(TAG, "event group create failed");
#endif
        return;
    }

    App_Log_Heap("boot start");

    /* 4. WiFi：连接热点并等待拿到 IP */
    App_Wifi_Start();
    App_Log_Heap("after wifi");

    /* 5. OTA：有新固件则升级重启，否则继续 */
    App_Ota_Check();
    App_Log_Heap("after ota");

    /* 6. 功放（TX）：I2S 物理音频链路。
     *    麦克风 RX 已随语音唤醒功能整体下线（esp-sr / CallPhone / microphone
     *    三个模块已移出构建，见 legacy_disabled/README.md）。 */
    if (Amplifier_Init() != ESP_OK)
    {
#if APP_MAIN_LOG
        ESP_LOGE(TAG, "Amplifier_Init failed (无音频输出)");
#endif
    }
    if (node_role_get(&nr) == ESP_OK)
    {
        Amplifier_Set_Volume(nr.volume);   /* MusicPlay create 时还会再同步一次 */
    }
    App_Log_Heap("after amp");

    /* 7. HFP 下行立体声扩展缓冲：非 DMA，放 PSRAM（内部 RAM 留给栈/DMA） */
    s_hfpDnStereoBuf = (int16_t *)heap_caps_malloc(
        APP_HFP_DN_STEREO_SAMPLES * sizeof(int16_t), MALLOC_CAP_SPIRAM | MALLOC_CAP_8BIT);
    if (s_hfpDnStereoBuf == NULL)
    {
        s_hfpDnStereoBuf = (int16_t *)heap_caps_malloc(
            APP_HFP_DN_STEREO_SAMPLES * sizeof(int16_t), MALLOC_CAP_INTERNAL | MALLOC_CAP_8BIT);
    }
    if (s_hfpDnStereoBuf == NULL)
    {
#if APP_MAIN_LOG
        ESP_LOGW(TAG, "HFP stereo expand buffer alloc failed (通话下行无声)");
#endif
    }

    /*
     * 8. 创建功能任务：UI 任务最先建 —— 它的栈最大，必须趁内部堆还没被
     *    WiFi/BT/其它任务切碎时把这块连续内存占住（创建后立即阻塞等各模块
     *    就绪，不参与启动期 CPU 竞争）。其余模块仍严格串行：前一个 boot
     *    任务跑完并退出后再建下一个；依赖 MusicPlay（建蓝牙）→ LightControl
     *    （等 WiFi）。（原 CallPhone 环节随语音唤醒下线一并删除）
     */
    if (!App_Boot_Task_Create(App_UI_Task, "UI_Task",
                              APP_UI_TASK_STACK, APP_UI_TASK_PRIO, 0, 0))
    {
        /* 连 UI 任务都建不起来（内部 RAM 被切碎）：不留闸门，直接放行起播 */
        App_Ui_Ready_Cb(NULL);
    }

    (void)App_Boot_Task_Create(App_MusicPlay_Task, "mp_boot",
                               APP_MUSIC_TASK_STACK, APP_MUSIC_TASK_PRIO, 1,
                               APP_EVT_MUSIC_FAILED);
    App_Wait_Bits(APP_EVT_MUSIC_READY | APP_EVT_MUSIC_FAILED,
                  APP_DEP_WAIT_MS, "music_play ready");
    vTaskDelay(pdMS_TO_TICKS(50));   /* 让 IDLE 回收 mp_boot 栈，再建下一个 */
    App_Log_Heap("after mp_boot");

    (void)App_Boot_Task_Create(App_LightControl_Task, "lc_boot",
                               APP_LIGHT_TASK_STACK, APP_LIGHT_TASK_PRIO, 0,
                               APP_EVT_LIGHT_FAILED);
    App_Wait_Bits(APP_EVT_LIGHT_READY | APP_EVT_LIGHT_FAILED,
                  APP_DEP_WAIT_MS, "light_control ready");
    vTaskDelay(pdMS_TO_TICKS(50));
    App_Log_Heap("after lc_boot");

#if APP_MAIN_LOG
    ESP_LOGI(TAG, "all boot tasks dispatched");
#endif

    /* 10. 卡死定位心跳：所有引导任务之后才创建，不参与任何启动时序。
     *     创建失败只是少一份诊断，不影响播放功能。 */
    if (xTaskCreatePinnedToCore(App_Heartbeat_Task, "app_hb", 3072,
                                NULL, 2, NULL, 0) != pdPASS)
    {
#if APP_MAIN_LOG
        ESP_LOGW(TAG, "heartbeat task create failed (diagnostics only)");
#endif
    }

    /* 9. 新固件确认运行正常：取消自动回滚（仅 CONFIG_BOOTLOADER_APP_ROLLBACK_ENABLE 时生效） */
    if (OTA_Update_MarkAppValid() == ESP_OK)
    {
#if APP_MAIN_LOG
        ESP_LOGI(TAG, "app marked valid (rollback cancelled)");
#endif
    }

    /* app_main 返回后 IDF 主任务自删，回收其约 4KB 内部栈（内部 RAM 紧张时可观） */
	vTaskDelete(NULL);
	return;
}
