currygood/MusicPlaySyncSpeakers/Play_Master/components/bsp/i2s_driver/i2s_driver.c

/**
 * @file i2s_driver.c
 * @brief I2S 物理总线驱动实现（句柄化、参数化）
 *
 * 本文件实现 BSP 层 I2S 驱动的所有接口函数：
 *
 *   - i2s_bus_phy_create()      ：创建 I2S 物理总线（TX/RX 单向通道）
 *   - i2s_bus_phy_write()       ：写入 PCM 数据（仅 TX）
 *   - i2s_bus_phy_read()        ：读取 PCM 数据（仅 RX）
 *   - i2s_bus_phy_flush()       ：冲刷 DMA 缓冲区
 *   - i2s_bus_phy_set_sample_rate()：动态切换采样率
 *   - i2s_bus_phy_destroy()     ：销毁总线释放资源
 *
 * 设计要点：
 *   - 每个句柄对应一个 I2S 控制器上的单向通道（TX 或 RX），一柄一方向；
 *   - 所有硬件参数（引脚、采样率、位宽、DMA）均来自调用方配置；
 *   - write/read 内部校验句柄方向，方向不匹配返回 ESP_ERR_INVALID_ARG；
 *   - 本层不做任何锁与仲裁，互斥由上层模块负责。
 *
 * 硬件说明（当前板卡）：
 *   - TX（功放 NS4168）  ：I2S_NUM_1，bclk=GPIO26 ws=GPIO27 dout=GPIO13
 *   - RX（麦克风 INMP441）: I2S_NUM_0，bclk=GPIO2 ws=GPIO5 din=GPIO34
 */

#include "i2s_driver.h"
#include "esp_log.h"
#if CONFIG_IDF_TARGET_ESP32 || CONFIG_IDF_TARGET_ESP32S2
#include "hal/i2s_ll.h"
#endif
#include <inttypes.h>
#include <stdlib.h>
#include <string.h>

/* ======================== 私有宏定义 ============================================= */

/** 日志标签 */
#define TAG "I2S_PHY"

#if I2S_DRIVER_DEBUG_LOGS
#define I2S_LOGE(...) ESP_LOGE(TAG, __VA_ARGS__)
#define I2S_LOGW(...) ESP_LOGW(TAG, __VA_ARGS__)
#define I2S_LOGI(...) ESP_LOGI(TAG, __VA_ARGS__)
#else
#define I2S_LOGE(...) do { } while (0)
#define I2S_LOGW(...) do { } while (0)
#define I2S_LOGI(...) do { } while (0)
#endif

/**
 * @brief 句柄魔数，用于校验非法/悬空句柄
 *
 * ASCII 码 'I' '2' 'S' 'P' = 0x49325350，
 * 在 destroy 时清零，防止 use-after-free。
 */
#define I2S_PHY_MAGIC 0x49325350u /* 'I2SP' */

/* ======================== 私有类型定义 =========================================== */

/**
 * @brief I2S 物理总线实例结构体（不透明句柄）
 *
 * 封装 ESP-IDF I2S 通道句柄及配置备份，
 * 上层通过 i2s_bus_handle_t 不透明指针访问。
 */
struct i2s_bus_phy_s {
    uint32_t magic;            /**< 魔数校验（I2S_PHY_MAGIC） */
    i2s_port_t port;           /**< I2S 控制器端口号 */
    bool is_tx;                /**< 通道方向：true=TX 发送，false=RX 接收 */
    i2s_chan_handle_t chan;    /**< ESP-IDF 底层通道句柄 */
    i2s_pin_cfg_t pin_cfg;     /**< 引脚配置备份（用于日志和重配置） */
    i2s_bus_cfg_t bus_cfg;     /**< 音频格式与 DMA 配置备份 */
};

/* ======================== 内部工具函数 =========================================== */

/**
 * @brief 校验句柄合法性
 *
 * 检查句柄非 NULL 且魔数匹配，防止悬空指针或已销毁句柄被误用。
 *
 * @param bus  待校验的句柄
 *
 * @return true  合法句柄
 * @return false 非法或已销毁句柄
 */
static bool i2s_phy_valid(i2s_bus_handle_t bus)
{
    return (bus != NULL) && (bus->magic == I2S_PHY_MAGIC);
}

/* ======================== 公共 API 实现 ========================================== */

/**
 * @brief 创建 I2S 物理总线
 *
 * 完整创建流程：
 *   1. 参数校验（非空检查、引脚有效性）；
 *   2. 分配并初始化句柄结构体；
 *   3. 调用 i2s_new_channel() 创建底层通道；
 *   4. 调用 i2s_channel_init_std_mode() 配置 Philips 标准模式；
 *   5. 调用 i2s_channel_enable() 启动时钟。
 *
 * 任意步骤失败都会回滚已分配资源。
 */
esp_err_t i2s_bus_phy_create(i2s_port_t port, bool is_tx,
                             const i2s_pin_cfg_t *pin_cfg,
                             const i2s_bus_cfg_t *bus_cfg,
                             i2s_bus_handle_t *out_handle)
{
    /* 参数校验 */
    if (pin_cfg == NULL || bus_cfg == NULL || out_handle == NULL)
    {
        return ESP_ERR_INVALID_ARG;
    }
    /* TX 必须有数据输出脚，RX 必须有数据输入脚 */
    if (is_tx && (pin_cfg->dout < 0))
    {
        I2S_LOGE("TX bus requires a valid dout pin");
        return ESP_ERR_INVALID_ARG;
    }
    if (!is_tx && (pin_cfg->din < 0))
    {
        I2S_LOGE("RX bus requires a valid din pin");
        return ESP_ERR_INVALID_ARG;
    }

    /* 分配句柄 */
    i2s_bus_handle_t bus = calloc(1, sizeof(struct i2s_bus_phy_s));
    if (bus == NULL)
    {
        return ESP_ERR_NO_MEM;
    }
    bus->magic = I2S_PHY_MAGIC;
    bus->port = port;
    bus->is_tx = is_tx;
    memcpy(&bus->pin_cfg, pin_cfg, sizeof(bus->pin_cfg));
    memcpy(&bus->bus_cfg, bus_cfg, sizeof(bus->bus_cfg));

    /*
     * 步骤 1：创建 I2S 通道。
     *  - 一柄一方向：TX 时只传 tx 句柄，RX 时只传 rx 句柄
     *  - TX 使用 auto_clear，播放完自动清零 DMA 防止重复噪声
     */
    i2s_chan_config_t chan_cfg = {
        .id = port,
        .role = I2S_ROLE_MASTER,
        .dma_desc_num = bus_cfg->dma_desc_num,
        .dma_frame_num = bus_cfg->dma_frame_num,
        .auto_clear = is_tx && bus_cfg->tx_auto_clear,
    };

    i2s_chan_handle_t *tx_handle = is_tx ? &bus->chan : NULL;
    i2s_chan_handle_t *rx_handle = is_tx ? NULL : &bus->chan;
    esp_err_t ret = i2s_new_channel(&chan_cfg, tx_handle, rx_handle);
    if (ret != ESP_OK)
    {
        I2S_LOGE("i2s_new_channel failed: %s", esp_err_to_name(ret));
        free(bus);
        return ret;
    }

    /*
     * 步骤 2：配置标准模式（Philips）。
     * slot_mask / ws_pol / bit_shift 全部由调用方配置，
     * INMP441 麦克风需要 slot_mask=RIGHT + ws_pol=true。
     */
    i2s_std_config_t std_cfg = {
        .clk_cfg = I2S_STD_CLK_DEFAULT_CONFIG(bus_cfg->sample_rate),
        .slot_cfg = I2S_STD_PHILIPS_SLOT_DEFAULT_CONFIG(bus_cfg->bit_width, bus_cfg->slot_mode),
        .gpio_cfg = {
            .mclk = (gpio_num_t)pin_cfg->mclk,
            .bclk = (gpio_num_t)pin_cfg->bclk,
            .ws   = (gpio_num_t)pin_cfg->ws,
            .dout = (gpio_num_t)pin_cfg->dout,
            .din  = (gpio_num_t)pin_cfg->din,
            .invert_flags = {
                .mclk_inv = false,
                .bclk_inv = false,
                .ws_inv = false,
            },
        },
    };
    std_cfg.slot_cfg.slot_mask  = bus_cfg->slot_mask;
    std_cfg.slot_cfg.ws_pol     = bus_cfg->slot_ws_pol;
    std_cfg.slot_cfg.bit_shift  = bus_cfg->slot_bit_shift;

    ret = i2s_channel_init_std_mode(bus->chan, &std_cfg);
    if (ret != ESP_OK)
    {
        I2S_LOGE("i2s_channel_init_std_mode failed: %s", esp_err_to_name(ret));
        i2s_del_channel(bus->chan);
        free(bus);
        return ret;
    }

#if CONFIG_IDF_TARGET_ESP32 || CONFIG_IDF_TARGET_ESP32S2
    /*
     * 步骤 2.4：经典 ESP32/ESP32-S2 使用片上 legacy DMA 驱动 I2S，
     * 必须打开 out_auto_wrback 与 out_eof_mode，否则 DMA 只输出一轮
     * 就停住，之后 i2s_channel_write() 拿不到 TX 描述符返回 ESP_ERR_TIMEOUT。
     * （官方 DAC 驱动 dac_dma.c 正是这样配置；新版 I2S 驱动漏配了这两项。）
     */
    {
        i2s_dev_t *hw = I2S_LL_GET_HW((int)port);
        if (hw != NULL)
        {
            i2s_ll_dma_enable_auto_write_back(hw, true);
            i2s_ll_dma_enable_eof_on_fifo_empty(hw, true);
        }
    }
#endif

    /*
     * 步骤 2.5：TX 通道预载 DMA 缓冲区（关键步骤，必须在 enable 之前调用）。
     * 官方例程（i2s_basic/i2s_std）在 i2s_channel_enable() 前会反复调用
     * i2s_channel_preload_data() 把 DMA 描述符队列预填满：
     *  - 经典 ESP32 若不预载，DMA 不会持续触发"描述符已发送"中断，
     *    导致 i2s_channel_write() 第二次写入就返回 ESP_ERR_TIMEOUT
     *    （现象：第一块能放出 32ms，第二块立即超时）；
     *  - ESP32-S3 走 GDMA 不受影响，因此同样的代码在 S3 开发板上正常。
     */
    if (is_tx)
    {
        size_t preload_chunk = 512;
        uint8_t *preload_zero = calloc(1, preload_chunk);
        if (preload_zero == NULL)
        {
            i2s_del_channel(bus->chan);
            free(bus);
            return ESP_ERR_NO_MEM;
        }
        size_t loaded = preload_chunk;
        while (loaded == preload_chunk)
        {
            ret = i2s_channel_preload_data(bus->chan, preload_zero, preload_chunk, &loaded);
            if (ret != ESP_OK)
            {
                I2S_LOGE("i2s_channel_preload_data failed: %s", esp_err_to_name(ret));
                free(preload_zero);
                i2s_del_channel(bus->chan);
                free(bus);
                return ret;
            }
        }
        free(preload_zero);
    }
    /* 步骤 3：使能通道，启动 SCK/WS 时钟 */
    ret = i2s_channel_enable(bus->chan);
    if (ret != ESP_OK)
    {
        I2S_LOGE("i2s_channel_enable failed: %s", esp_err_to_name(ret));
        i2s_del_channel(bus->chan);
        free(bus);
        return ret;
    }

#if CONFIG_IDF_TARGET_ESP32 || CONFIG_IDF_TARGET_ESP32S2
    /*
     * 步骤 3.5：使能后再确认一次 legacy DMA 关键位（保险起见，重复设置无害），
     * 并打印关键寄存器状态，方便定位 TIMEOUT。
     */
    {
        i2s_dev_t *hw = I2S_LL_GET_HW((int)port);
        if (hw != NULL)
        {
            i2s_ll_dma_enable_auto_write_back(hw, true);
            i2s_ll_dma_enable_eof_on_fifo_empty(hw, true);
            I2S_LOGI("DMA cfg: lc_conf=0x%08" PRIx32 ", dscr_en=%u, tx_start=%u, link_start=%u",
                     (uint32_t)hw->lc_conf.val,
                     (uint32_t)hw->fifo_conf.dscr_en,
                     (uint32_t)hw->conf.tx_start,
                     (uint32_t)hw->out_link.start);
        }
    }
#endif

    I2S_LOGI("I2S phy created: port=%d, %s, sample_rate=%" PRIu32
             ", bclk=%d, ws=%d, dout=%d, din=%d",
             (int)port, is_tx ? "TX" : "RX", bus_cfg->sample_rate,
             pin_cfg->bclk, pin_cfg->ws, pin_cfg->dout, pin_cfg->din);
    /* BCLK = 采样率 x 总槽数 x 位宽（STD 帧固定 2 槽；MONO 只影响数据重复不影响时钟） */
    I2S_LOGI("BCLK = %" PRIu32 " Hz (fs=%" PRIu32 " x %dch x %u bit)",
             (uint32_t)bus_cfg->sample_rate * 2 * (uint32_t)bus_cfg->bit_width,
             (uint32_t)bus_cfg->sample_rate, 2, (uint32_t)bus_cfg->bit_width);

    *out_handle = bus;
    return ESP_OK;
}

/**
 * @brief 写入 PCM 数据（仅限 TX 总线）
 *
 * 将 PCM 音频数据通过 DMA 发送到 I2S 外设。
 * 内部校验句柄合法性及方向（必须是 TX），不匹配则返回错误。
 *
 * @note 若 DMA 缓冲区满，会阻塞等待至超时
 */
esp_err_t i2s_bus_phy_write(i2s_bus_handle_t bus, const uint8_t *buffer,
                            size_t size, size_t *bytes_written, uint32_t timeout)
{
    if (!i2s_phy_valid(bus) || !bus->is_tx || buffer == NULL || size == 0)
    {
        return ESP_ERR_INVALID_ARG;
    }

    esp_err_t ret = i2s_channel_write(bus->chan, buffer, size, bytes_written, timeout);

#if CONFIG_IDF_TARGET_ESP32 || CONFIG_IDF_TARGET_ESP32S2
    /*
     * 经典 ESP32 的新版 I2S 驱动长跑后会"永久卡死"：
     * DMA 环里的描述符不再产生 EOF，i2s_channel_write() 拿不到空闲缓冲
     * 持续返回 ESP_ERR_TIMEOUT（日志现象：开始几百块正常，之后全超时）。
     * 此处每次超时都做一次标准 flush（disable→enable，与官方 flush 一致）
     * 让 DMA 描述符环重新转起来，并立即重试一次；仍失败则返回超时。
     */
    if (ret == ESP_ERR_TIMEOUT)
    {
        I2S_LOGW("tx timeout, restarting channel and retrying...");
        if (i2s_channel_disable(bus->chan) == ESP_OK &&
            i2s_channel_enable(bus->chan) == ESP_OK)
        {
            ret = i2s_channel_write(bus->chan, buffer, size, bytes_written, timeout);
            if (ret == ESP_OK)
            {
                I2S_LOGW("tx recovered after channel restart");
            }
        }
    }
#endif
    return ret;
}

#if CONFIG_IDF_TARGET_ESP32 || CONFIG_IDF_TARGET_ESP32S2
void i2s_bus_phy_debug_dma(i2s_bus_handle_t bus)
{
    if (!i2s_phy_valid(bus))
    {
        return;
    }
    i2s_dev_t *hw = I2S_LL_GET_HW((int)bus->port);
    if (hw == NULL)
    {
        return;
    }
    uint32_t eof_addr = 0;
    i2s_ll_tx_get_eof_des_addr(hw, &eof_addr);
    uint32_t intr = (uint32_t)i2s_ll_get_intr_status(hw);
    I2S_LOGI("[dbg] intr=0x%08" PRIx32 " (out_eof=%u) eof_desc=0x%" PRIx32
                  " dscr_en=%u tx_start=%u link_start=%u lc_conf=0x%08" PRIx32,
             intr, (uint32_t)((intr & I2S_LL_EVENT_TX_EOF) ? 1 : 0), eof_addr,
             (uint32_t)hw->fifo_conf.dscr_en,
             (uint32_t)hw->conf.tx_start,
             (uint32_t)hw->out_link.start,
             (uint32_t)hw->lc_conf.val);
}
#endif

/**
 * @brief 读取 PCM 数据（仅限 RX 总线）
 *
 * 从 I2S DMA 接收缓冲区读取音频数据。
 * 内部校验句柄合法性及方向（必须是 RX），TX 句柄调用此函数返回错误。
 *
 * @note 若缓冲区空，会阻塞等待至超时
 */
esp_err_t i2s_bus_phy_read(i2s_bus_handle_t bus, uint8_t *buffer,
                           size_t size, size_t *bytes_read, uint32_t timeout)
{
    if (!i2s_phy_valid(bus) || bus->is_tx || buffer == NULL || size == 0)
    {
        return ESP_ERR_INVALID_ARG;
    }
    return i2s_channel_read(bus->chan, buffer, size, bytes_read, timeout);
}

/**
 * @brief 冲刷物理总线（丢弃未处理的数据）
 *
 * 通过禁能后重新使能 I2S 通道，清空 DMA 中排队而未播放（TX）
 * 或未读出（RX）的残留数据。可用于：
 *   - TX：强制丢弃旧数据，立即播放新数据（抢占切换场景）；
 *   - RX：清空硬件/DMA 缓冲区，重新开始采集。
 */
esp_err_t i2s_bus_phy_flush(i2s_bus_handle_t bus)
{
    if (!i2s_phy_valid(bus))
    {
        return ESP_ERR_INVALID_ARG;
    }
    esp_err_t ret = i2s_channel_disable(bus->chan);
    if (ret != ESP_OK)
    {
        I2S_LOGE("disable failed during flush: %s", esp_err_to_name(ret));
        return ret;
    }
    ret = i2s_channel_enable(bus->chan);
    if (ret != ESP_OK)
    {
        I2S_LOGE("enable failed during flush: %s", esp_err_to_name(ret));
        return ret;
    }
    return ESP_OK;
}

/**
 * @brief 动态切换采样率（无需销毁重建）
 *
 * 实现流程：
 *   1. 禁能 I2S 通道；
 *   2. 调用 i2s_channel_reconfig_std_clock() 重新配置时钟；
 *   3. 重新使能通道；
 *   4. 更新内部备份的采样率值。
 *
 * @note 切换过程中会有短暂静音（禁能→使能间隙）
 */
esp_err_t i2s_bus_phy_set_sample_rate(i2s_bus_handle_t bus, uint32_t sample_rate)
{
    if (!i2s_phy_valid(bus))
    {
        return ESP_ERR_INVALID_ARG;
    }

    esp_err_t ret = i2s_channel_disable(bus->chan);
    if (ret != ESP_OK)
    {
        return ret;
    }

    i2s_std_clk_config_t clk_cfg = I2S_STD_CLK_DEFAULT_CONFIG(sample_rate);
    ret = i2s_channel_reconfig_std_clock(bus->chan, &clk_cfg);
    if (ret != ESP_OK)
    {
        I2S_LOGE("reconfig clock failed: %s", esp_err_to_name(ret));
        i2s_channel_enable(bus->chan);
        return ret;
    }

    ret = i2s_channel_enable(bus->chan);
    if (ret == ESP_OK)
    {
        bus->bus_cfg.sample_rate = sample_rate;
        I2S_LOGI("sample rate switched to %u Hz", sample_rate);
    }
    return ret;
}

/**
 * @brief 销毁 I2S 物理总线，释放所有资源
 *
 * 释放流程：
 *   1. 校验句柄合法性（NULL 句柄直接返回成功）；
 *   2. 禁能并删除底层 I2S 通道；
 *   3. 清零魔数（防止 use-after-free）；
 *   4. 释放句柄结构体内存。
 *
 * @note 销毁后原句柄指针变为悬空，调用方应置 NULL
 */
esp_err_t i2s_bus_phy_destroy(i2s_bus_handle_t bus)
{
    if (bus == NULL)
    {
        return ESP_OK;
    }
    if (bus->magic != I2S_PHY_MAGIC)
    {
        return ESP_ERR_INVALID_ARG;
    }

    if (bus->chan != NULL)
    {
        i2s_channel_disable(bus->chan);
        i2s_del_channel(bus->chan);
    }
    bus->magic = 0;
    free(bus);
    I2S_LOGI("I2S phy destroyed");
    return ESP_OK;
}
