currygood/MusicPlaySyncSpeakers/Play_Master/components/App/UI/ui_font_cn_16.c

/*******************************************************************************
 * Size: 16 px
 * Bpp: 4
 * Opts: --font C:/Users/pole/AppData/Local/Temp/uifonts/NotoSansSC.ttf --size 16 --bpp 4 --format lvgl --no-compress --range 0x20-0x7E --symbols ·×—…←→⏭⏮⏸▶　、。《》一七三上下不与两个中为主举义之乐九也事二于交产享亮仅仍从代令以件价任优传位住体你使例依侧保信做停像允先克免入全八公共关内册再冲准减击函分切列则创初判到制刷前副功加务动助化区十半协单占卡卧即厅压原参反发取变叠口句只可右号各合同名后向否听启周命唤器四回固图在地址块型域基塞处备复外大失头好如始子字存宏定实客室容密寸对导封射将小少尚尺尽尾局层居屏展属工左已布常幕并序应底度建开异式引张强归当录形往径待循必志快态总恢息意慢成或户所手打执扩扫把报拖持挂指按换据排接控推描提摸播支收放故效数整文断新方无既日时明映是显景智暂曲更最有服期未本机束条来板构架柄染查标栈栏样案档检植模横次止正此步段毁每比毫法泡注洁流测消深渲源滚满演灯灰点照片版牙物状独猜环现珀琥生用由电界留的监盖盘目直真知矩码硬碰示禁秒称移程空立竖章符第等签类系素约级纯线经给络绝统续绿缓编缩缺网置翻职联背能脚自航色节若范落蓝藏行补表要覆见观规触计认议许设词译话询该详语误说请读调责败费资赖走起超跑跟路转轮软载辅边达过运返这进连退送适选逐通造遵部都配醒释里重量针钟钮铺链销锁错键闭问间队阵阶阻际降限随隐隔集需非靠面音页顶项顺须预频题颜风馈首驱驻高麦黑默齐（），：； --lv-include lvgl.h --lv-font-name ui_font_cn_16 -o ui_font_cn_16.c
 ******************************************************************************/

#ifdef LV_LVGL_H_INCLUDE_SIMPLE
#include "lvgl.h"
#else
#include "lvgl.h"
#endif

#ifndef UI_FONT_CN_16
#define UI_FONT_CN_16 1
#endif

#if UI_FONT_CN_16

/*-----------------
 *    BITMAPS
 *----------------*/

/*Store the image of the glyphs*/
static LV_ATTRIBUTE_LARGE_CONST const uint8_t glyph_bitmap[] = {
    /* U+0020 " " */

    /* U+0021 "!" */
    0x18, 0x17, 0x17, 0x17, 0x17, 0x7, 0x7, 0x7,
    0x4, 0x0, 0x14, 0x5a,

    /* U+0022 "\"" */
    0x82, 0x37, 0x82, 0x37, 0x71, 0x26, 0x51, 0x14,

    /* U+0023 "#" */
    0x0, 0x7, 0x0, 0x80, 0x0, 0x25, 0x0, 0x80,
    0x0, 0x43, 0x0, 0x70, 0x8, 0xb9, 0x89, 0xb6,
    0x0, 0x70, 0x4, 0x30, 0x0, 0x80, 0x6, 0x10,
    0x0, 0x80, 0x7, 0x0, 0x38, 0xc8, 0x8c, 0x83,
    0x0, 0x80, 0x8, 0x0, 0x1, 0x60, 0x8, 0x0,
    0x3, 0x50, 0x8, 0x0, 0x4, 0x30, 0x7, 0x0,

    /* U+0024 "$" */
    0x0, 0x8, 0x0, 0x0, 0x0, 0x80, 0x0, 0x5,
    0x9b, 0x92, 0x2, 0x80, 0x0, 0x50, 0x63, 0x0,
    0x0, 0x5, 0x40, 0x0, 0x0, 0xa, 0x10, 0x0,
    0x0, 0x8, 0x70, 0x0, 0x0, 0x2, 0xa3, 0x0,
    0x0, 0x0, 0xa0, 0x0, 0x0, 0x6, 0x30, 0x0,
    0x0, 0x63, 0x71, 0x0, 0xa, 0x0, 0x78, 0x99,
    0x20, 0x0, 0x8, 0x0, 0x0, 0x0, 0x80, 0x0,

    /* U+0025 "%" */
    0x4, 0x98, 0x70, 0x0, 0x4, 0x40, 0x0, 0x9,
    0x0, 0x54, 0x0, 0x9, 0x0, 0x0, 0x35, 0x0,
    0x8, 0x0, 0x63, 0x0, 0x0, 0x34, 0x0, 0x8,
    0x0, 0x80, 0x0, 0x0, 0x26, 0x0, 0x17, 0x7,
    0x23, 0x88, 0x10, 0xa, 0x0, 0x82, 0x18, 0x9,
    0x0, 0x90, 0x1, 0x88, 0x40, 0x81, 0x53, 0x0,
    0x62, 0x0, 0x0, 0x2, 0x70, 0x71, 0x0, 0x44,
    0x0, 0x0, 0x8, 0x0, 0x80, 0x0, 0x35, 0x0,
    0x0, 0x36, 0x0, 0x62, 0x0, 0x53, 0x0, 0x0,
    0x90, 0x0, 0x18, 0x0, 0x90, 0x0, 0x4, 0x50,
    0x0, 0x6, 0x89, 0x40,

    /* U+0026 "&" */
    0x0, 0x8, 0x89, 0x0, 0x0, 0x0, 0x71, 0x4,
    0x50, 0x0, 0x0, 0x80, 0x3, 0x50, 0x0, 0x0,
    0x80, 0x8, 0x0, 0x0, 0x0, 0x44, 0x82, 0x0,
    0x0, 0x0, 0x2f, 0x0, 0x0, 0x1, 0x3, 0x85,
    0x40, 0x0, 0x53, 0x9, 0x0, 0x81, 0x0, 0x90,
    0x45, 0x0, 0x9, 0x3, 0x60, 0x36, 0x0, 0x1,
    0xaa, 0x0, 0xb, 0x10, 0x1, 0xcc, 0x20, 0x1,
    0x99, 0x89, 0x10, 0x76,

    /* U+0027 "'" */
    0x82, 0x82, 0x71, 0x51,

    /* U+0028 "(" */
    0x0, 0x10, 0x0, 0x60, 0x1, 0x50, 0x6, 0x0,
    0x7, 0x0, 0x7, 0x0, 0x34, 0x0, 0x53, 0x0,
    0x62, 0x0, 0x62, 0x0, 0x53, 0x0, 0x35, 0x0,
    0x7, 0x0, 0x7, 0x0, 0x5, 0x10, 0x0, 0x60,
    0x0, 0x60, 0x0, 0x0,

    /* U+0029 ")" */
    0x20, 0x0, 0x25, 0x0, 0x7, 0x0, 0x4, 0x30,
    0x0, 0x70, 0x0, 0x80, 0x0, 0x80, 0x0, 0x61,
    0x0, 0x52, 0x0, 0x52, 0x0, 0x61, 0x0, 0x80,
    0x0, 0x80, 0x0, 0x70, 0x5, 0x20, 0x7, 0x0,
    0x33, 0x0, 0x0, 0x0,

    /* U+002A "*" */
    0x0, 0x80, 0x5, 0x5b, 0x63, 0x7, 0xf4, 0x0,
    0x93, 0x80, 0x1, 0x1, 0x0,

    /* U+002B "+" */
    0x0, 0x1, 0x50, 0x0, 0x0, 0x2, 0x70, 0x0,
    0x0, 0x2, 0x70, 0x0, 0x0, 0x2, 0x70, 0x0,
    0x38, 0x89, 0xc8, 0x86, 0x0, 0x2, 0x70, 0x0,
    0x0, 0x2, 0x70, 0x0, 0x0, 0x2, 0x70, 0x0,
    0x0, 0x0, 0x10, 0x0,

    /* U+002C "," */
    0x2, 0x10, 0x9d, 0x0, 0x80, 0x73, 0x4, 0x0,

    /* U+002D "-" */
    0x29, 0x99, 0x40,

    /* U+002E "." */
    0x31, 0xa5,

    /* U+002F "/" */
    0x0, 0x0, 0x6, 0x10, 0x0, 0x0, 0x80, 0x0,
    0x0, 0x26, 0x0, 0x0, 0x7, 0x10, 0x0, 0x0,
    0x80, 0x0, 0x0, 0x25, 0x0, 0x0, 0x7, 0x0,
    0x0, 0x0, 0x80, 0x0, 0x0, 0x35, 0x0, 0x0,
    0x8, 0x0, 0x0, 0x0, 0x80, 0x0, 0x0, 0x44,
    0x0, 0x0, 0x8, 0x0, 0x0, 0x0, 0x80, 0x0,
    0x0, 0x53, 0x0, 0x0, 0x8, 0x0, 0x0, 0x0,

    /* U+0030 "0" */
    0x0, 0x59, 0x88, 0x0, 0x3, 0x80, 0x3, 0x80,
    0x9, 0x0, 0x0, 0x90, 0x9, 0x0, 0x0, 0x63,
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
    0x1, 0x0, 0x0, 0x2, 0x50, 0x0, 0x0, 0x0,
    0x0, 0x0, 0x0, 0x2, 0x50, 0x0, 0x0, 0x0,
    0x0, 0x37, 0x77, 0x79, 0xc7, 0x77, 0x73, 0x0,
    0x0, 0x0, 0x0, 0x2, 0x50, 0x0, 0x0, 0x0,
    0x0, 0x0, 0x0, 0x2, 0x50, 0x0, 0x0, 0x0,
    0x17, 0x77, 0x77, 0x78, 0x87, 0x77, 0x77, 0x71,
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
