currygood/MusicPlaySyncSpeakers/Play_Master/components/App/UI/ui_icons_16.c

/*******************************************************************************
 * Size: 16 px
 * Bpp: 4
 * Opts: --font C:/Users/pole/AppData/Local/Temp/uifonts/MaterialIcons-Regular.ttf --size 16 --bpp 4 --format lvgl --no-compress --range 0xe5c4,0xe1a7,0xe0f0,0xe896,0xe029,0xe405,0xe034,0xe037,0xe040,0xe041,0xe8b8,0xe044,0xe045,0xe627,0xe050,0xe63e,0xe648 --lv-include lvgl.h --lv-font-name ui_icons_16 -o ui_icons_16.c
 ******************************************************************************/

#ifdef LV_LVGL_H_INCLUDE_SIMPLE
#include "lvgl.h"
#else
#include "lvgl.h"
#endif

#ifndef UI_ICONS_16
#define UI_ICONS_16 1
#endif

#if UI_ICONS_16

/*-----------------
 *    BITMAPS
 *----------------*/

/*Store the image of the glyphs*/
static LV_ATTRIBUTE_LARGE_CONST const uint8_t glyph_bitmap[] = {
    /* U+E029 "" */
    0x0, 0x3, 0xcb, 0x20, 0x0, 0x0, 0xe, 0xff,
    0xc0, 0x0, 0x0, 0x1f, 0xff, 0xe0, 0x0, 0x0,
    0x1f, 0xff, 0xe0, 0x0, 0x0, 0x1f, 0xff, 0xe0,
    0x0, 0x0, 0x1f, 0xff, 0xe0, 0x0, 0xa5, 0xf,
    0xff, 0xd0, 0xb4, 0x89, 0x7, 0xff, 0x50, 0xf2,
    0x2f, 0x30, 0x0, 0x9, 0xb0, 0x5, 0xf9, 0x56,
    0xcd, 0x10, 0x0, 0x29, 0xfe, 0x81, 0x0, 0x0,
    0x0, 0xb9, 0x0, 0x0, 0x0, 0x0, 0xb9, 0x0,
    0x0,

    /* U+E034 "" */
    0x77, 0x40, 0x4, 0x77, 0xff, 0xa0, 0xa, 0xff,
    0xff, 0xa0, 0xa, 0xff, 0xff, 0xa0, 0xa, 0xff,
    0xff, 0xa0, 0xa, 0xff, 0xff, 0xa0, 0xa, 0xff,
    0xff, 0xa0, 0xa, 0xff, 0xff, 0xa0, 0xa, 0xff,
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
    0xff, 0xfe, 0x88, 0xef, 0xff, 0xf5, 0xc, 0xff,
    0xff, 0xff, 0xff, 0xff, 0xc0, 0x3, 0xc6, 0x8f,
    0xff, 0xf8, 0x6c, 0x30, 0x0, 0x0, 0xd, 0xff,
    0xc0, 0x0, 0x0, 0x0, 0x0, 0x9, 0xee, 0x90,
    0x0, 0x0
};


/*---------------------
 *  GLYPH DESCRIPTION
 *--------------------*/

static const lv_font_fmt_txt_glyph_dsc_t glyph_dsc[] = {
    {.bitmap_index = 0, .adv_w = 0, .box_w = 0, .box_h = 0, .ofs_x = 0, .ofs_y = 0} /* id = 0 reserved */,
    {.bitmap_index = 0, .adv_w = 256, .box_w = 10, .box_h = 13, .ofs_x = 3, .ofs_y = 2},
    {.bitmap_index = 65, .adv_w = 256, .box_w = 8, .box_h = 10, .ofs_x = 4, .ofs_y = 3},
    {.bitmap_index = 105, .adv_w = 256, .box_w = 8, .box_h = 10, .ofs_x = 5, .ofs_y = 3},
    {.bitmap_index = 145, .adv_w = 256, .box_w = 13, .box_h = 14, .ofs_x = 1, .ofs_y = 1},
    {.bitmap_index = 236, .adv_w = 256, .box_w = 13, .box_h = 14, .ofs_x = 1, .ofs_y = 1},
    {.bitmap_index = 327, .adv_w = 256, .box_w = 8, .box_h = 8, .ofs_x = 4, .ofs_y = 4},
    {.bitmap_index = 359, .adv_w = 256, .box_w = 8, .box_h = 8, .ofs_x = 4, .ofs_y = 4},
    {.bitmap_index = 391, .adv_w = 256, .box_w = 12, .box_h = 12, .ofs_x = 2, .ofs_y = 2},
    {.bitmap_index = 463, .adv_w = 256, .box_w = 10, .box_h = 14, .ofs_x = 3, .ofs_y = 1},
    {.bitmap_index = 533, .adv_w = 256, .box_w = 9, .box_h = 14, .ofs_x = 3, .ofs_y = 1},
    {.bitmap_index = 596, .adv_w = 256, .box_w = 8, .box_h = 12, .ofs_x = 4, .ofs_y = 2},
    {.bitmap_index = 644, .adv_w = 256, .box_w = 12, .box_h = 12, .ofs_x = 2, .ofs_y = 2},
    {.bitmap_index = 716, .adv_w = 256, .box_w = 12, .box_h = 16, .ofs_x = 2, .ofs_y = 0},
    {.bitmap_index = 812, .adv_w = 256, .box_w = 16, .box_h = 12, .ofs_x = 0, .ofs_y = 2},
    {.bitmap_index = 908, .adv_w = 256, .box_w = 16, .box_h = 13, .ofs_x = 0, .ofs_y = 2},
    {.bitmap_index = 1012, .adv_w = 256, .box_w = 12, .box_h = 8, .ofs_x = 2, .ofs_y = 4},
    {.bitmap_index = 1060, .adv_w = 256, .box_w = 14, .box_h = 14, .ofs_x = 1, .ofs_y = 1}
};

/*---------------------
 *  CHARACTER MAPPING
 *--------------------*/

static const uint16_t unicode_list_0[] = {
    0x0, 0xb, 0xe, 0x17, 0x18, 0x1b, 0x1c, 0x27,
    0xc7, 0x17e, 0x3dc, 0x59b, 0x5fe, 0x615, 0x61f, 0x86d,
    0x88f
};

/*Collect the unicode lists and glyph_id offsets*/
static const lv_font_fmt_txt_cmap_t cmaps[] =
{
    {
        .range_start = 57385, .range_length = 2192, .glyph_id_start = 1,
        .unicode_list = unicode_list_0, .glyph_id_ofs_list = NULL, .list_length = 17, .type = LV_FONT_FMT_TXT_CMAP_SPARSE_TINY
    }
};



/*--------------------
 *  ALL CUSTOM DATA
 *--------------------*/

#if LVGL_VERSION_MAJOR == 8
/*Store all the custom data of the font*/
static  lv_font_fmt_txt_glyph_cache_t cache;
#endif

#if LVGL_VERSION_MAJOR >= 8
static const lv_font_fmt_txt_dsc_t font_dsc = {
#else
static lv_font_fmt_txt_dsc_t font_dsc = {
#endif
    .glyph_bitmap = glyph_bitmap,
    .glyph_dsc = glyph_dsc,
    .cmaps = cmaps,
    .kern_dsc = NULL,
    .kern_scale = 0,
    .cmap_num = 1,
    .bpp = 4,
    .kern_classes = 0,
    .bitmap_format = 0,
#if LVGL_VERSION_MAJOR == 8
    .cache = &cache
#endif
};



/*-----------------
 *  PUBLIC FONT
 *----------------*/

/*Initialize a public general font descriptor*/
#if LVGL_VERSION_MAJOR >= 8
const lv_font_t ui_icons_16 = {
#else
lv_font_t ui_icons_16 = {
#endif
    .get_glyph_dsc = lv_font_get_glyph_dsc_fmt_txt,    /*Function pointer to get glyph's data*/
    .get_glyph_bitmap = lv_font_get_bitmap_fmt_txt,    /*Function pointer to get glyph's bitmap*/
    .line_height = 16,          /*The maximum line height required by the font*/
    .base_line = 0,             /*Baseline measured from the bottom of the line*/
#if !(LVGL_VERSION_MAJOR == 6 && LVGL_VERSION_MINOR == 0)
    .subpx = LV_FONT_SUBPX_NONE,
#endif
#if LV_VERSION_CHECK(7, 4, 0) || LVGL_VERSION_MAJOR >= 8
    .underline_position = -4,
    .underline_thickness = 2,
#endif
    .dsc = &font_dsc,          /*The custom font data. Will be accessed by `get_glyph_bitmap/dsc` */
#if LV_VERSION_CHECK(8, 2, 0) || LVGL_VERSION_MAJOR >= 9
    .fallback = NULL,
#endif
    .user_data = NULL,
};



#endif /*#if UI_ICONS_16*/
