currygood/MusicPlaySyncSpeakers/Play_Master/components/App/UI/ui_icons_24.c

/*******************************************************************************
 * Size: 24 px
 * Bpp: 4
 * Opts: --font C:/Users/pole/AppData/Local/Temp/uifonts/MaterialIcons-Regular.ttf --size 24 --bpp 4 --format lvgl --no-compress --range 0xe5c4,0xe1a7,0xe0f0,0xe896,0xe029,0xe405,0xe034,0xe037,0xe040,0xe041,0xe8b8,0xe044,0xe045,0xe627,0xe050,0xe63e,0xe648 --lv-include lvgl.h --lv-font-name ui_icons_24 -o ui_icons_24.c
 ******************************************************************************/

#ifdef LV_LVGL_H_INCLUDE_SIMPLE
#include "lvgl.h"
#else
#include "lvgl.h"
#endif

#ifndef UI_ICONS_24
#define UI_ICONS_24 1
#endif

#if UI_ICONS_24

/*-----------------
 *    BITMAPS
 *----------------*/

/*Store the image of the glyphs*/
static LV_ATTRIBUTE_LARGE_CONST const uint8_t glyph_bitmap[] = {
    /* U+E029 "" */
    0x0, 0x0, 0x8, 0xee, 0x80, 0x0, 0x0, 0x0,
    0x0, 0x8f, 0xff, 0xf8, 0x0, 0x0, 0x0, 0x0,
    0xef, 0xff, 0xfe, 0x0, 0x0, 0x0, 0x0, 0xff,
    0xff, 0xff, 0x0, 0x0, 0x0, 0x0, 0xff, 0xff,
    0xff, 0x0, 0x0, 0x0, 0x0, 0xff, 0xff, 0xff,
    0x0, 0x0, 0x0, 0x0, 0xff, 0xff, 0xff, 0x0,
    0x0, 0x0, 0x0, 0xff, 0xff, 0xff, 0x0, 0x0,
    0x0, 0x0, 0xff, 0xff, 0xff, 0x0, 0x0, 0xeb,
    0x0, 0xef, 0xff, 0xfe, 0x0, 0xbe, 0xce, 0x0,
    0x8f, 0xff, 0xf8, 0x0, 0xec, 0x7f, 0x50, 0x8,
    0xee, 0x80, 0x5, 0xf7, 0xe, 0xf3, 0x0, 0x0,
    0x0, 0x3f, 0xe0, 0x3, 0xff, 0x82, 0x0, 0x28,
    0xfe, 0x30, 0x0, 0x2c, 0xff, 0xff, 0xff, 0xc2,
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
    0xff, 0xff, 0xff, 0x60, 0x0, 0xff, 0xff, 0xff,
    0xff, 0xfb, 0x10, 0xff, 0xff, 0xff, 0xff, 0xfb,
    0x10, 0xff, 0xff, 0xff, 0xff, 0x60, 0x0, 0xff,
    0xff, 0xff, 0xc2, 0x0, 0x0, 0xff, 0xff, 0xf8,
    0x0, 0x0, 0x0, 0xff, 0xfe, 0x30, 0x0, 0x0,
    0x0, 0xff, 0xa0, 0x0, 0x0, 0x0, 0x0, 0xff,

    /* U+E045 "" */
    0xff, 0x0, 0x0, 0x0, 0x0, 0xa, 0xff, 0x0,
    0x0, 0x0, 0x3, 0xef, 0xff, 0x0, 0x0, 0x0,
    0x8f, 0xff, 0xff, 0x0, 0x0, 0x2c, 0xff, 0xff,
    0xff, 0x0, 0x6, 0xff, 0xff, 0xff, 0xff, 0x1,
    0xbf, 0xff, 0xff, 0xff, 0xff, 0x1, 0xbf, 0xff,
    0xff, 0xff, 0xff, 0x0, 0x6, 0xff, 0xff, 0xff,
    0xff, 0x0, 0x0, 0x2c, 0xff, 0xff, 0xff, 0x0,
    0x0, 0x0, 0x8f, 0xff, 0xff, 0x0, 0x0, 0x0,
    0x3, 0xef, 0xff, 0x0, 0x0, 0x0, 0x0, 0xa,
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
