currygood/MusicPlaySyncSpeakers/(commit log)

2026-09-30 '第二阶段bt_audio99per完成+华为和小米手机测试成功'
2026-10-01 '完成主节点第四阶段开发+语音唤醒到手机接收到并且回答测试成功'
    [partitions.csv]
2026-10-03 '音频主第五阶段完成+测试成功'
    [partitions.csv]
2026-10-04 音主第六阶段完成+自环UDP组播测试成功
2026-10-05 音主第七阶段完成+LightControl成功测试
2026-10-05 音主第八阶段+UI测试滑动按下等成功+暂未实现接具体实现
2026-10-06 主从八+L1测试+wifi_manager修复
2026-10-08 删除多余audio_bus
2026-10-08 添加关于删除audio_bus的相关文档描述
2026-10-14 Create 功放模块独立供电 - 为什么开发板电源带不动 NS4168.md
2026-10-15 将 测试函数放入debug
2026-10-15 更新说明文档
2026-10-15 从节点：移植 node_role（NVS 运行参数）
    从 Play_Master/components/msystem/node_role/ 原样移植，与主节点逐字节一致：
    角色 / WiFi 凭据 / 音量 / 同步延时 / 组播组，NVS 的唯一读写入口。
    wifi_manager 启动时会经 node_role_get() 读凭据，所以它必须先就位。
    顺带把 mysystem 的 REQUIRES 从 bsp 补齐到这两个模块实际用到的依赖：
    nvs_flash / esp_wifi / esp_netif / esp_event / lwip / esp_timer，
    以及 IDF 6 里已从 freertos 拆成独立组件的 esp_ringbuf。
2026-10-15 从节点：移植 wifi_manager，并修掉饿死 IDLE0 的忙等
    从 Play_Master/components/msystem/wifi_manager/ 移植（STA 连接/自动重连 +
    通道化的 UDP 组播收发）。.h 与主节点逐字节一致，.c 只多出下面这几处修复。
    修的是板级实测故障：上电约 5 秒后 Task WDT 报 "IDLE0 (CPU 0) 未能喂狗"，
    CPU 0 上跑的是 wifi_mcast_rx。根因是本工程 CONFIG_FREERTOS_HZ=100
    （1 tick = 10ms），所以 pdMS_TO_TICKS(2) == 0，而 vTaskDelay(0) 只把 CPU
    让给同优先级的自己、不会给 IDLE0 任何机会；socket 又是 O_NONBLOCK，
    没数据时 recvfrom 立刻返回 -1 —— 整条循环找不到任何阻塞点。
    - wifi_mcast_r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
2026-10-15 从节点：功放补软件音量与采样率直通接口
    NS4168 没有硬件增益，音量只能靠衰减 PCM 实现。不落这一步，主节点下发的
    SYNC_CMD_VOLUME 在从节点就是个空操作。
    - 移植主节点的软件音量：平方曲线 gain=(vol/100)^2，定点实现
    gain = ((uint32_t)vol*vol*32768)/10000u 后 >>15；工作缓冲优先 PSRAM。
    音量 100% 原样直通（零开销），0% 直接 memset 静音。
    - 新增 Amplifier_Set_Sample_Rate()，与 Amplifier_Play_Buffer() 共用同一把
    Amp_WriteMutex。i2s_driver 层是零锁的（源码注释明说互斥由上层负责），
    重配时钟若与写并发会撞在 I2S 重配上。
    @warning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
2026-10-15 从节点：实现音频同步协议（UDP 接收 → Jitter Buffer → 同步出声）
    从节点侧的完整实现，线格式与 Play_Master 的 sync_protocol.h 严格兼容
    （组播 239.0.0.1，音频 5678 / 控制 5679，magic 0xAA55）。
    时钟同步：PING/PONG 四时间戳，RTT=(t4-t1)-(t3-t2)，θ=从时钟-主时钟
    =((t1-t2)+(t4-t3))/2；16 样本滑动窗口取 RTT 最小的 5 个求中值，再限速
    500us/次滑动逼近。组播回环是开着的，所以 PONG 必须用回显的 t1 匹配自己
    未决的 PING（多从机时还要滤掉别人的 PONG）。
    三个任务各自独占一条通道，避免多读者抢同一条 FIFO：
    SyncReceiver_Task prio 11 / Core 0 /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
2026-10-22 实现从节点接收并播放主节点发送的音频数据。发现问题。
    问题：1、随着音乐播放，从节点播放的音乐比主节点提前
    2、lcd屏控制音量大小，只能控制主节点音量，不能控制从节点音量
2026-10-22 修复lcd屏不能控制从节点音量
2026-10-23 1.撤销对扬声器声音大小的软件校准 2.补充文档
2026-10-23 1.实现主机发现从机 2.优化页面性能 3.解决噪音问题
    1.从节点上电连上 WiFi 后，每 3 秒往控制组播组 239.0.0.1:5679 喊一句“我是谁、我的 IP 是多少”；主节点收到后按 MAC 记一笔账，10 秒没再听到就把这条记录标成失联。
    2.将滑动式浏览改成翻页式浏览
    3.解决了播放一段时间后，有概率一直播放噪音的问题。（貌似牺牲了一点音频同步率）
